generalroboticslab/Duke_Humanoid_V2_OpenSource/hardware-site/docs/before-you-start/what-you-get.md

# What you get

| Artefact | Status | Where |
| --- | --- | --- |
| Training and paper reproduction | published | [`duke_humanoid_v2_simulation`](https://github.com/generalroboticslab/duke_humanoid_v2_simulation) |
| Onboard control stack | published | [`duke_humanoid_v2_deploy`](https://github.com/generalroboticslab/duke_humanoid_v2_deploy) |
| Robot model (MJCF), meshes | published | `simulation/asset/duke_v2/humanoid_v21/` |
| Camera gimbal and gripper models | published | `head_cam/`, `parallel_gripper/` beside it |
| Code licence (Apache-2.0), `CITATION.cff` | published | each repository |
| Operator runbook, software safety contract | published | `deploy/control/docs/` |
| Power and data wiring diagrams | published | [Power system](../electrical/power-system.md), [CAN bus](../electrical/can-bus.md) |
| 9 exploded-view CAD animations (unlabelled) | published | Assembly pages |
| [Bill of materials](../bom/index.md) | **TODO**{ .dh-missing } partial | Fasteners and printed parts are placeholders |
| STEP files for machined parts | **TODO**{ .dh-missing } | [CAD downloads](../fabrication/cad-downloads.md) |
| Drawings, tolerances, finishes | **TODO**{ .dh-missing } | None for any machined part |
| STL/3MF and print profiles | **TODO**{ .dh-missing } | [Printing guide](../fabrication/printing-guide.md) |
| Fastener schedule, torque values | **TODO**{ .dh-missing } | Threadlocker only: Loctite 222 |
| Assembly instructions | **TODO**{ .dh-missing } partial | [Assembly](../assembly/index.md) |
| Harness drawings, connector pinouts | **TODO**{ .dh-missing } | Wiring diagrams are not harness drawings |
| Hardware and documentation licences | **TODO**{ .dh-missing } | [Citation and licence](../reference/citation-and-license.md) |
| Tagged release pinning all of the above | **TODO**{ .dh-missing } | [Revisions](../reference/revisions.md) |

!!! missing "MISSING — Scope: in or out for teleoperation setup, training workstation, mocap rig, test fixtures, perception cube targets and tripods, charging bench and gantry"
    *Owner: hardware lead.*
