generalroboticslab/Duke_Humanoid_V2_OpenSource/hardware-site/docs/files/drawings/duke_humanoid_v2_exploded_views_rev01.pdf

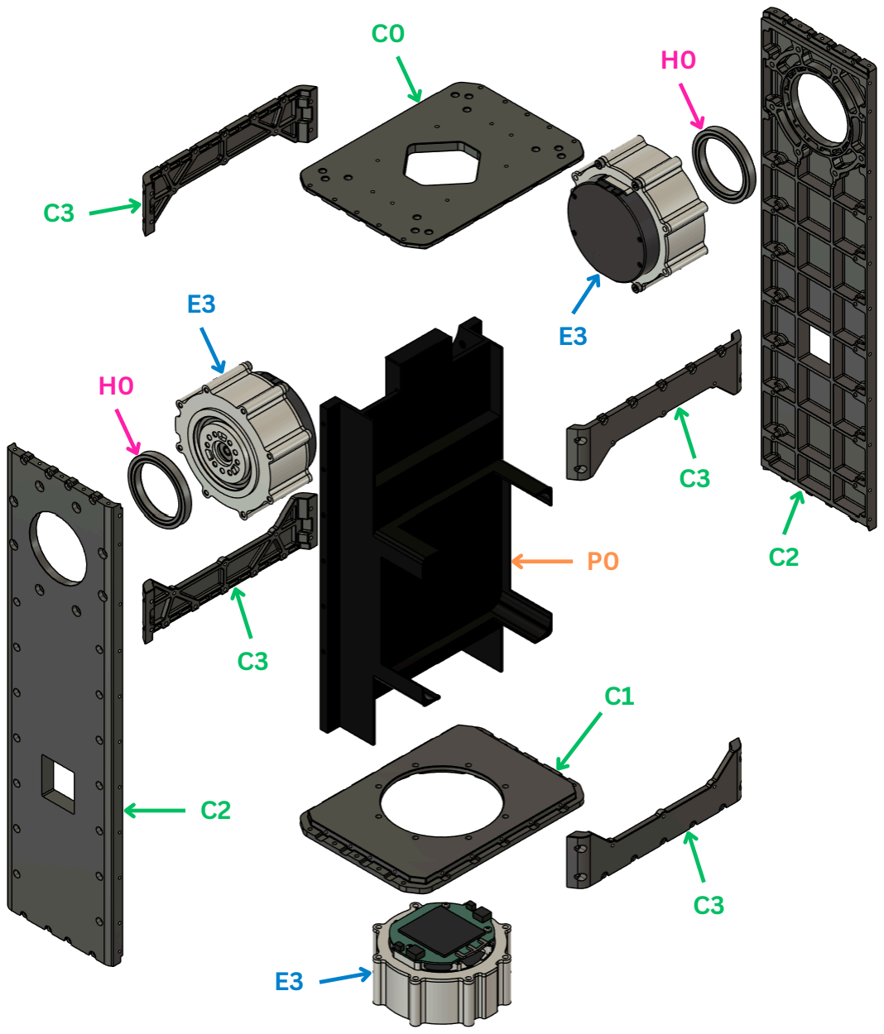
[picture p2: page 1]

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
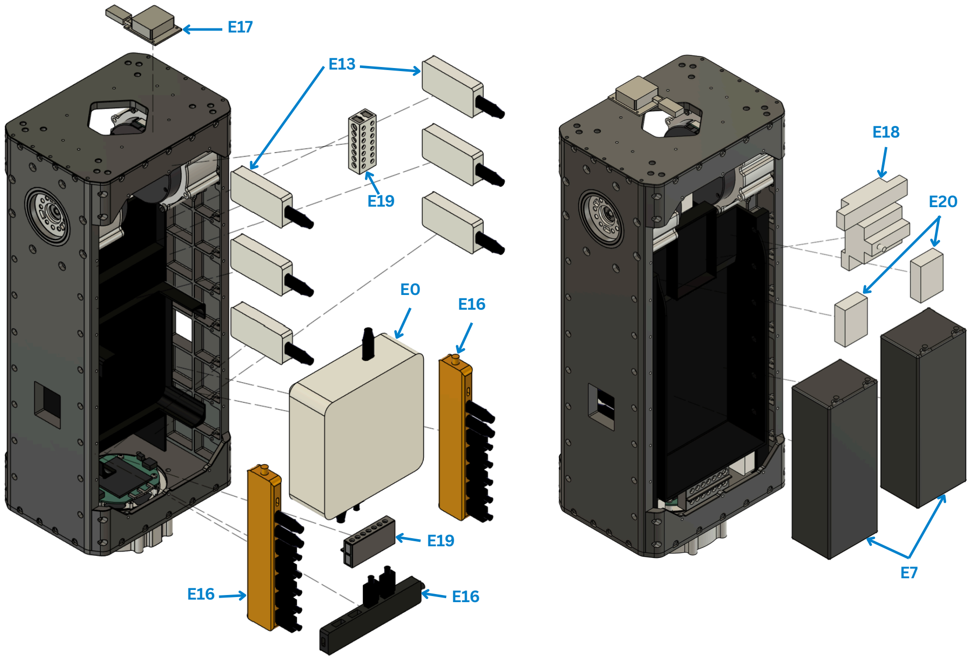
[picture p3: page 2]

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
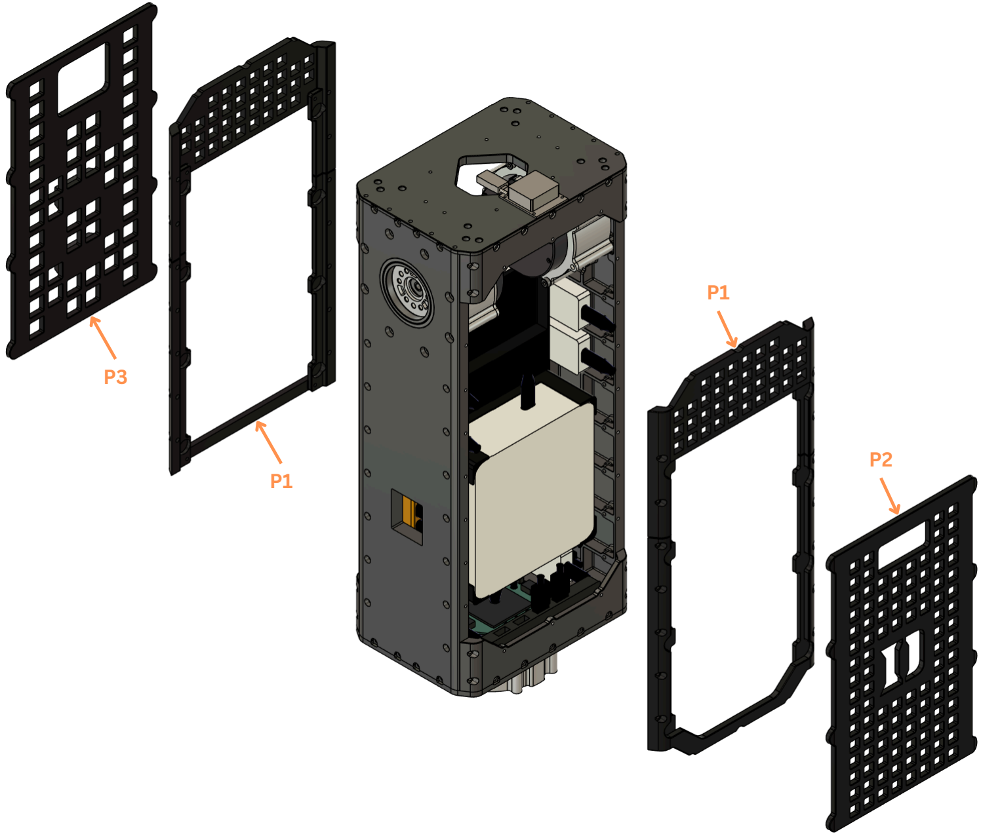
[picture p4: page 3]

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
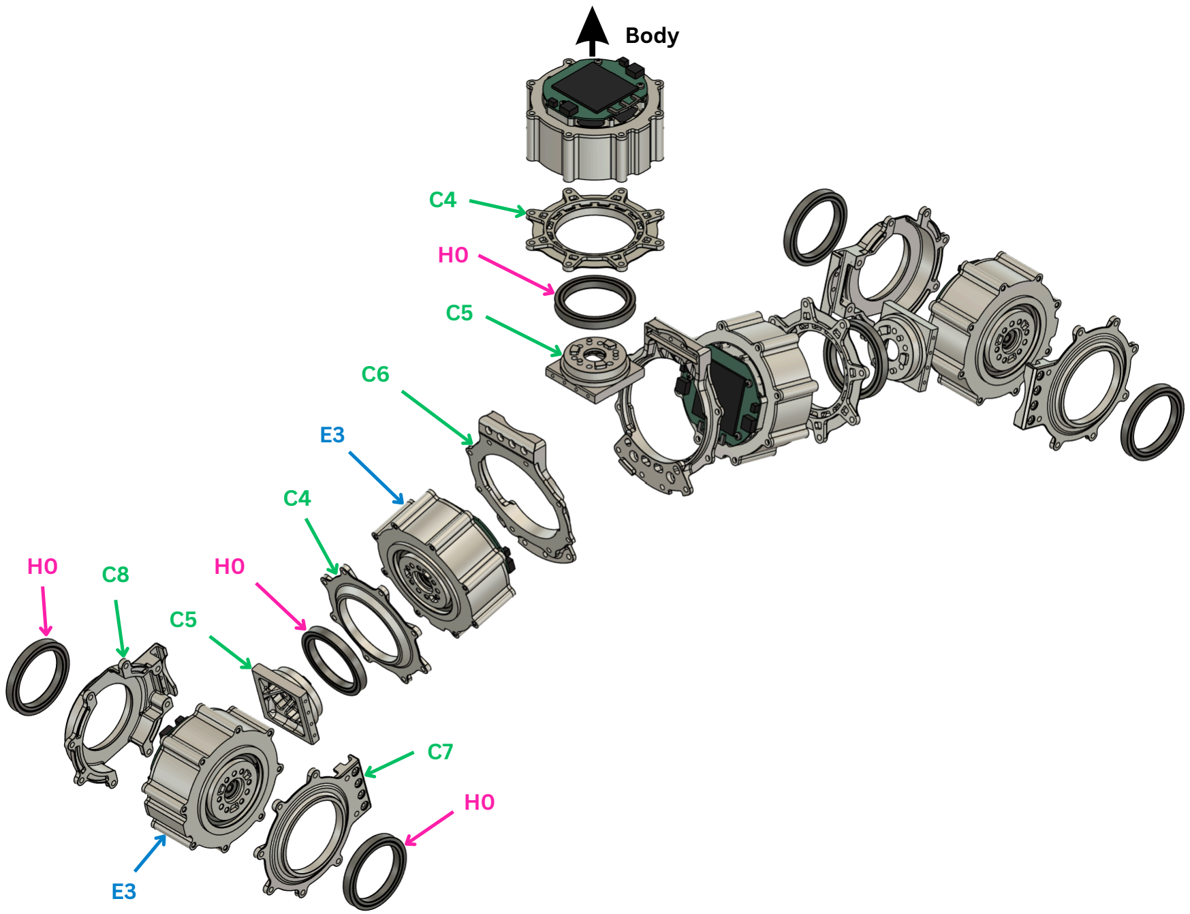
[picture p5: page 4]

Body

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
H C8 0

H0

H0

H0

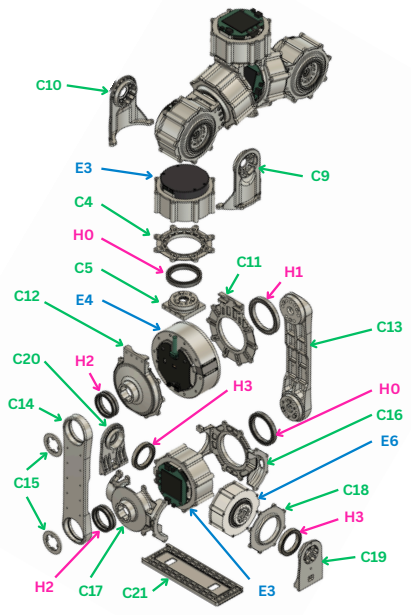
[picture p6: page 5]

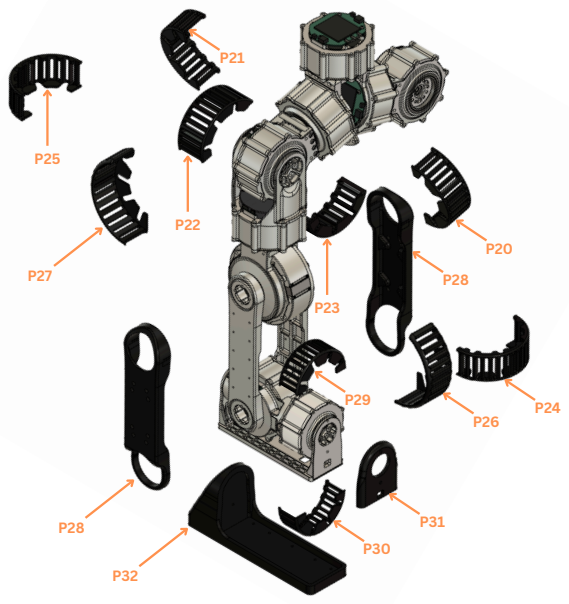
[picture p7: page 6]

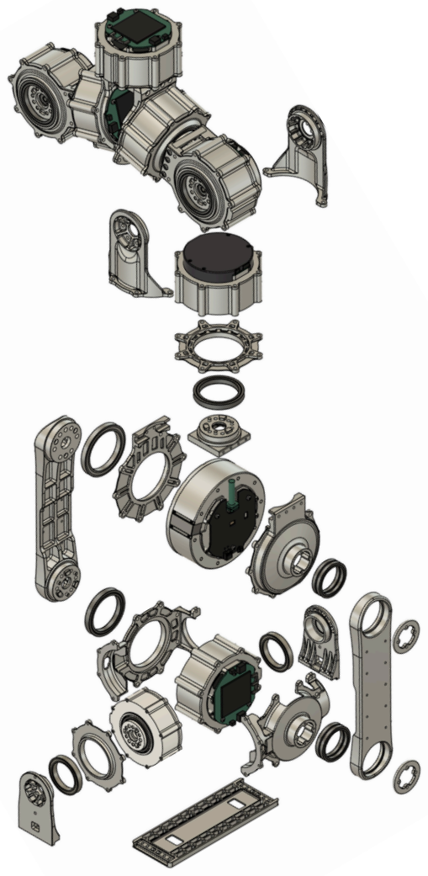
[picture p8: page 7]
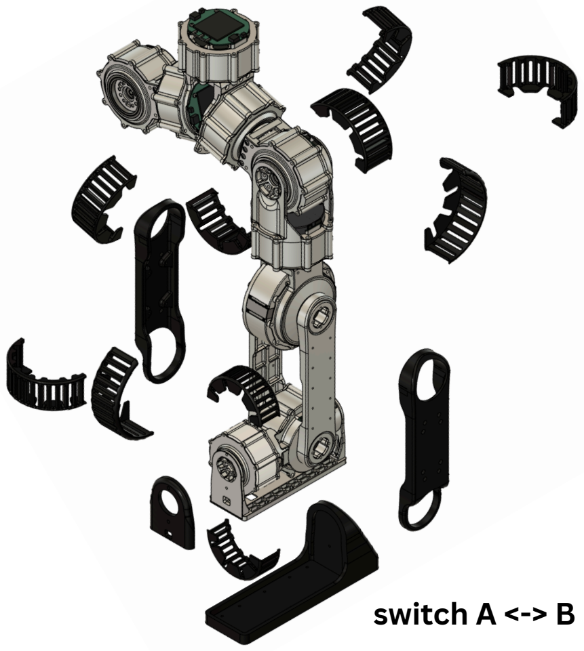
[picture p9: page 8]

# switch A <-> B

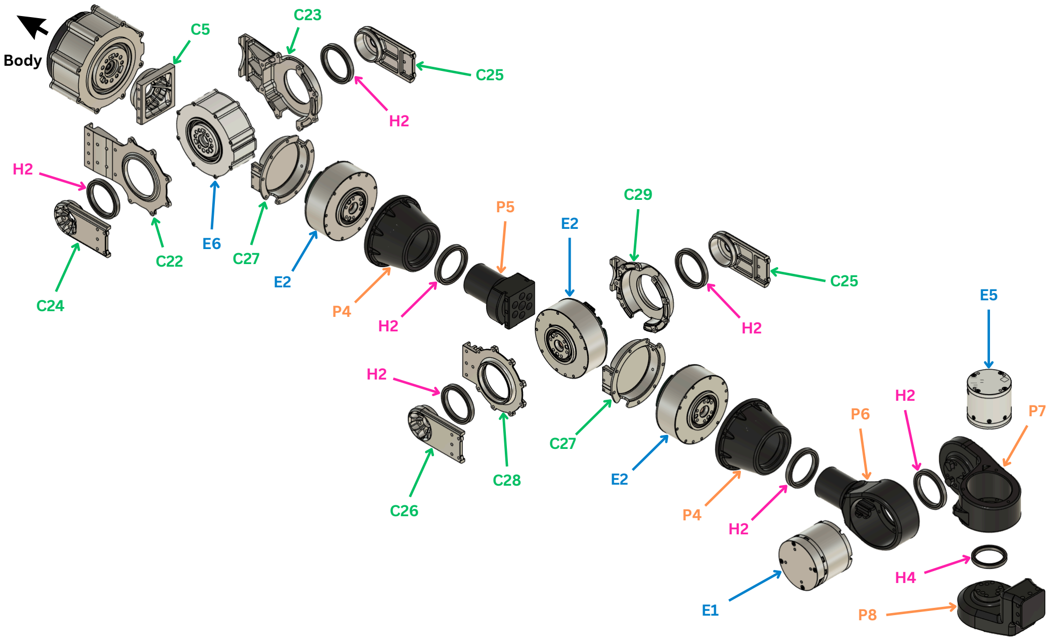
[picture p10: page 9]

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
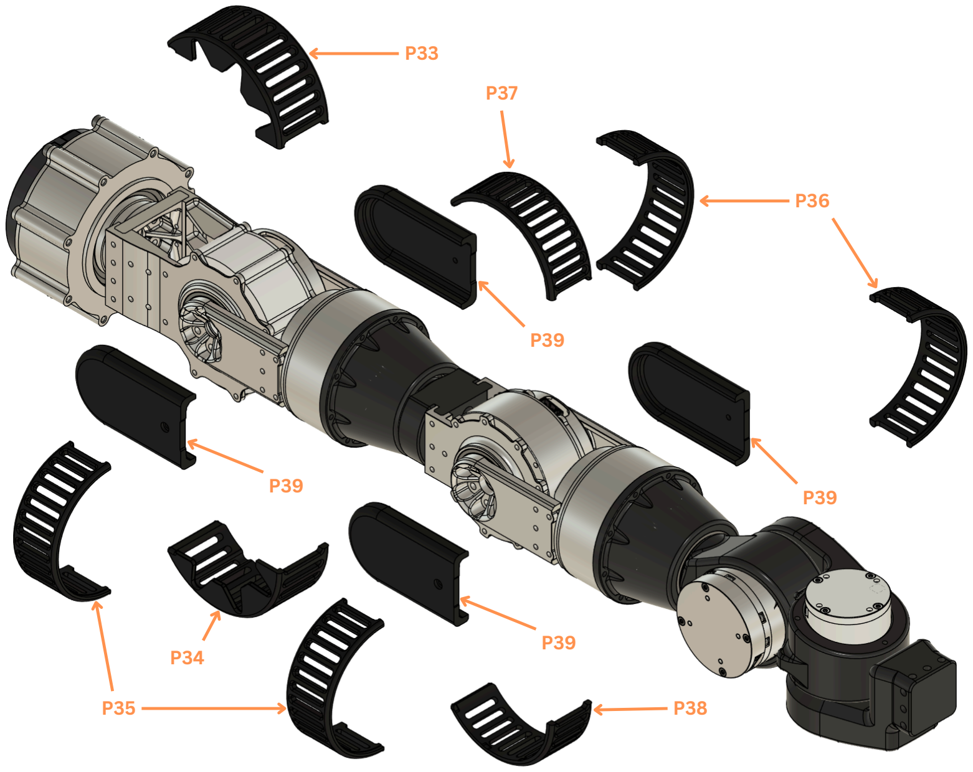
[picture p11: page 10]

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
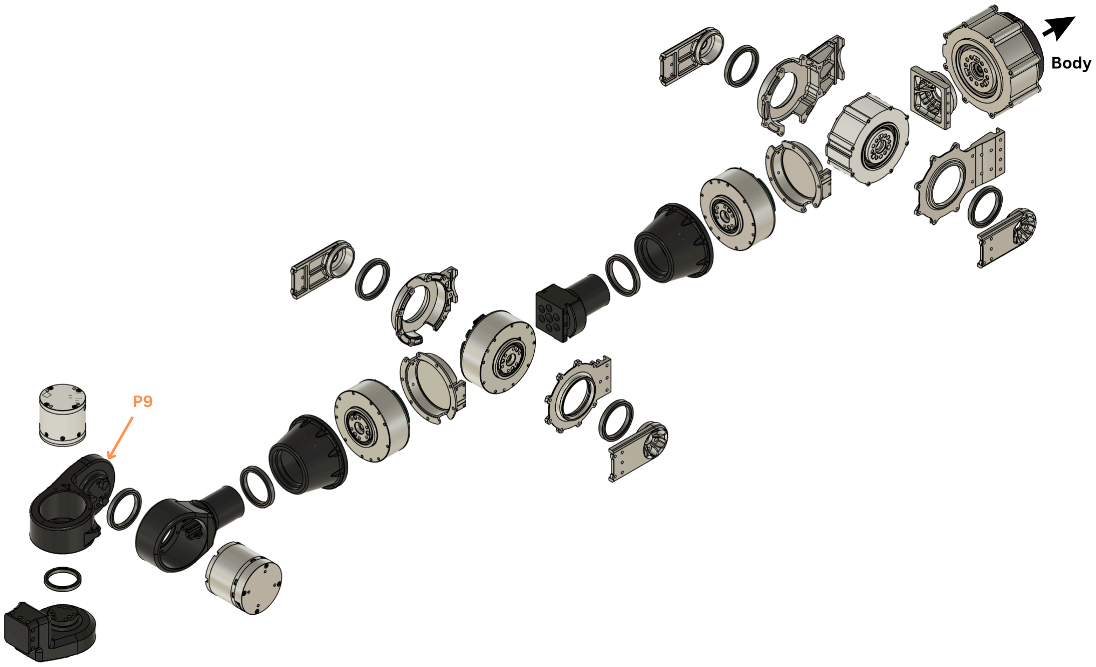
[picture p12: page 11]

B

o

d

y

P

9

# switch A <-> B

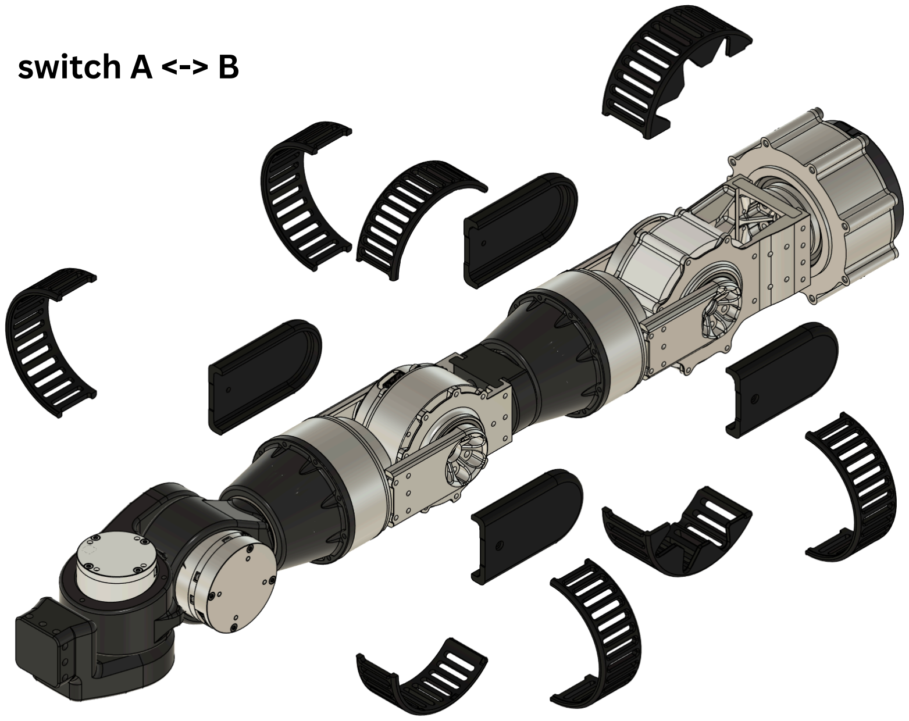
[picture p13: page 12]
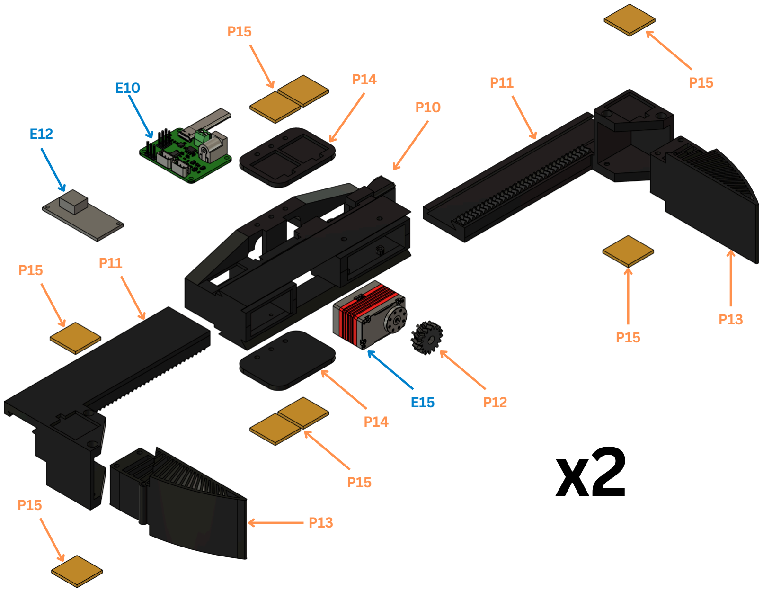
[picture p14: page 13]

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
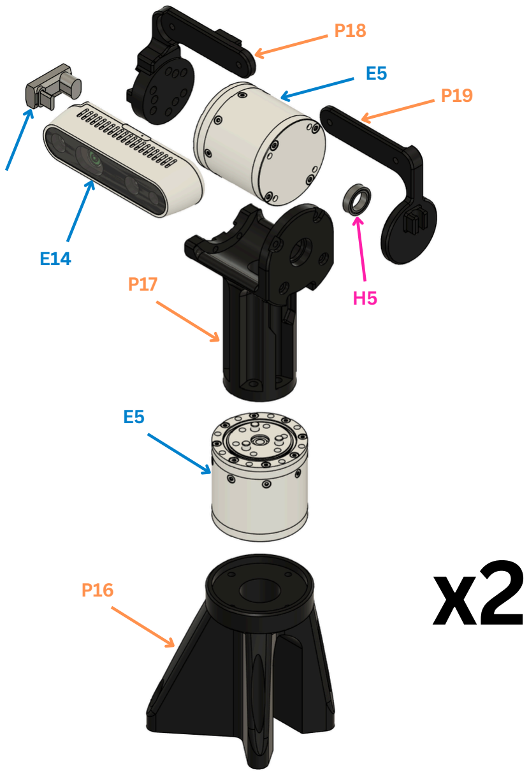
[picture p15: page 14]

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
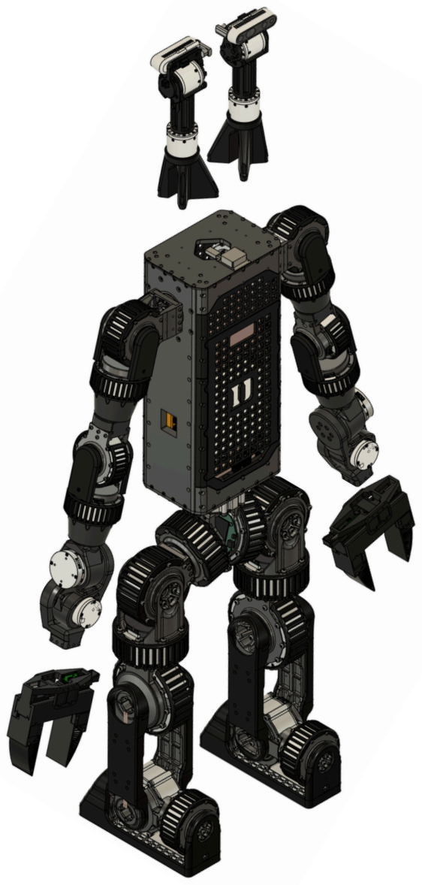
[picture p16: figure]
