generalroboticslab/Duke_Humanoid_V2_OpenSource/hardware-site/docs/assets/exploded/body-back-poster.webp

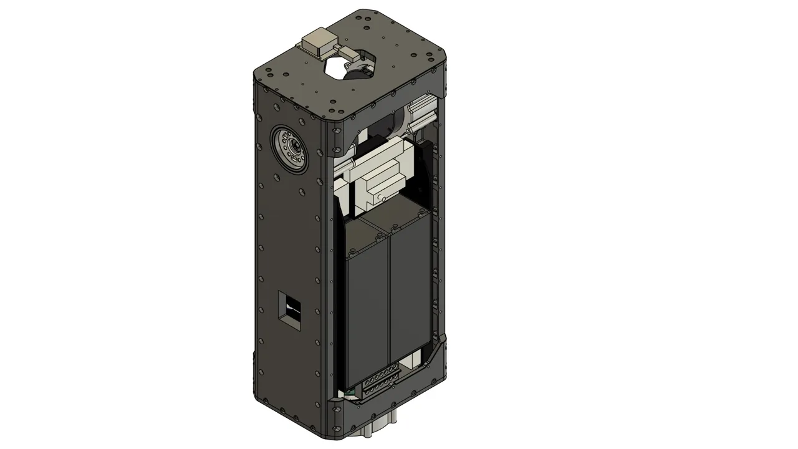
hardware-site/docs/assets/exploded/body-back-poster.webp
