generalroboticslab/Duke_Humanoid_V2_OpenSource/hardware-site/docs/assets/exploded/body-cover-poster.webp

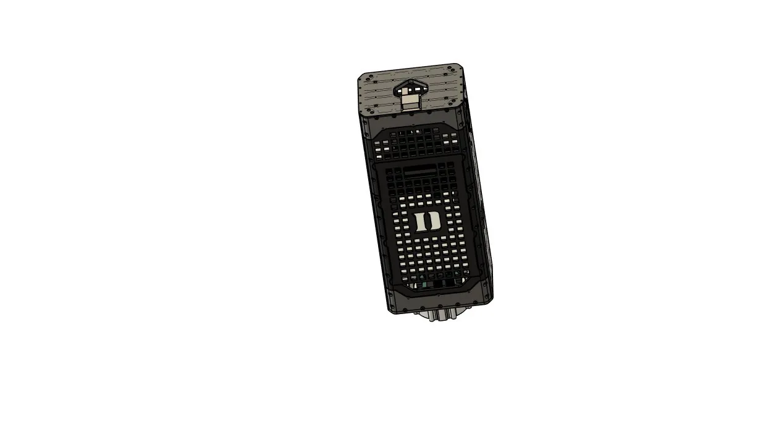
hardware-site/docs/assets/exploded/body-cover-poster.webp
