generalroboticslab/Duke_Humanoid_V2_OpenSource/hardware-site/docs/assets/exploded/camera-mount-poster.webp

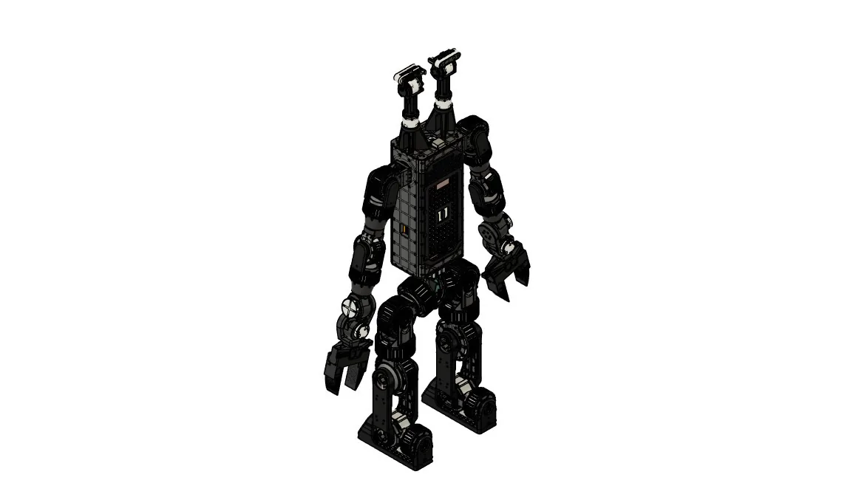
hardware-site/docs/assets/exploded/camera-mount-poster.webp
