generalroboticslab/Duke_Humanoid_V2_OpenSource/hardware-site/docs/assets/exploded/team/08-leg-mirror.webp

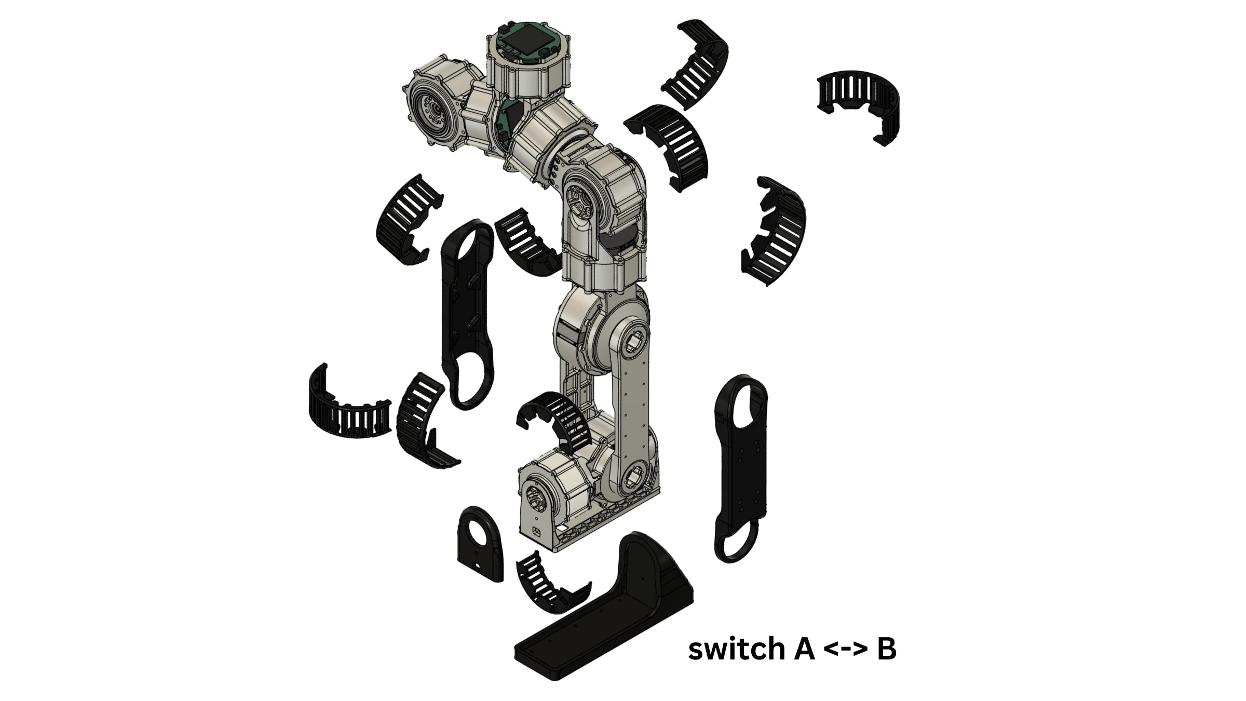
hardware-site/docs/assets/exploded/team/08-leg-mirror.webp
