generalroboticslab/Duke_Humanoid_V2_OpenSource/hardware-site/docs/assets/exploded/team/12-arm-mirror.webp

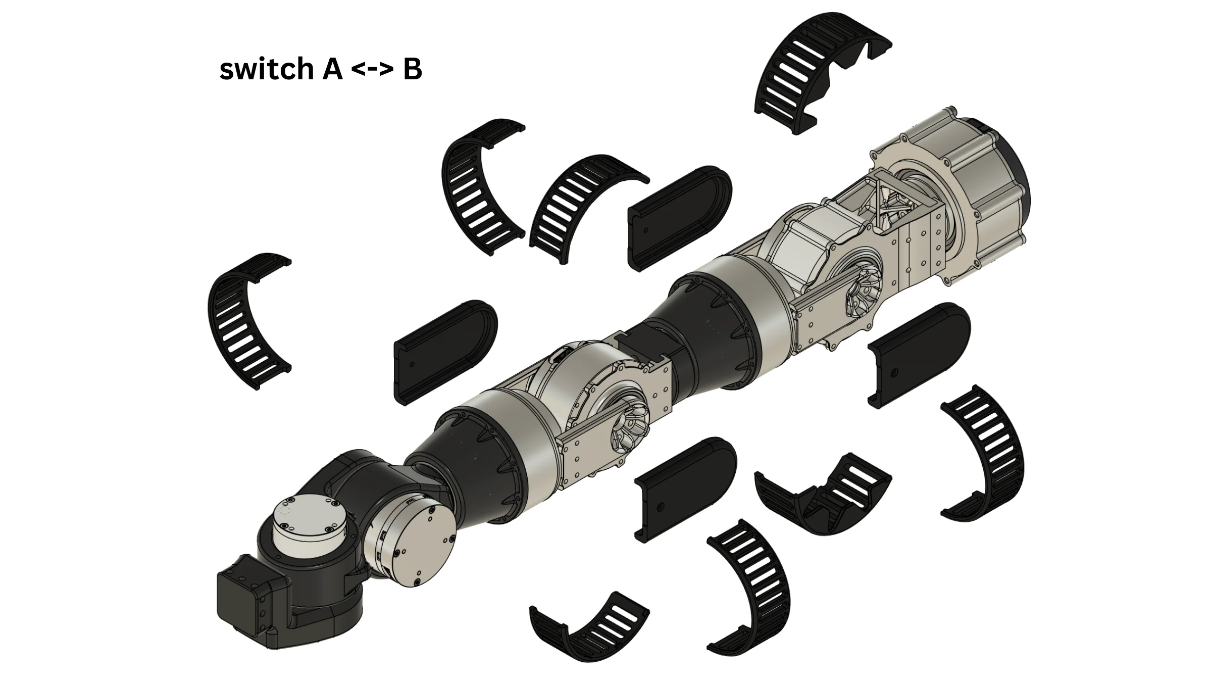
hardware-site/docs/assets/exploded/team/12-arm-mirror.webp
