generalroboticslab/Duke_Humanoid_V2_OpenSource/hardware-site/docs/assets/images/hardware.webp

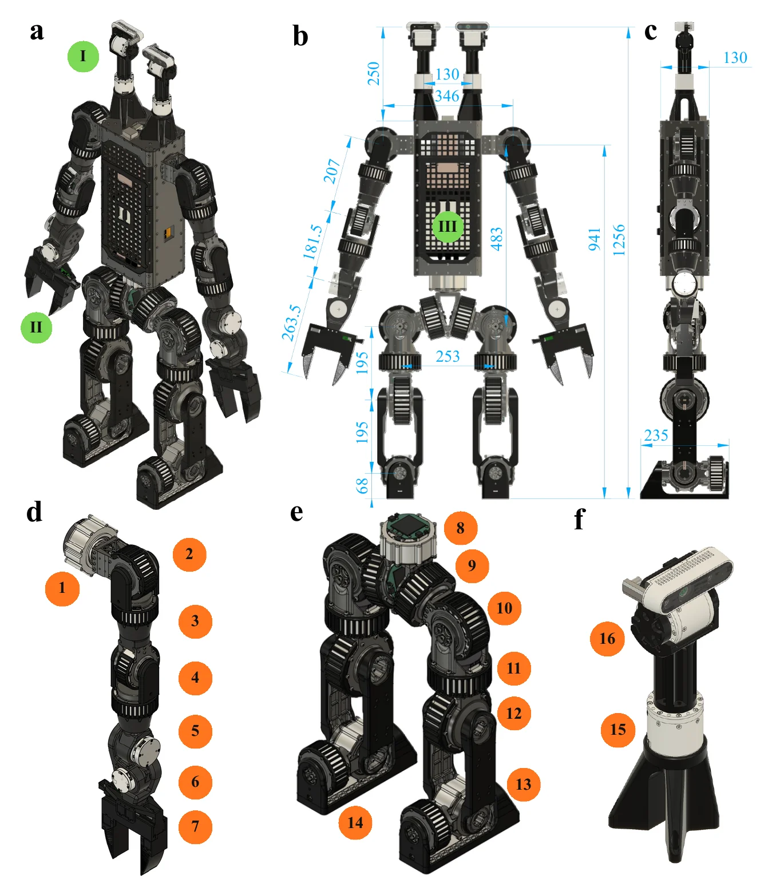
hardware-site/docs/assets/images/hardware.webp
