generalroboticslab/Duke_Humanoid_V2_OpenSource/reference/bom/Duke_Humanoid_V2_BOM_WIP.xlsx

Category | # | Item | Link | Unit Cost | Quantity | Total Cost | link | weight (check urdf) | price per unit weight
Electronics | E0 | MINISFORUM X1-470 Mini PC | https://www.amazon.com/MINISFORUM-X1-Pro-470-Quad-Display-Bluetooth/dp/B0GL2PPG67 | $1295.00 | 1 | $1295.00 | https://www.amazon.com/MINISFORUM-X1-Pro-470-Quad-Display-Bluetooth/dp/B0GL2PPG67
Electronics | E1 | Robstride 00 QDD Actuator | https://www.amazon.com/RobStride-14N-m-Integrated-Actuator-Module/dp/B0GS4XFK7Z/ | $125.00 | 2 | $250.00 | https://www.amazon.com/RobStride-14N-m-Integrated-Actuator-Module/dp/B0GS4XFK7Z/
Electronics | E2 | Robstride 02 QDD Actuator | https://www.amazon.com/RobStride-Integrated-Actuator-Module-Encoders/dp/B0GS5945VP | $145.00 | 6 | $870.00 | https://www.amazon.com/RobStride-Integrated-Actuator-Module-Encoders/dp/B0GS5945VP
Electronics | E3 | Robstride 03 QDD Actuator | https://www.amazon.com/RobStride-60N-m-Integrated-Actuator-Module/dp/B0GY8PJ1MF | $225.00 | 11 | $2475.00 | https://www.amazon.com/RobStride-60N-m-Integrated-Actuator-Module/dp/B0GY8PJ1MF
Electronics | E4 | Robstride 04 QDD Actuator | https://www.amazon.com/RobStride-120N-m-Integrated-Actuator-Module/dp/B0GY8T32L9 | $255.00 | 2 | $510.00 | https://www.amazon.com/RobStride-120N-m-Integrated-Actuator-Module/dp/B0GY8T32L9
Electronics | E5 | Robstride 05 QDD Actuator | https://aifitlab.com/products/robstride-05-motor | $110.00 | 6 | $660.00 | https://aifitlab.com/products/robstride-05-motor
Electronics | E6 | Robstride 06 QDD Actuator | https://aifitlab.com/products/robstride-06-motor | $210.00 | 2 | $420.00 | https://aifitlab.com/products/robstride-06-motor
Electronics | E7 | Zeee 6S Lipo Battery 10000mAh 22.2V x2 | https://zeeebattery.com/products/zeee-6s-lipo-battery-10000mah-22-2v-120c-ec5 | $367.00 | 1 | $367.00 | https://zeeebattery.com/products/zeee-6s-lipo-battery-10000mah-22-2v-120c-ec5
Electronics | E8 | TVS DIODE 53VWM 85VC | https://www.digikey.com/en/products/detail/microchip-technology/M1-5KE62CA/4349574 | $3.56 | 10 | $35.60 | https://www.digikey.com/en/products/detail/microchip-technology/M1-5KE62CA/4349574
Electronics | E9 | Belkin USB A to USB C Cable 2-Pack, 6.6ft | https://www.amazon.com/Belkin-USB-Cable-2-Pack-6-6ft/dp/B0F63XNWN3?th=1 | $14.99 | 2 | $29.98 | https://www.amazon.com/Belkin-USB-Cable-2-Pack-6-6ft/dp/B0F63XNWN3?th=1
Electronics | E10 | Serial Bus Servo Driver Board for ST/SC Series Serial Bus Servos | https://www.waveshare.com/product/robotics/drivers-sensors/drivers/bus-servo-adapter-a.htm | $4.99 | 2 | $9.98 | https://www.waveshare.com/product/robotics/drivers-sensors/drivers/bus-servo-adapter-a.htm
Electronics | E11 | DC 20V-60V to 12V Encased Buck Converter | https://www.amazon.com/gp/product/B0G2SV9PFY?th=1 | $18.99 | 1 | $18.99 | https://www.amazon.com/gp/product/B0G2SV9PFY?th=1
Electronics | E12 | 48V to 12V Buck Converter | https://www.aliexpress.us/item/3256809688561615.html?spm=a2g0o.detail.0.0.4fd9AhcQAhcQuZ | $2.70 | 2 | $5.40 | https://www.aliexpress.us/item/3256809688561615.html?spm=a2g0o.detail.0.0.4fd9AhcQAhcQuZ
Electronics | E13 | CANable PRO V2.0 USBCAN Controller | https://www.amazon.com/Macrobase-PRO-V2-0-Controller-transceiver/dp/B0GJSRZLBV/ | $20.80 | 6 | $124.80 | https://www.amazon.com/Macrobase-PRO-V2-0-Controller-transceiver/dp/B0GJSRZLBV/
Electronics | E14 | RealSense Depth Camera D436 | https://store.realsenseai.com/buy-intel-realsense-depth-camera-d436.html | $354.00 | 2 | $708.00 | https://store.realsenseai.com/buy-intel-realsense-depth-camera-d436.html
Electronics | E15 | Feetech HL-3915-C001 12V 14.2Kg Servo | https://aifitlab.com/products/feetech-hl-3915-servo-motor?variant=44326557417608 | $50.00 | 2 | $100.00 | https://aifitlab.com/products/feetech-hl-3915-servo-motor?variant=44326557417608
Electronics | E16 | Vention USB Hub | https://www.amazon.com/VENTION-Splitter-Expander-Chromebook-Surface/dp/B0D2XWJ99H | $12.99 | 3 | $38.97 | https://www.amazon.com/VENTION-Splitter-Expander-Chromebook-Surface/dp/B0D2XWJ99H
Electronics | E17 | IMU | https://www.robotshop.com/products/syd-dynamics-transducerm-tm171-9-axis-ahrs-w-dual-port-communication | $57.00 | 1 | $57.00 | https://www.robotshop.com/products/syd-dynamics-transducerm-tm171-9-axis-ahrs-w-dual-port-communication
Electronics | E18 | TTocas Surge Protector | https://www.amazon.com/stores/TTocas/page/CAFB5466-628D-45E8-B728-7DB6F3AD931F | $22.99 | 1 | $22.99 | https://www.amazon.com/stores/TTocas/page/CAFB5466-628D-45E8-B728-7DB6F3AD931F
Electronics | E19 | Power Distribution Block Terminals | https://www.aliexpress.us/item/3256808232612352.html | $0.53 | 4 | $2.12 | https://www.aliexpress.us/item/3256808232612352.html
Electronics | E20 | Voltage Sensor for LiPo | https://epowerhobby.com/product/lipo-voltage-checker-1-8s-with-case/ | $14.50 | 2 | $29.00 | https://epowerhobby.com/product/lipo-voltage-checker-1-8s-with-case/
CNC | C0 | Body Plate - Top |  | $64.53 | 1 | $64.53
CNC | C1 | Body Plate - Bottom |  | $64.03 | 1 | $64.03
CNC | C2 | Body Plate - Side |  | $109.14 | 2 | $218.28
CNC | C3 | Body Plate - Front/Back |  | $47.08 | 4 | $188.32
CNC | C4 | Robstride 03 Bearing Retainer |  | $49.34 | 5 | $246.70
CNC | C5 | Robstride 03 Output Shaft |  | $46.78 | 7 | $327.50
CNC | C6 | Hip 1 Motor Bracket |  | $81.59 | 2 | $163.18
CNC | C7 | Hip 2 Motor Bracket |  | $48.59 | 2 | $97.18
CNC | C8 | Hip 2 Bearing Retainer |  | $68.02 | 2 | $136.04
CNC | C9 | Hip 3 Output Shaft |  | $59.96 | 2 | $119.92
CNC | C10 | Hip 3 Supporting Shaft |  | $57.43 | 2 | $114.86
CNC | C11 | Knee Motor Bracket |  | $54.81 | 2 | $109.62
CNC | C12 | Knee Bearing Retainer |  | $81.35 | 2 | $162.70
CNC | C13 | Shank Shaft |  | $113.29 | 2 | $226.58
CNC | C14 | Shank Support |  | $50.05 | 2 | $100.10
CNC | C15 | Shank Joint Cap |  | $16.50 | 4 | $66.00
CNC | C16 | Ankle Motor Bracket |  | $78.82 | 2 | $157.64
CNC | C17 | Ankle Bearing Retainer |  | $95.85 | 2 | $191.70
CNC | C18 | Robstride 06 Bearing Retainer |  | $37.81 | 2 | $75.62
CNC | C19 | Foot Shaft |  | $39.40 | 2 | $78.80
CNC | C20 | Foot Support |  | $34.60 | 2 | $69.20
CNC | C21 | Foot |  | $53.76 | 2 | $107.52
CNC | C22 | Shoulder Motor Bracket |  | $46.69 | 2 | $93.38
CNC | C23 | Shoulder Bearing Retainer |  | $99.24 | 2 | $198.48
CNC | C24 | Shoulder Shaft |  | $31.72 | 2 | $63.44
CNC | C25 | Shoulder/Elbow Support |  | $57.56 | 4 | $230.24
CNC | C26 | Elbow Shaft |  | $31.42 | 2 | $62.84
CNC | C27 | Shoulder/Elbow Coupler |  | $54.25 | 4 | $217.00
CNC | C28 | Elbow Motor Bracket |  | $57.94 | 2 | $115.88
CNC | C29 | Elbow Bearing Retainer |  | $65.65 | 2 | $131.30
3DP | P0 | PC Mount, PLA |  | $3.96 | 1 | $3.96 |  | 0.3175725 | 12.47 | 3.960129075
3DP | P1 | Body Cover, PLA |  | $0.92 | 2 | $1.84 |  | 0.073888034 | 12.47 | 0.921383784
3DP | P2 | Front Plate, PLA |  | $1.21 | 1 | $1.21 |  | 0.096876586 | 12.47 | 1.208051027
3DP | P3 | Back Plate, PLA |  | $1.42 | 1 | $1.42 |  | 0.113809991 | 12.47 | 1.419210588
3DP | P4 | Arm Shaft Cover, Nylon 12 |  | $7.06 | 4 | $28.22 |  | 0.070624732 | 99.9 | 7.055410727
3DP | P5 | Elbow Shaft Coupler, Nylon 12 |  | $6.45 | 2 | $12.91 |  | 0.064589607 | 99.9 | 6.452501739
3DP | P6 | Wrist Shaft, Nylon 12 |  | $7.20 | 2 | $14.41 |  | 0.072102192 | 99.9 | 7.203008981
3DP | P7 | Wrist Housing R, Nylon 12 |  | $13.78 | 1 | $13.78 |  | 0.137950732 | 99.9 | 13.78127813
3DP | P8 | Wrist Output, Nylon 12 |  | $13.01 | 2 | $26.02 |  | 0.130220812 | 99.9 | 13.00905912
3DP | P9 | Wrist Housing L, Nylon 12 |  | $13.78 | 1 | $13.78 |  | 0.137950732 | 99.9 | 13.78127813
3DP | P10 | Gripper Housing, PLA |  | $0.96 | 2 | $1.91 |  | 0.07666666 | 12.47 | 0.9560332502
3DP | P11 | Gripper Rack, PLA |  | $0.56 | 4 | $2.24 |  | 0.044855 | 12.47 | 0.55934185
3DP | P12 | Gear, Nylon 12 |  | $0.13 | 2 | $0.26 |  | 0.00129 | 99.9 | 0.128871
3DP | P13 | UMI Fingers, TPU |  | $0.42 | 4 | $1.69 |  | 0.03395 | 12.47 | 0.4233565
3DP | P14 | AprilTag Housing, PLA |  | $0.04 | 4 | $0.16 |  | 0.003264 | 12.47 | 0.04070208
3DP | P15 | AprilTags, PLA |  | $0.02 | 12 | $0.21 |  | 0.0014 | 12.47 | 0.017458
3DP | P16 | Gimbal Base, PLA |  | $0.65 | 2 | $1.30 |  | 0.05198 | 12.47 | 0.6481906
3DP | P17 | Gimbal Neck, PLA |  | $0.47 | 2 | $0.94 |  | 0.037643 | 12.47 | 0.46940821
3DP | P18 | Gimbal Shaft, PLA |  | $0.16 | 2 | $0.31 |  | 0.012475 | 12.47 | 0.15556325
3DP | P19 | Gimbal Support, PLA |  | $0.15 | 2 | $0.30 |  | 0.012103 | 12.47 | 0.15092441
3DP | P20 | Hip 1 Protection - A, TPU |  | $1.09 | 2 | $2.18 |  | 0.031094 | 34.99 | 1.08797906
3DP | P21 | Hip 1 Protection - B, TPU |  | $1.09 | 2 | $2.18 |  | 0.031094 | 34.99 | 1.08797906
3DP | P22 | Hip 2 Protection - A, TPU |  | $0.91 | 2 | $1.82 |  | 0.025962 | 34.99 | 0.90841038
3DP | P23 | Hip 2 Protection - B, TPU |  | $0.91 | 2 | $1.82 |  | 0.025962 | 34.99 | 0.90841038
3DP | P24 | Hip 3 Protection - A, TPU |  | $1.09 | 2 | $2.18 |  | 0.031094 | 34.99 | 1.08797906
3DP | P25 | Hip 3 Protection - B, TPU |  | $1.09 | 2 | $2.18 |  | 0.031094 | 34.99 | 1.08797906
3DP | P26 | Knee Protection - A, TPU |  | $0.92 | 2 | $1.83 |  | 0.026159 | 34.99 | 0.91530341
3DP | P27 | Knee Protection - B, TPU |  | $0.92 | 2 | $1.83 |  | 0.026159 | 34.99 | 0.91530341
3DP | P28 | Shank Protection, TPU |  | $1.56 | 4 | $6.26 |  | 0.044714 | 34.99 | 1.56454286
3DP | P29 | Foot Protection - Top, TPU |  | $0.58 | 2 | $1.17 |  | 0.016691 | 34.99 | 0.58401809
3DP | P30 | Foot Protection - Bot, TPU |  | $0.58 | 2 | $1.17 |  | 0.016691 | 34.99 | 0.58401809
3DP | P31 | Foot Protection - Front, TPU |  | $0.49 | 2 | $0.97 |  | 0.013896 | 34.99 | 0.48622104
3DP | P32 | Foot Protection - Sole, TPU |  | $4.14 | 2 | $8.28 |  | 0.118364 | 34.99 | 4.14155636
3DP | P33 | Shoulder 2 Protection - A, TPU |  | $0.44 | 2 | $0.87 |  | 0.012454 | 34.99 | 0.43576546
3DP | P34 | Shoulder 2 Protection - B, TPU |  | $0.44 | 2 | $0.87 |  | 0.012454 | 34.99 | 0.43576546
3DP | P35 | Arm Roll Protection - Front, TPU |  | $0.29 | 4 | $1.16 |  | 0.008313 | 34.99 | 0.29087187
3DP | P36 | Arm Roll Protection - Back, TPU |  | $0.29 | 4 | $1.16 |  | 0.008313 | 34.99 | 0.29087187
3DP | P37 | Elbow Protection - A, TPU |  | $0.21 | 2 | $0.43 |  | 0.006124 | 34.99 | 0.21427876
3DP | P38 | Elbow Protection - B, TPU |  | $0.21 | 2 | $0.43 |  | 0.006124 | 34.99 | 0.21427876
3DP | P39 | Arm Roll Shaft Protection, TPU |  | $0.27 | 8 | $2.13 |  | 0.007623 | 34.99 | 0.26672877
Hardware | H0 | 45x58x7 Ball Bearing | https://www.amazon.com/XIKE-6809-2RS-Bearings-45x58x7mm-Pre-Lubricated/dp/B09D2J9P82 | $3.00 | 13 | $39.00
Hardware | H1 | 50x65x7 Ball Bearing | https://www.amazon.com/uxcell-6810-2RS-Groove-Bearings-Double/dp/B082PYMQFL | $4.00 | 2 | $8.00
Hardware | H2 | 35x44x5 Ball Bearing | https://www.amazon.com/XIKE-6707-2RS-Bearings-35x44x5mm-Pre-Lubricated/dp/B09D2XN464/ | $3.00 | 18 | $54.00
Hardware | H3 | 35x47x7 6807-2RS Ball Bearing | https://www.amazon.com/XIKE-6807-2RS-Bearings-35x47x7mm-Pre-Lubricated/dp/B09D2ZHNPH/ | $4.00 | 4 | $16.00
Hardware | H4 | 30x37x4 6706-2RS Ball Bearing | https://www.amazon.com/XIKE-6706-2RS-Bearings-30x37x4mm-Pre-Lubricated/dp/B09D35XB19 | $2.00 | 2 | $4.00
Hardware | H5 | 10x15x4 Ball Bearing | https://www.amazon.com/uxcell-6700-2RS-Groove-Bearings-Double/dp/B082PR3DFZ | $1.00 | 2 | $2.00
Hardware | H6 | M3x10 Torx Button Head Screw | https://www.mcmaster.com/90991A114/ | $5.16 | 5 | $25.80
Hardware | H7 | M4x8 Torx Button Head Screw | https://www.mcmaster.com/90991A121/ | $7.20 | 1 | $7.20
Hardware | H8 | M4x10 Torx Button Head Screw | https://www.mcmaster.com/90942A118/ | $5.78 | 4 | $23.12
Calibration |  |  |  |  |  | $0.00
SUM |  |  |  | $12575.30 | 299 | $12575.30
