generalroboticslab/Duke_Humanoid_V2_OpenSource/reference/bom/duke-humanoid-v2_BOM.xlsx

Sheet: Sheet1
 | ITEM | LINK (shortened if possible) | UNIT COST | QUANTITY | TOTAL
ELECTRONICS | MINISFORUM X1-470 Mini PC | amazon.com/MINISFORUM-Desktop-Computer-HDMI2-1-Graphics/dp/B0GM43XCGT | $1295.00 | 1 | $1295.00
 | Robstride 00 QDD Actuator | https://www.robstride.com/products/robStride00 | $125 | 2 | $250.00
 | Robstride 02 QDD Actuator | https://www.robstride.com/products/robStride02 | $145 | 6 | $870.00
 | Robstride 03 QDD Actuator | https://www.robstride.com/products/robStride03 | $225 | 11 | $2475.00
 | Robstride 04 QDD Actuator | https://www.robstride.com/products/robStride04 | $255 | 2 | $510.00
 | Robstride 05 QDD Actuator | https://www.robstride.com/products/robStride05 | $110 | 6 | $660.00
 | Robstride 06 QDD Actuator | https://www.robstride.com/products/robStride06 | $210 | 4 | $840.00
 | Zeee 6S Lipo Battery 10000mAh 22.2V x2 | https://www.amazon.com/dp/B0BHQX8XQX?lv=shuf&channelId=500&plpRedirect=mhFallback | $306.00 | 1 | $306.00
 | TVS DIODE 53VWM 85VC | https://www.digikey.com/en/products/detail/microchip-technology/M1-5KE62CA/4349574 | $3.56 | 10 | $35.60
 | Belkin USB A to USB C Cable 2-Pack, 6.6ft | https://www.amazon.com/Belkin-USB-Cable-2-Pack-6-6ft/dp/B0F63XNWN3?th=1 | $14.99 | 2 | $29.98
 | Serial Bus Servo Driver Board for ST/SC Series Serial Bus Servos | https://www.waveshare.com/product/robotics/drivers-sensors/drivers/bus-servo-adapter-a.htm | $4.99 | 2 | $9.98
 | DC 20V-60V to 12V Encased Buck Converter | https://www.amazon.com/gp/product/B0G2SV9PFY?th=1 | $18.99 | 1 | $18.99
 | 48V to 12V Buck Converter | https://www.aliexpress.us/item/3256809688561615.html?spm=a2g0o.detail.0.0.4fd9AhcQAhcQuZ | $2.70 | 2 | $5.40
 | CANable PRO V2.0 USBCAN Controller | https://www.amazon.com/Macrobase-PRO-V2-0-Controller-transceiver/dp/B0GJSRZLBV/ | $20.80 | 6 | $124.80
 | RealSense Depth Camera D436 | https://store.realsenseai.com/buy-intel-realsense-depth-camera-d436.html | $354 | 2 | $708.00
 | Feetech HL-3915-C001 12V 14.2Kg Servo | https://aifitlab.com/products/feetech-hl-3915-servo-motor?variant=44326557417608 | $50 | 2 | $100.00
 | Vention USB Hub | https://www.amazon.com/VENTION-Splitter-Expander-Chromebook-Surface/dp/B0D2XWJ99H | $12.99 | 3 | $38.97
 | IMU | https://www.robotshop.com/products/syd-dynamics-transducerm-tm171-9-axis-ahrs-w-dual-port-communication | $57 | 1 | $57.00
HARDWARE | example: fasteners, nuts |  |  |  | $0.00
 | 5PCS Amass XT30(2+2). select Color (fist option): XT30U(2 2)-F | https://www.aliexpress.us/item/3256807585110718.html | $5.00 | 4 | $20.00
 | Frienda 30 Pairs XT30 Connectors Male and Female Connectors Plugs Set | https://www.amazon.com/Connectors-Female-Pieces-Shrink-Battery/dp/B0BB2XF5SQ?th=1 | $14.99 | 1 | $14.99
 | Alex Tech 25ft - 1/4 inch Cord Protector Wire Loom Tubing Cable Sleeve | https://www.amazon.com/Alex-Tech-10ft-Protector-Sleeving/dp/B07FW86XV6/?th=1 | $13.99 | 1 | $13.99
 | Alex Tech 25ft - 3/8 inch Cord Protector Wire Loom Tubing Cable Sleeve | https://www.amazon.com/Alex-Tech-25ft-Protector-Sleeving/dp/B07FW4M7Z8/?th=1 | $15.98 | 1 | $15.98
 | Duttek Short USB C Extension Cable 40Gbps | https://www.amazon.com/dp/B0CWGW3LTJ?th=1 | $9.76 | 2 | $19.52
 | USB A to USB C 3.1 Gen 2 Cable | https://www.amazon.com/Transfer-Charging-Samsung-SanDisk-Portable/dp/B09H2LLXPN?th=1 | $9.99 | 6 | $59.94
 | 1ft Short USB-C Cable with Right-Angle Plug | https://www.amazon.com/Afterplug-Right-Angle-Charging-Ultra-Flexible-Silicone/dp/B0G2LVGZ39 | $12.99 | 1 | $12.99
MATERIALS | CNC Leg Parts | TODO: BREAK INTO INDIVIDUAL CNC PARTS
 | CNC Arm Parts
 | CNC Body Parts
 | TPU
 | PLA
 | Nylon Powder for SLS
 |  |  |  | TOTAL CNC | 6389.86
 |  |  |  | GRAND TOTAL | $14881.99

Sheet: Sheet2
CNC_leg18_x2_foot_plate | 107.52 | 2pcs | 2076.98
CNC_leg17_x2_ankle_roll_support_shaft | 69.2 | 2 | 1374.19
CNC_leg05_x2_hip_roll_back_bearing_retainer | 136.04 | 2 | $1317.87
CNC_leg03_x5_RS03_shaft_bearing_retainer | 246.7 | 5 | $1620.82
CNC_leg06_x2_hip_roll_output_shaft | 119.92 | 2 | 6389.86
CNC_leg11_x2_knee_support_shank | 100.1 | 2
CNC_leg10_x2_knee_output_shank | 226.58 | 2
CNC_leg15_x2_RS06_shaft_bearing_retainer | 75.62 | 2
CNC_leg13_x2_ankle_pitch_front | 157.64 | 2
CNC_leg04_x2_hip_roll_front_bearing_retainer | 97.18 | 2
CNC_leg07_x2_hip_roll_support_shaft | 114.86 | 2
CNC_leg08_x2_knee_front_bearing_retainer | 109.62 | 2
CNC_leg16_x2_ankle_roll_output_shaft | 78.8 | 2
CNC_leg01_x2_hip_center_back | 163.18 | 2
CNC_leg02_x7_RS03_shaft_coupler | 274.02 | 6
CNC_arm13_x2_RS05_shaft_coupler | 109.8 | 3
CNC_leg14_x2_ankle_pitch_back | 191.7 | 2
CNC_leg09_x2_knee_motor_back_cover | 162.7 | 2
CNC_arm06_x4_RS02_shaft_coupler | $146.76 | 4
CNC_arm04_x4_shoulder_roll_support_shaft | $115.12 | 4
CNC_body03_x1_top_plate | $64.53 | 1
CNC_arm05_x4_RS02_shaft_bearing | $123.08 | 4
CNC_arm03_x2_shoulder_roll_output_shaft | $63.44 | 2
CNC_body02_x2_side_plate | $218.28 | 2
CNC_leg02_x7_RS03_shaft_coupler | $100.26 | 2
CNC_body04_x4_front_plate | $188.32 | 4
CNC_arm11_x2_wrist_roll | $239.58 | 2
CNC_arm10_x4_r03_back_cover | $217.00 | 4
CNC_arm09_x2_elbow_output_shaft | $62.84 | 2
CNC_body01_x1_bottom_plate | $64.03 | 1
CNC_arm01_x2_shoulder_roll_front_bearing | $93.38 | 2
CNC_arm08_x2_elbow_back_bearing | $131.30 | 2
CNC_arm12_x2_wrist_pitch | $192.52 | 2
CNC_arm07_x2_elbow_front_bearing | $115.88 | 2
CNC_arm02_x2_shoulder_roll_back_bearing | $198.48 | 2
CNC_leg12_x4_lower_leg_bearing | $82.50 | 5
02_hip_0_m04_back_bracket_x2 | $159.94 | 2
B6_single_leg_tester_plate | $101.38 | 1
08_hip_1_back_shaft_x2 | $37.93 | 1
B5_body_shelf | $93.71 | 1
13_knee_front_shaft_x2 | $60.82 | 1
17_ankle_0_back_cover_x2 | $76.78 | 1
15_ankle_cap_x4 | $38.64 | 2
B1_body_base_plate | $95.01 | 1
05_hip_1_front_bracket_x2 | $49.62 | 1
18_ankle_1_back_retainer_x2 | $23.37 | 1
22_foot_plate_x2 | $22.48 | 1
12_knee_m04_back_cover_x2 | $72.92 | 1
21_ankle_1_front_shaft_x4 | $75.00 | 2
04_hip_1_m04_shaft_x2 | $41.28 | 1
06_hip_1_back_bracket_x2 | $70.42 | 1
09_hip_2_back_cover_x2 | $63.00 | 1
10_m03_front_retainer_x2 | $40.06 | 1
01_m03_shaft_x3 | $92.77 | 2
16_ankle_0_front_retainer_x2 | $53.34 | 1
03_hip_1_m04_front_retainer_x2 | $54.29 | 1
B3_body_side_plate_x2 | $198.11 | 2
B2_body_top_plate | $126.84 | 1
14_knee_back_shaft_x2 | $59.48 | 1
19_ankle_1_m02_back_cover_x2 | $49.79 | 1
11_knee_m04_front_retainer_x2 | $48.44 | 1
07_hip_1_front_shaft_x2 | $38.04 | 1
20_ankle_1_front_retainer_x2 | $38.68 | 1
