generalroboticslab/Duke_Humanoid_V2_OpenSource/reference/bom/toddlerbot_BOM_release.csv

Type | Item Description | Vendor Link | Alternative Link | Unit Price | QTY (2XC) | Total Price | QTY (2XM) | Total Price | Note
Assembed Kit | ToddlerBot 2.0 Fully Assembled | https://shop.wowrobo.com/products/toddlerbot-2-0-assembly-version | https://item.taobao.com/item.htm?ft=t&id=970730280172 | $4,299 | 1 | $4,299.00 |  |  | Buy your own Jetson Orin NX 16G ($955), WiFi ($27.85). and Battery (~$50)
Disclaimer | We are not affiliated with or endorse this company in any way. We have not tested or validated the product. Any such offerings are independent of our project.
Essentials (Highlighted are additional things to buy from 1.0 to 2.0)
Motors | DYNAMIXEL 2XC430-W250-T | DYNAMIXEL 2XC430-W250-T - ROBOTIS |  | $298.89 | 2 | $597.78 | 6 | $1,793.34
 | DYNAMIXEL 2XL430-W250-T | DYNAMIXEL 2XL430-W250-T - ROBOTIS |  | $149.39 | 6 | $896.34 | 0 | $0.00
 | DYNAMIXEL XC330-T288-T | DYNAMIXEL XC330-T288-T - ROBOTIS |  | $103.39 | 6 | $620.34 | 6 | $620.34
 | DYNAMIXEL XC430-T240BB-T | DYNAMIXEL XC430-T240BB-T - ROBOTIS |  | $137.89 | 4 | $551.56 | 4 | $551.56
 | DYNAMIXEL XM430-W210-T | DYNAMIXEL XM430-W210-T - ROBOTIS |  | $310.39 | 4 | $1,241.56 | 4 | $1,241.56
 | DYNAMIXEL XM430-W350-T | DYNAMIXEL XM430-W350-T - ROBOTIS |  | $310.39 | 0 | $0.00 | 4 | $1,241.56
 | DYNAMIXEL HN11-I101 Set | HN11-I101 Set - ROBOTIS |  | $8.05 | 10 | $80.50 | 8 | $64.40
 | DYNAMIXEL HN12-I101 Set | HN12-I101 Set - ROBOTIS |  | $20.47 | 4 | $81.88 | 6 | $122.82
 |  |  |  |  | $ of 2XC | $4,069.96 | $ of 2XC+ | $1,565.62
Parallel Gripper | DYNAMIXEL XC330-T288-T | DYNAMIXEL XC330-T288-T - ROBOTIS |  | $103.39 | 2 | $206.78
Computers | Jetson Orin NX 16G | NVIDIA® Jetson Orin™ NX 16GB AI Device - reComputer J4012 |  | $955.00 | 1 | $955.00 |  |  | Can replace with Jetson Orin Nano if budget is tight
 | M.2 CB375NF Wifi Card | Amazon.com: AW-CB375NF Wireless NIC, 2.4G/5GHz Dual-Band WiFi 5 Supports BLE, NGFF (M.2 A/E Key) Interface, for Jetson Xavier NX/Jetson Orin NX/Jetson Orin Nano : Electronics |  | $18.36 | 1 | $18.36
 | WiFi Antenna | Amazon.com: WiFi 6E Antenna IPX MHF4 Tri-Band 6GHz 5GHz 2.4GHz Internal Laptop Wi-Fi Antennas for AX200 AX210 1675X M.2 NGFF Card : Electronics |  | $9.49 | 1 | $9.49
Sensors | FIsheye Camera | Amazon.com: Arducam 1080P Low Light WDR Ultra Wide Angle USB Camera Module for Computer, 2MP CMOS IMX291 160 Degree Fisheye Mini UVC USB2.0 Webcam Board with Microphone, 3.3ft Cable for Windows Linux Mac OS : Electronics |  | $49.99 | 2 | $99.98
 | Phone Speaker | https://www.amazon.com/MMOBIEL-Replacement-iPhone-Plus-Screwdriver/dp/B079Z85L4N | Mmobiel Loud Speaker Compatible With Iphone Se 2022 Se 2020 | Desertcart Brunei | $5.99 | 1 | $5.99
 | Speaker Driver | Amazon.com: HiLetgo 3pcs M38 Wireless Bluetooth MP3 Audio Receiver Board BLT 4.2 mp3 Lossless decoder Bluetooth 4.2 Audio Receiver Board Wireless Stereo Sound Module : Electronics |  | $7.99 | 1 | $7.99
 | BNO085 IMU | Adafruit 9-DOF Orientation IMU Fusion Breakout - BNO085 (BNO080) [STEMMA QT / Qwiic] : ID 4754 : Adafruit Industries, Unique & fun DIY electronics and kits |  | $24.95 | 1 | $24.95
Hardware | M2*6 Pre-coated Screws | https://e.tb.cn/h.hFvWE8HfWc1pSka?tk=5rJm4l9H7bX |  | $0.01 | 200 | $1.80 |  |  | It is recommended to replace all positions using this type of screw with pre-coated screws or you have to use the threadlocker
 | M2 Screw Kit | Amazon.com: Kadrick 304 Stainless Steel Screws,660 Pcs M2 Screw Assortment,Button Head Socket Cap Screws Kit,M2x4mm,6mm,8mm,10mm,12mm,16mm Metric Bolts Nuts Washers Kit with 1 Hex Allen Wrench : Industrial & Scientific |  | $8.99 | 2 | $17.98
 | M2.5 Screw Kit | 705 Pieces M2.5 Screws Nuts Washers Set Black, Sutemribor M2.5 x 4/6/8/10/12/16/20mm Button Head Socket Cap Screws Nuts Washers Assortment Kit, 10.9 Grade Alloy Steel, Fully Threaded: Amazon.com: Industrial & Scientific |  | $9.99 | 1 | $9.99
 | M3 Flat Head Screw Kit | 565 Pieces M3 Screws Nuts Washers Set Black, Sutemribor M3 x 5/6/8/10/12/16/20mm Countersunk Head Socket Cap Screws Nuts Washers Assortment Kit, 10.9 Grade Alloy Steel, Fully Threaded: Amazon.com: Industrial & Scientific |  | $9.99 | 1 | $9.99
 | M3*8 Set Screw | 50 Pcs M3x8mm Metric 304 Stainless Steel Hex Socket Set Flat Point Grub Screws Silver Tone for Towel Rack Door Knob （M3x8mm）: Amazon.com: Industrial & Scientific |  | $6.99 | 1 | $6.99
 | M3*10 Set Screw | 50 Pcs M3x10mm Metric 304 Stainless Steel Hex Socket Set Flat Point Grub Screws Silver Tone for Towel Rack Door Knob （M3x10mm）: Amazon.com: Industrial & Scientific |  | $6.99 | 1 | $6.99
 | M4 Screw Kit | iexcell 675 Pcs M4 x 6/8/10/12/16/20/25/30/35/40 Alloy Steel 10.9 Grade Hex Socket Button Head Cap Screws Bolts Nuts Washers Assortment Kit, Black Oxide Finish: Amazon.com: Industrial & Scientific |  | $22.38 | 1 | $22.38
 | M4 Long Screw Kit | iexcell 50 Pcs M4 x 40/45/50/55/60mm Thread Pitch 0.7 mm Stainless Steel 304 Hex Socket Head Cap Screws Bolts Assortment Kit: Amazon.com: Industrial & Scientific |  | $9.58 | 1 | $9.58
 | M3 and M4 Lock Nuts Kit | 182 Pieces 304 Stainless Steel Lock Nuts |  | $7.98 | 1 | $7.98
 | Vibra-TITE 213 Threadlocker | Amazon.com: Vibra-TITE 213 VC-3 Threadmate Threadlocker, -65 to 165 Degree F, 5mL Tube, Red : Automotive |  | $6.55 | 1 | $6.55
 | Bearing 683 10pcs | uxcell 683-2RS Deep Groove Ball Bearing 3x7x3mm Double Sealed ABEC-3 Bearings 10-Pack: Amazon.com: Industrial & Scientific |  | $11.96 | 1 | $11.96
 | Bearing 684 10pcs | 684ZZ Bearing 4X9X4 mm ABEC-5 (10 PCS) Miniature 684Z Ball Bearings 684 ZZ 618/4ZZ Hobby Emax Motor Quadcopter L-940ZZ Bearing: Amazon.com: Industrial & Scientific |  | $7.99 | 2 | $15.98
 | Bearing AXK0414 | 1Pcs Plane Thrust Needle Roller Bearing AXK0414 0515 0619 0821 1024 1226 1528 1730 2035 2542 3047 3552 4060 To 5070+2AS 2Washers - AliExpress 13 | https://www.amazon.com/uxcell-Bearings-Diameter-Thickness-Steering/dp/B0DQ8T13KV | $1.48 | 30 | $44.40
 | Bushing 3*5*5 10pcs | uxcell Sleeve Bearings 3mm Bore x 5mm OD x 5mm Length Plain Bearings Wrapped Oilless Bushings for Sliding Parts of Machinery, 10pcs: Amazon.com: Industrial & Scientific |  | $5.99 | 1 | $5.99
 | 5mm Rubber Tape | https://www.amazon.com/dp/B0CJRMXN3F?ref=ppx_yo2ov_dt_b_fed_asin_title&th=1 |  | $16.99 | 1 | $16.99
Electronics | Step Down Power Converter 12V 4.5A | Pololu - 12V, 4.5A Step-Down Voltage Regulator D36V50F12 |  | $34.95 | 2 | $69.90
 | USB to Mirco USB Cable 0.5 Feet | https://www.amazon.com/CableCreation-Charger-Compatible-Chromecast-Android/dp/B0CGRG7F2Q?s=industrial |  | $5.98 | 1 | $5.98
 | USB to Mirco USB Cable 1.5 Feet | https://www.amazon.com/dp/B0773N757H?ref=ppx_yo2ov_dt_b_fed_asin_title&th=1 |  | $8.99 | 1 | $8.99
 | USB Hub Port Splitter | https://www.amazon.com/dp/B088KBGRD9?ref=ppx_yo2ov_dt_b_fed_asin_title |  | $6.98 | 1 | $6.98
 | Jumper Wire | https://www.amazon.com/EDGELEC-Breadboard-Optional-Assorted-Multicolored/dp/B07GD2BWPY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 |  | $6.98 | 1 | $6.98
 | JST EH Cable | https://www.digikey.com/short/523wz1nj |  | $0.38 | 10 | $3.82
 | JST EH Housing | https://www.digikey.com/short/zqh51b3r |  | $0.05 | 25 | $1.17
 | 5 Pairs of XT30 Male and Female Plugs | https://www.amazon.com/dp/B09LYHHS9J?ref=ppx_yo2ov_dt_b_fed_asin_title&th=1 |  | $9.99 | 1 | $9.99
 | XT30 to XT60 Male Female 4 pcs | https://www.amazon.com/dp/B07XDTJJLV?ref=ppx_yo2ov_dt_b_fed_asin_title |  | $8.99 | 1 | $8.99
 | Barrel Jack Connector | https://www.amazon.com/Terminal-5-5mm%C3%972-5mm-Connector-Surveillance-Repairs/dp/B0FD9BK96H |  | $9.49 | 1 | $9.49
 | Rocker Switch 5 pcs | https://www.amazon.com/dp/B0C53HD8J7?ref=ppx_yo2ov_dt_b_fed_asin_title&th=1 |  | $5.99 | 1 | $5.99
 | 2000 mAh Lipo Battery | https://www.amazon.com/dp/B0912XDRZJ?starsLeft=1&skipTwisterOG=1 |  | $49.99 | 1 | $49.99
 | Lipo Battery Voltage Tester | https://www.amazon.com/dp/B07DC3LH9C?ref=ppx_yo2ov_dt_b_fed_asin_title |  | $12.95 | 1 | $12.95
 | Lipo Battery Balance Charger | https://www.amazon.com/dp/B09XC91BWJ?ref=ppx_yo2ov_dt_b_fed_asin_title |  | $31.99 | 1 | $31.99
 | 14 AWG Power Extension Cable | https://www.amazon.com/Electrical-Conductor-Flexible-Parallel-Extension/dp/B088RDY284?s=industrial |  | $17.49 | 1 | $17.49
Materials | PLA-CF 1KG | https://us.store.bambulab.com/collections/carbon-fiber/products/pla-cf?variant=41003202248840 |  | $34.99 | 2 | $69.98
 | PLA 1KG | https://us.store.bambulab.com/products/pla-basic-filament |  | $19.99 | 1 | $19.99
 |  |  |  |  |  | $5,727.94 | $7,293.56
 |  |  |  |  |  | 2XC | 2XM
Tools
3D-Printing | Bambu Lab X1-Carbon Combo 3D Printer | https://us.store.bambulab.com/products/x1-carbon-combo |  | $1,449.00 | 1 | $1,449.00
 | Bambu Smooth PEI Plate | https://us.store.bambulab.com/products/bambu-smooth-pei-plate |  | $37.99 | 1 | $37.99
 | Liquid Glue for Build Plate | https://us.store.bambulab.com/products/liquid-glue-for-build-plate?_pos=2&_sid=7c0e9c004&_ss=r |  | $16.99 | 1 | $16.99
 | Anti-vibration Foot | https://us.store.bambulab.com/products/anti-vibration-feet-for-p1p |  | $10.99 | 1 | $10.99
Power | 30V 10A Power Supply | https://www.amazon.com/Programmable-Precision-Multiple-Protection-Software/dp/B0928LX2D1?s=industrial |  | $119.99 | 1 | $119.99
 | Banana Plug Cables | https://www.amazon.com/Sumnacon-Multimeter-Crocodile-Alligator-Stackable/dp/B071SL6PQS |  | $9.99 | 1 | $9.99
Hardware | Screwdriver Kit | https://www.amazon.com/dp/B0BLMQ8BXB?starsLeft=1&ref_=cm_sw_r_cso_cp_apin_dp_RDJBS7WAX5ERNPW5P4YK |  | $64.99 | 1 | $64.99
 | Precision Screwdriver Kit | https://www.amazon.com/HOTO-Screwdriver-Precision-Rechargeable-Electronics/dp/B09MR5HFPB |  | $29.99 | 1 | $29.99
 | Allen Key Set | https://www.amazon.com/Edward-Tools-Piece-Short-Wrench/dp/B09PC433HS?s=hi |  | $6.95 | 1 | $6.95
 | Pliers | https://www.amazon.com/Professional-Cutters-Diagonal-Repairing-Crafting/dp/B07R8JLJVR |  | $32.35 | 1 | $32.35
 | Caliper Digital | https://www.amazon.com/Measuring-Stainless-Micrometer-Fraction-Household/dp/B0BF9LW56V |  | $29.98 | 1 | $29.98
 | Double Sided Tape | https://www.amazon.com/BYUEE-30-Yards-Adhesive-Scrapbooking-Wrapping/dp/B07MZQC1T2?s=hi |  | $9.99 | 1 | $9.99
Soldering | Automatic Wire Stripper | https://www.amazon.com/VCELINK-Automatic-Stripper-Professional-Adjustable/dp/B08G48R47N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 |  | $9.99 | 1 | $9.99
 | Soldering Tweezer | https://www.amazon.com/Precision-Anti-Static-Electronics-Sodlering%EF%BC%8CJewelry-Laboratory/dp/B0BHP5S82C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 |  | $5.99 | 1 | $5.99
 | Soldering Brass | https://www.amazon.com/Weller-WLACCBSH-02-Soldering-Cleaner-Silicone/dp/B08FQBS97L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 |  | $11.97 | 1 | $11.97
 | Soldering Station | https://www.amazon.com/gp/product/B07XC9VV2C/ref=ppx_yo_dt_b_search_asin_title?ie=UTF8&th=1 |  | $69.99 | 1 | $69.99
 | Black Silicone Repair Mat | https://www.amazon.com/gp/product/B08RXMDKWX/ref=ppx_yo_dt_b_search_asin_title?ie=UTF8&th=1 |  | $8.53 | 1 | $8.53
 | Heat Shrink Tube | https://www.amazon.com/Ginsco-580-pcs-Assorted-Sleeving/dp/B01MFA3OFA |  | $6.99 | 1 | $6.99
 | Heat Shrink Butt Connectors 100 pcs | https://www.amazon.com/gp/product/B07GDDKJ1D/ref=ppx_yo_dt_b_search_asin_title?ie=UTF8&th=1 |  | $9.49 | 1 | $9.49
 | Helping Hands Soldering | https://www.amazon.com/gp/product/B07MDKXNPC/ref=ppx_yo_dt_b_search_asin_title?ie=UTF8&th=1 |  | $23.99 | 1 | $23.99
 | 60/40 Tin Lead Solder Wire | https://www.amazon.com/gp/product/B07BGTSWYB/ref=ppx_yo_dt_b_search_asin_title?ie=UTF8&th=1 |  | $9.99 | 1 | $9.99
 |  |  |  |  |  | $1,976.13
Additional Features
Safety Stand | 20 Set 4040 Connector | https://www.amazon.com/4040-Connector-Corner-Reinforcing-20/dp/B0BS6MG9D5?sp_csd=d2lkZ2V0TmFtZT1zcF9hdGY |  | $24.99 | 1 | $24.99
 | 4040 Aluminum Extrusion 500mm | https://www.amazon.com/Seekliny-Aluminum-Extrusion-T-Slotted-Accessories/dp/B0CP1XF8XM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 |  | $55.99 | 1 | $55.99
 | M5 T-Nuts Screws Kit 200pcs | https://www.amazon.com/Aluminum-Extrusion-Hexagon-Sliding-Washers/dp/B0C4JTL1MP?sp_csd=d2lkZ2V0TmFtZT1zcF9tdGY |  | $13.99 | 1 | $13.99
 | 2020 Aluminum Extrusion 100mm | https://www.amazon.com/European-Standard-Anodized-Aluminum-Extrusion/dp/B09JSN97Y9 |  | $18.99 | 1 | $18.99
Teleoperation | DYNAMIXEL 2XL430-W250-T | https://www.robotis.us/dynamixel-2xl430-w250-t/ |  | $129.90 | 6 | $779.40
 | DYNAMIXEL XC430-T240BB-T | https://www.robotis.us/dynamixel-xc430-t240bb-t/ |  | $119.99 | 2 | $239.98
 | Dynamixel U2D2 USB Comm Module | https://www.robotis.us/u2d2/ |  | $32.10 | 1 | $32.10
 | Dynamixel U2D2 Power Hub Board Set | https://www.robotis.us/u2d2-power-hub-board-set/ |  | $19.00 | 1 | $19.00
 | Breadboard Kit | https://www.amazon.com/ELEGOO-Breadboard-Solderless-Breadboards-Electronics/dp/B0CYPVMK9J |  | $6.99 | 1 | $6.99
 | LilyGo T-Display S3 | https://www.amazon.com/dp/B09J112YR7?ref=ppx_yo2ov_dt_b_fed_asin_title&th=1 |  | $27.50 | 1 | $27.50
 | Round Force Sensitive Resistor (FSR) | https://www.adafruit.com/product/5475 |  | $4.46 | 2 | $8.92
 | Resistor Kit | https://www.amazon.com/BOJACK-Values-Resistor-Resistors-Assortment/dp/B08FD1XVL6?s=industrial |  | $9.99 | 1 | $9.99
 | E stop Switch | https://www.amazon.com/dp/B09B2441R7?ref=ppx_yo2ov_dt_b_fed_asin_title |  | $6.99 | 1 | $6.99
 | Rog Ally X | https://www.bestbuy.com/site/asus-rog-ally-x-7-120hz-fhd-1080p-gaming-handheld-amd-ryzen-z1-extreme-processor-24gb-with-1tb-ssd-black/6583218.p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 |  | $900.00 | 1 | $900.00
Battery | 21700 Cell | https://mabdelectronics.com/products/samsung-21700-50s-25a-5000mah-battery?variant=44357994479862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 |  | $8.49 | 6 | $50.94
 | 21700 Battery Holder | https://www.amazon.com/dp/B0BSDC7L9T?ref=ppx_yo2ov_dt_b_fed_asin_title |  | $12.99 | 1 | $12.99
 | JST XH balancing plug | https://www.amazon.com/Connector-pre-crimped-Housing-Adapter-Compatible/dp/B08G188ZQ8 |  | $16.99 | 1 | $16.99
SysID | Portable Bench Clamp | https://www.amazon.com/dp/B09ZKF5WR7?ref=ppx_yo2ov_dt_b_fed_asin_title |  | $26.98 | 1 | $26.98
 |  |  |  |  |  | $2,252.73
