generalroboticslab/Duke_Humanoid_V2_OpenSource/reference/_meta/cad-trees/berkeley-humanoid-lite-bom-sheet-M6C12-actuator.csv

Category | Item | Description | Quantity | Cost USD | Total Cost USD | US Link | Cost RMB | Total Cost RMB | China Link
Bearing | MR106-2RS | Bearing between input shaft and cycloidal disk, and between input shaft and output shaft | 13 | $0.87 | $11.31 | https://www.amazon.com/dp/B082PSCNKB?ref_=cm_sw_r_cp_ud_dp_XR6N8JQ34JH0ZSWHT5HK | ¥0.90 | ¥11.70 | https://detail.tmall.com/item.htm?abbucket=9&id=728753970557&skuId=5050168324949
 | 6701-2RS | Bearing between cycloidal disk and output shaft | 2 | $0.94 | $1.88 | https://www.amazon.com/gp/product/B082PQ8DC2 | ¥2.30 | ¥4.60 | https://detail.tmall.com/item.htm?abbucket=9&id=672836796497&skuId=5017505094887
 | 6811ZZ | Bearing between output shaft and housing | 2 | $5.00 | $10.00 | https://www.amazon.com/gp/product/B082PW8F3S | ¥5.83 | ¥11.66 | https://detail.tmall.com/item.htm?abbucket=8&id=695287603935&ns=1&skuId=5102438922487
Fastener | M3 x 55 mm | Mounting housing | 8 | $0.26 | $2.08 | https://www.amazon.com/gp/product/B01N68JLPE/ | ¥0.35 | ¥2.80 | https://detail.tmall.com/item.htm?abbucket=8&id=654819932601&skuId=5014407101270
 | M3 x 30 mm | Mounting output shaft | 6 | $0.19 | $1.14 | https://www.amazon.com/gp/product/B0968155BV | ¥0.07 | ¥0.42 | https://detail.tmall.com/item.htm?abbucket=8&id=654819932601&skuId=5014407101253
 | M2 x 3 x 3.5 mm | M2 threaded insert for mounting encoder | 4 | $0.07 | $0.28 | https://www.amazon.com/dp/B0B8GN63S2 | ¥0.08 | ¥0.32 | https://detail.tmall.com/item.htm?abbucket=15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
 | M3 x 4 x 5 mm insert | M3 threaded insert | 24 | $0.08 | $1.92 | https://www.amazon.com/gp/product/B0BTYF2MMD | ¥0.13 | ¥3.12 | https://item.taobao.com/item.htm?id=593581996419&skuId=4189077672129
 | M4 x 15 mm hex stand | input shaft stiffener | 1 | $0.69 | $0.69 | https://www.amazon.com/Aexit-Spacers-Standoffs-Female-Standoff/dp/B07DRGBZTH?s=industrial | ¥0.26 | ¥0.26 | https://detail.tmall.com/item.htm?abbucket=8&id=645528391157
Motor | MAD Components M6C12 150KV |  | 1 | $129.00 | $129.00 | https://www.amazon.com/MAD-COMPONENTS-Antimatter-Multirotor-Quadcopter/dp/B08GQ6Q464 | ¥888.00 | ¥888.00 | https://item.taobao.com/item.htm?abbucket=8&id=650930600496
Structural | PLA | 3D print filament, in kg | 0.12 | $25.99 | $3.12 | https://www.amazon.com/gp/product/B00J0GMMP6 | ¥79.00 | ¥9.48 | https://detail.tmall.com/item.htm?abbucket=8&id=693972799714
Electrical | B-G431B-ESC1 | Motor controller | 1 | $18.97 | $18.97 | https://www.digikey.com/en/products/detail/stmicroelectronics/B-G431B-ESC1/10321670 | ¥165.00 | ¥165.00 | https://item.taobao.com/item.htm?abbucket=8&id=656153143517
 | AS5600 | I2C position encoder | 1 | $3.30 | $3.30 | https://www.amazon.com/gp/product/B09LMB3PTZ | ¥5.40 | ¥5.40 | https://item.taobao.com/item.htm?abbucket=8&id=828546819482
 | Misc | Cables & connectors | 1 | $5.00 | $5.00 |  | ¥20.00 | ¥20.00
Total |  |  |  |  | $188.69 |  |  | ¥1,122.76
 |  |  |  |  |  |  |  | $158.14
