generalroboticslab/Duke_Humanoid_V2_OpenSource/hardware-site/docs/files/modules/foot-assembly_rev01.step

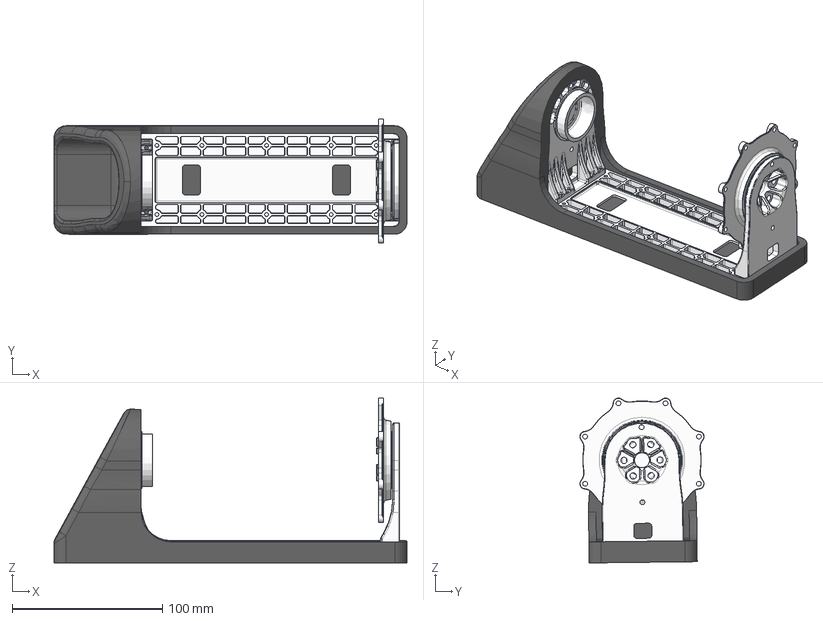
[picture p28: CAD file, 2026-09-19]
hardware-site/docs/files/modules/foot-assembly_rev01.step
235.0 x 82.8 x 109.8 mm
