generalroboticslab/Duke_Humanoid_V2_OpenSource/hardware-site/docs/files/modules/robstride-03-full_rev01.step

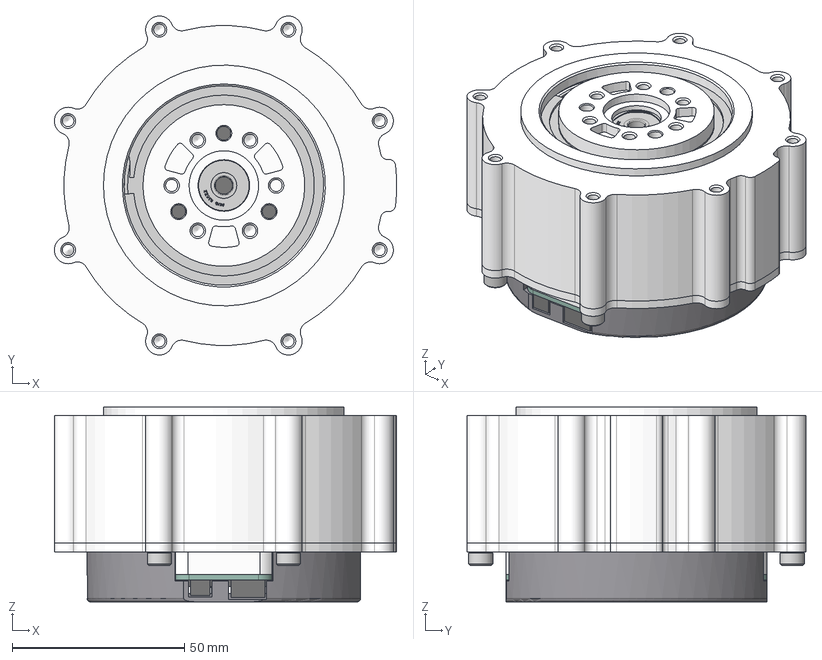
[picture p29: CAD file, 2026-09-19]
hardware-site/docs/files/modules/robstride-03-full_rev01.step
99.5 x 98.5 x 56.6 mm
