generalroboticslab/Duke_Humanoid_V2_OpenSource/hardware-site/docs/files/modules/knee-assembly_rev01.step

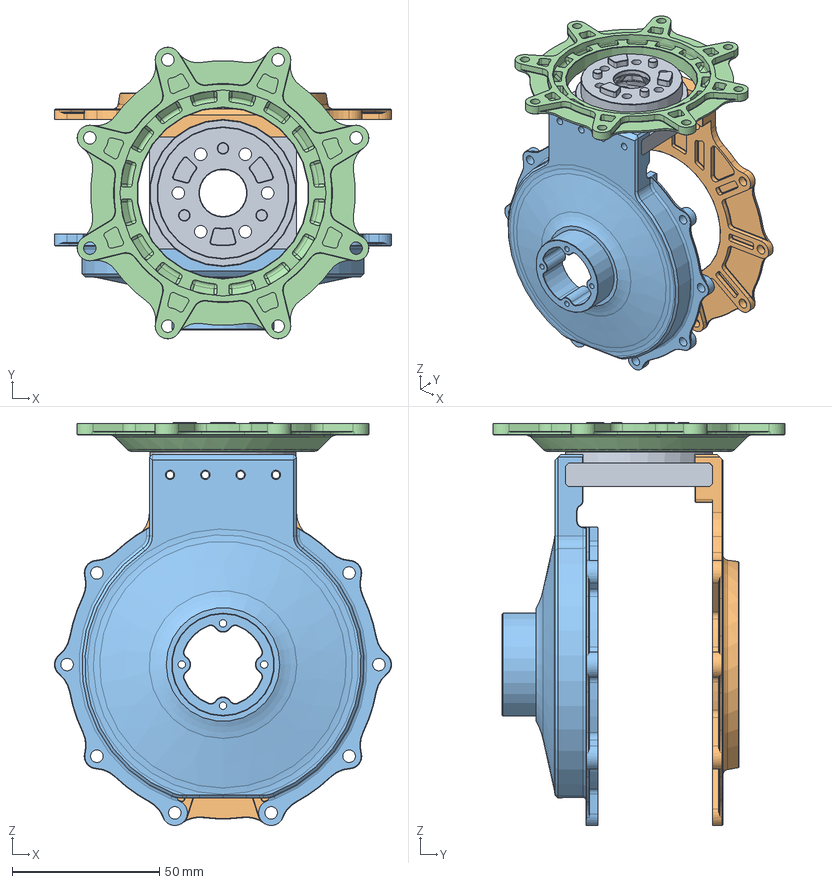
[picture p30: CAD file, 2026-09-19]
hardware-site/docs/files/modules/knee-assembly_rev01.step
114.6 x 99.1 x 137.0 mm
