generalroboticslab/Duke_Humanoid_V2_OpenSource/hardware-site/docs/files/modules/bearing-45x58x7-6809-5-4kn-40g_rev01.step

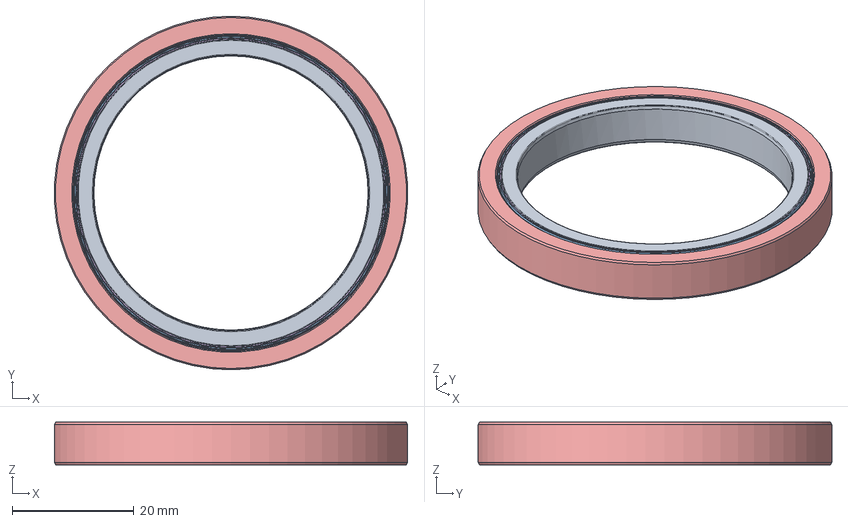
[picture p31: CAD file, 2026-09-19]
hardware-site/docs/files/modules/bearing-45x58x7-6809-5-4kn-40g_rev01.step
57.9 x 58.0 x 7.00 mm
4668K272_Permanently Lubricated Stainless Steel Ball Bearing x 2
