generalroboticslab/Duke_Humanoid_V2_OpenSource/hardware-site/docs/files/step/3DP_legP02_hip3_cover_b_rev01.step

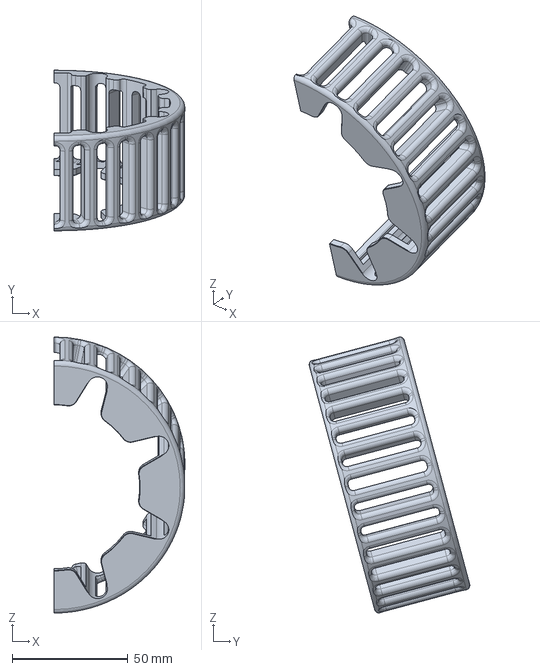
[picture p32: CAD file, 2026-09-19]
hardware-site/docs/files/step/3DP_legP02_hip3_cover_b_rev01.step
56.5 x 69.4 x 119.2 mm
