generalroboticslab/Duke_Humanoid_V2_OpenSource/hardware-site/docs/files/modules/bearing-35x47x7-6807-4-0kn-29g_rev01.step

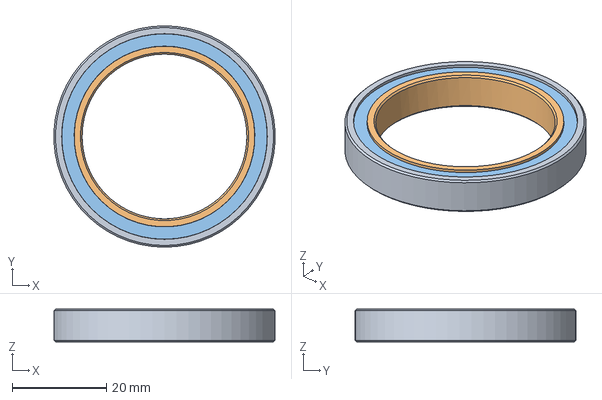
[picture p33: CAD file, 2026-09-19]
hardware-site/docs/files/modules/bearing-35x47x7-6807-4-0kn-29g_rev01.step
46.9 x 47.0 x 7.00 mm
