generalroboticslab/Duke_Humanoid_V2_OpenSource/hardware-site/docs/files/step/CNC_leg07_hip_roll_support_shaft_rev01.step

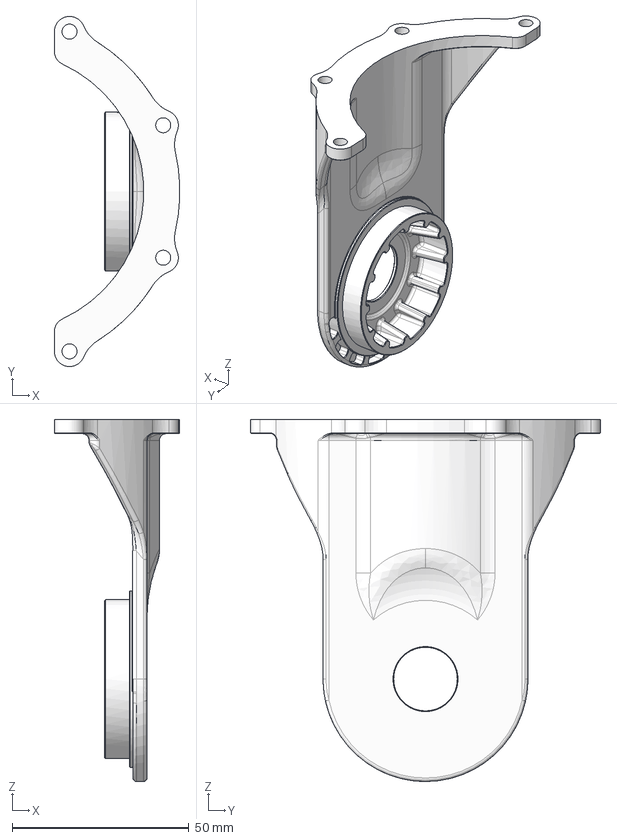
[picture p34: CAD file, 2026-09-19]
hardware-site/docs/files/step/CNC_leg07_hip_roll_support_shaft_rev01.step
35.5 x 99.1 x 102.5 mm
