generalroboticslab/Duke_Humanoid_V2_OpenSource/hardware-site/docs/files/step/CNC_leg02_RS03_shaft_coupler_rev01.step

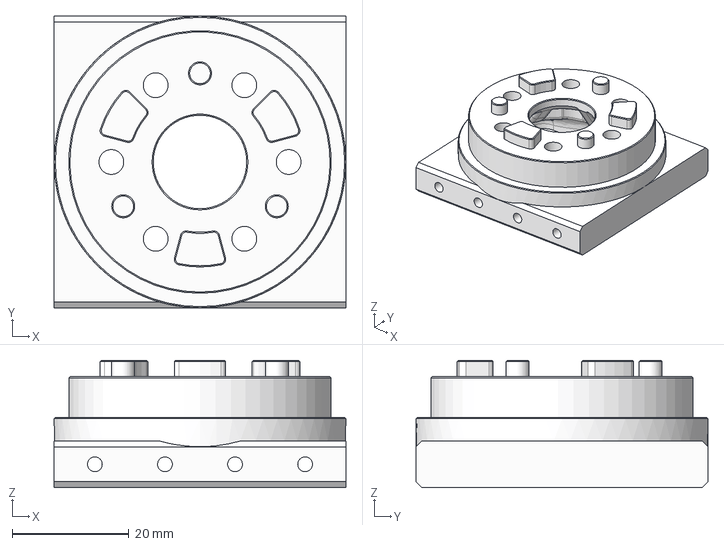
[picture p35: CAD file, 2026-09-19]
hardware-site/docs/files/step/CNC_leg02_RS03_shaft_coupler_rev01.step
50.0 x 50.0 x 21.8 mm
