generalroboticslab/Duke_Humanoid_V2_OpenSource/hardware-site/docs/files/modules/double-helix-pinion-16teeth-6mm_rev01.step

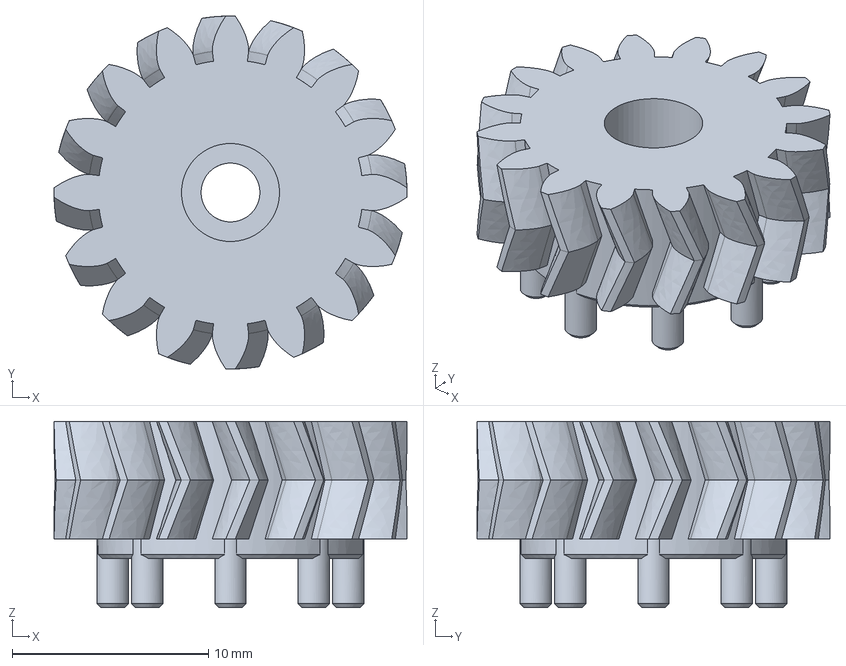
[picture p36: CAD file, 2026-09-19]
hardware-site/docs/files/modules/double-helix-pinion-16teeth-6mm_rev01.step
18.0 x 18.0 x 9.50 mm
