generalroboticslab/Duke_Humanoid_V2_OpenSource/hardware-site/docs/files/step/CNC_arm13_RS05_shaft_coupler_rev01.step

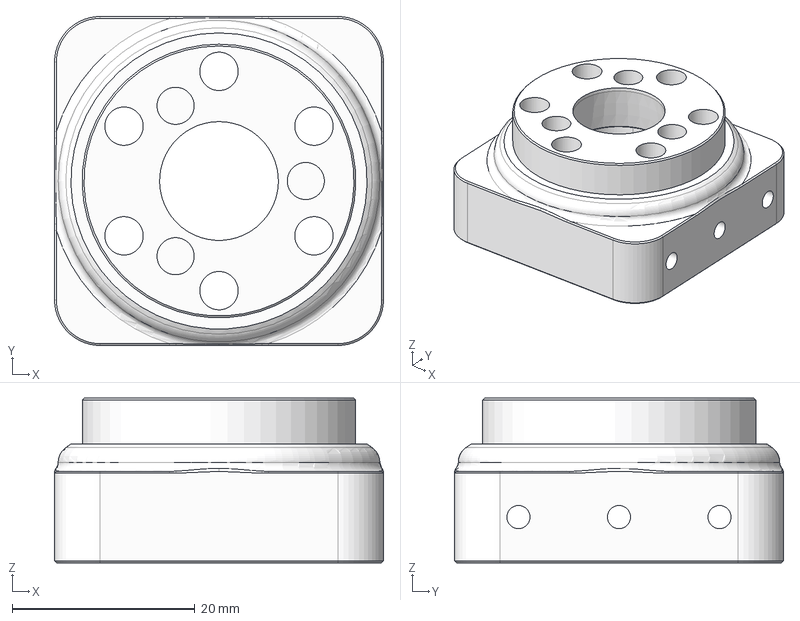
[picture p37: CAD file, 2026-09-19]
hardware-site/docs/files/step/CNC_arm13_RS05_shaft_coupler_rev01.step
36.0 x 36.0 x 18.0 mm
