generalroboticslab/Duke_Humanoid_V2_OpenSource/hardware-site/docs/files/modules/intelrealsense-d435-multibody-v9-1_rev01.step

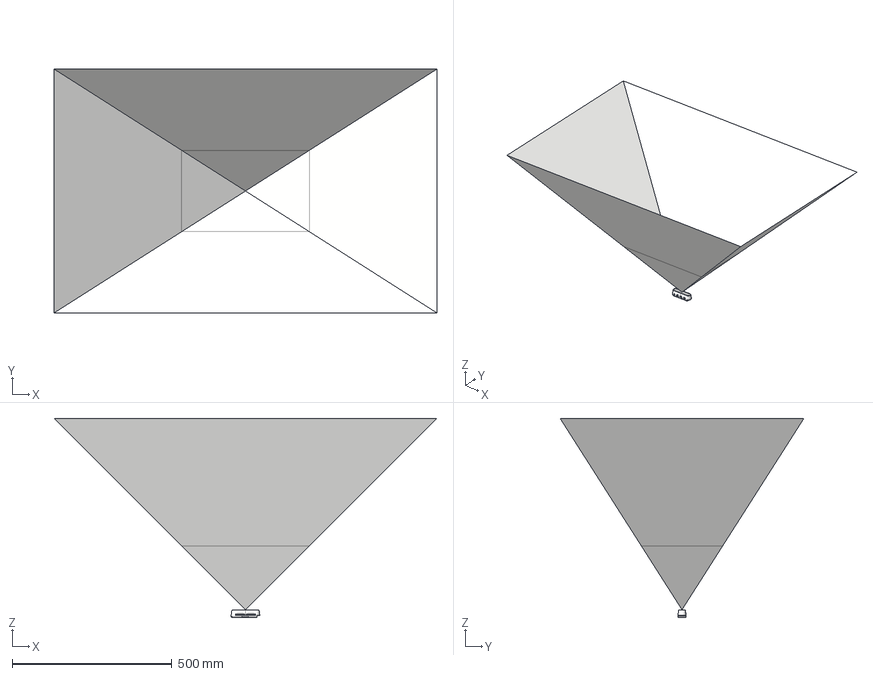
[picture p38: CAD file, 2026-09-19]
hardware-site/docs/files/modules/intelrealsense-d435-multibody-v9-1_rev01.step
1200.0 x 764.5 x 625.0 mm
