generalroboticslab/Duke_Humanoid_V2_OpenSource/hardware-site/docs/files/step/CNC_leg08_knee_front_bearing_retainer_rev01.step

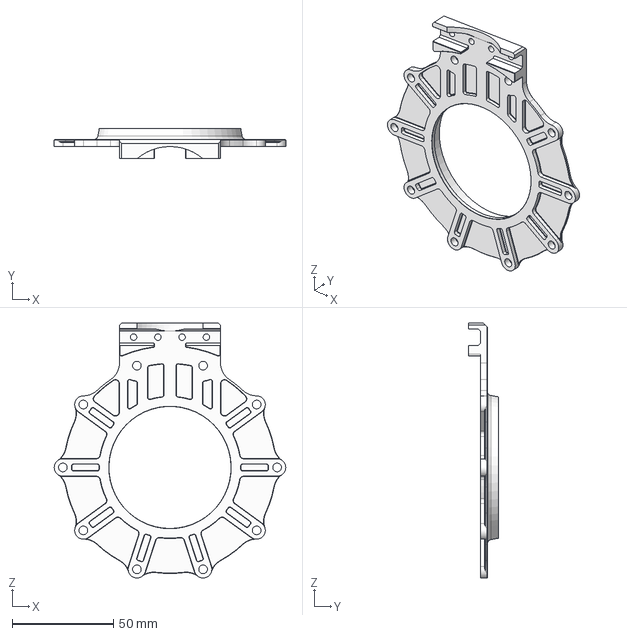
[picture p39: CAD file, 2026-09-19]
hardware-site/docs/files/step/CNC_leg08_knee_front_bearing_retainer_rev01.step
114.6 x 15.0 x 126.2 mm
