generalroboticslab/Duke_Humanoid_V2_OpenSource/hardware-site/docs/files/modules/hip-pitch-hip-roll-l_rev01.step

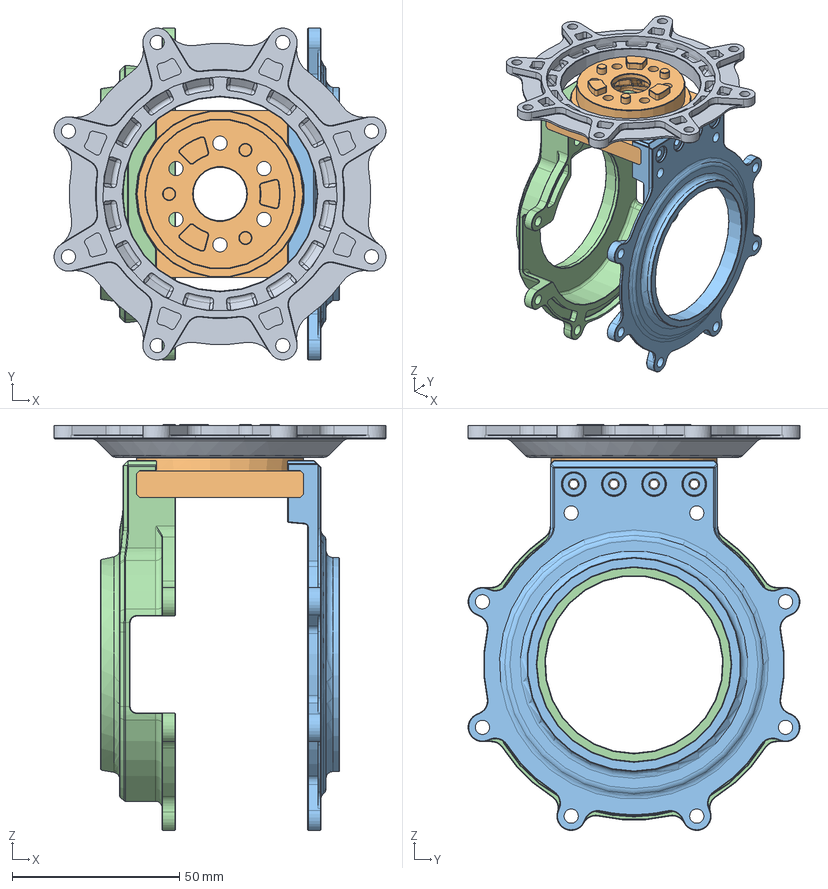
[picture p40: CAD file, 2026-09-19]
hardware-site/docs/files/modules/hip-pitch-hip-roll-l_rev01.step
99.1 x 99.1 x 121.3 mm
CNC_leg03_x5_RS03_shaft_bearing_retainer
CNC_leg02_x7_RS03_shaft_coupler
