generalroboticslab/Duke_Humanoid_V2_OpenSource/hardware-site/docs/files/modules/imu-syd-dynamics-tm171_rev01.step

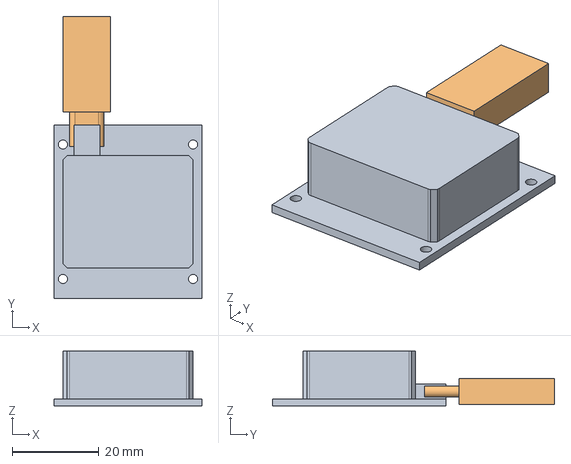
[picture p42: CAD file, 2026-09-19]
hardware-site/docs/files/modules/imu-syd-dynamics-tm171_rev01.step
34.0 x 65.0 x 12.6 mm
