generalroboticslab/Duke_Humanoid_V2_OpenSource/hardware-site/docs/files/step/CNC_leg04_hip_roll_front_bearing_retainer_rev01.step

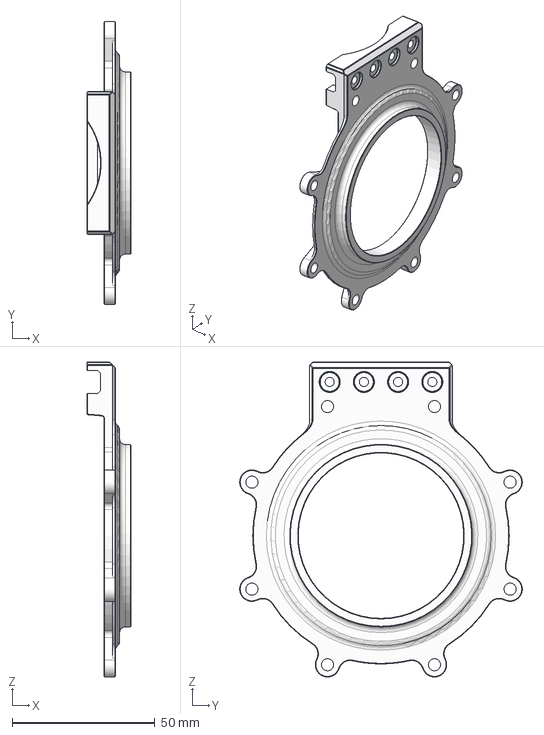
[picture p43: CAD file, 2026-09-19]
hardware-site/docs/files/step/CNC_leg04_hip_roll_front_bearing_retainer_rev01.step
15.5 x 99.1 x 110.5 mm
