generalroboticslab/Duke_Humanoid_V2_OpenSource/hardware-site/docs/files/modules/wareshare-st-servo-controller_rev01.step

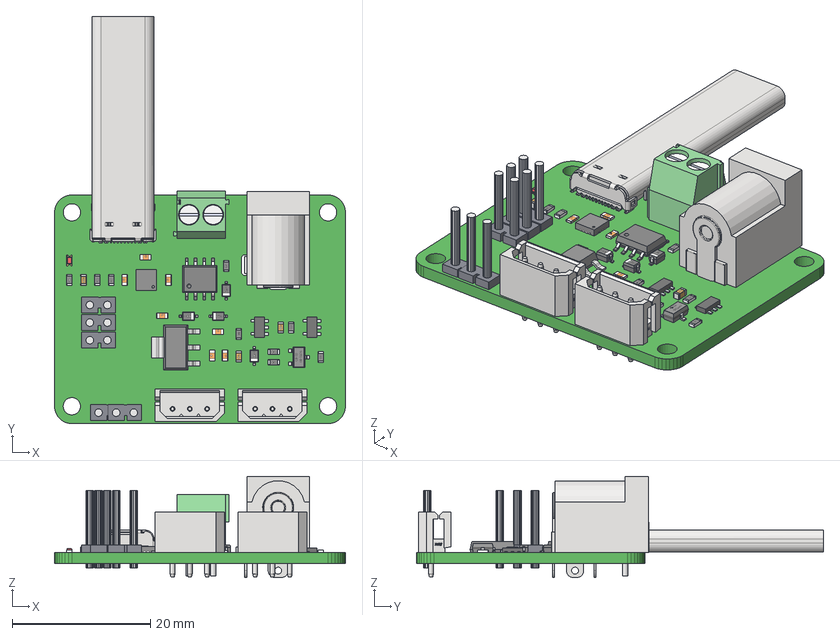
[picture p44: CAD file, 2026-09-19]
hardware-site/docs/files/modules/wareshare-st-servo-controller_rev01.step
42.0 x 58.8 x 14.6 mm
