generalroboticslab/Duke_Humanoid_V2_OpenSource/hardware-site/docs/files/step/3DP_legP06_hip2_cover_b_rev01.step

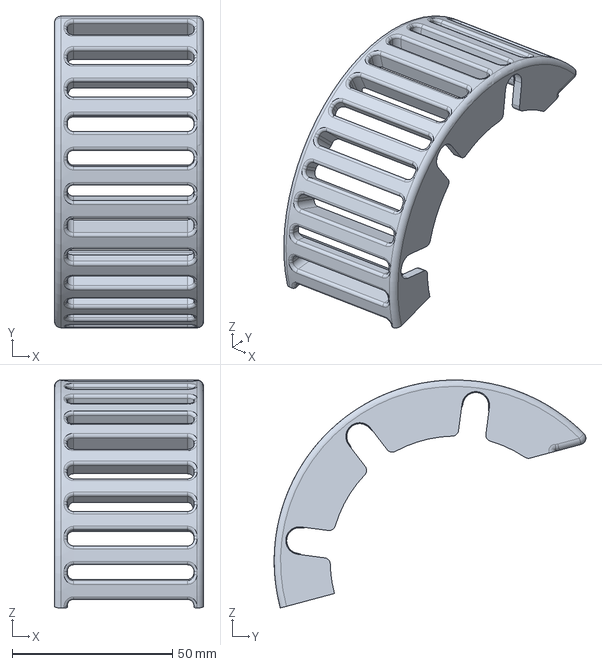
[picture p46: CAD file, 2026-09-19]
hardware-site/docs/files/step/3DP_legP06_hip2_cover_b_rev01.step
46.5 x 97.2 x 71.1 mm
