generalroboticslab/Duke_Humanoid_V2_OpenSource/hardware-site/docs/files/modules/gimbal-arm_rev01.step

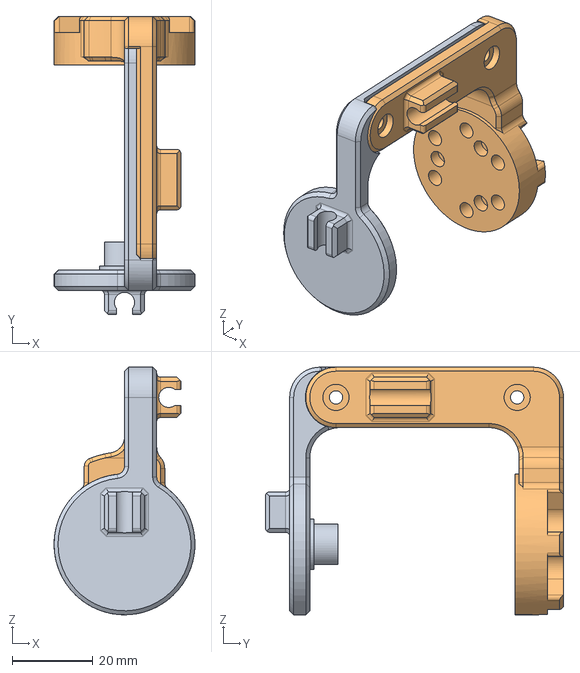
[picture p47: CAD file, 2026-09-19]
hardware-site/docs/files/modules/gimbal-arm_rev01.step
35.0 x 74.0 x 61.5 mm
