generalroboticslab/Duke_Humanoid_V2_OpenSource/hardware-site/docs/files/step/3DP_legP11_ankle_cover_a_rev01.step

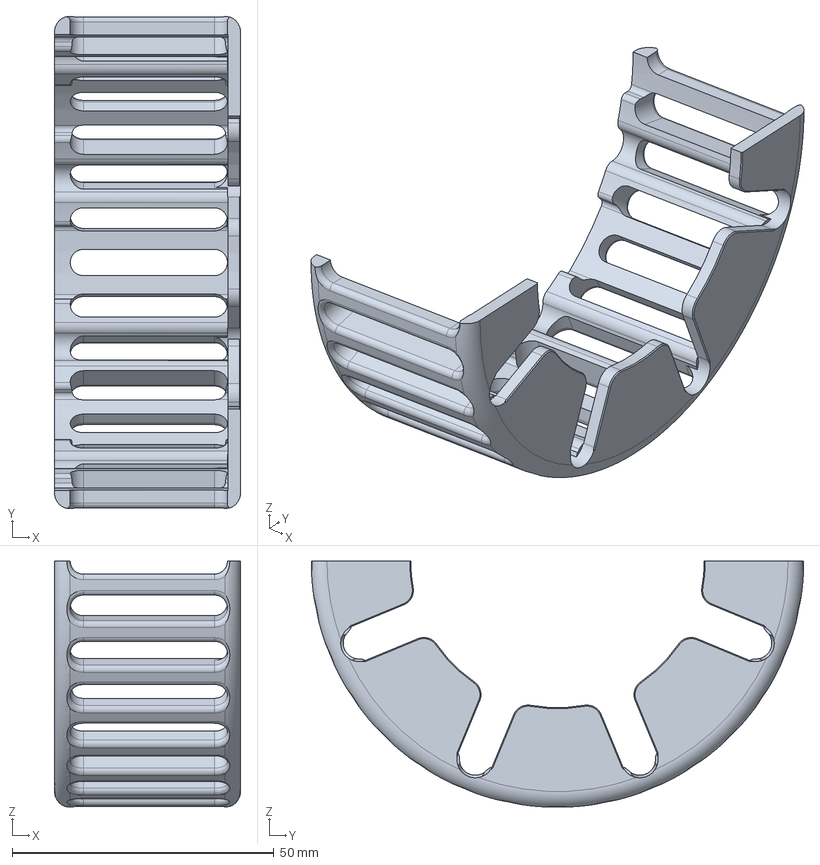
[picture p48: CAD file, 2026-09-19]
hardware-site/docs/files/step/3DP_legP11_ankle_cover_a_rev01.step
35.5 x 93.9 x 46.9 mm
