generalroboticslab/Duke_Humanoid_V2_OpenSource/hardware-site/docs/files/modules/hip-center_rev01.step

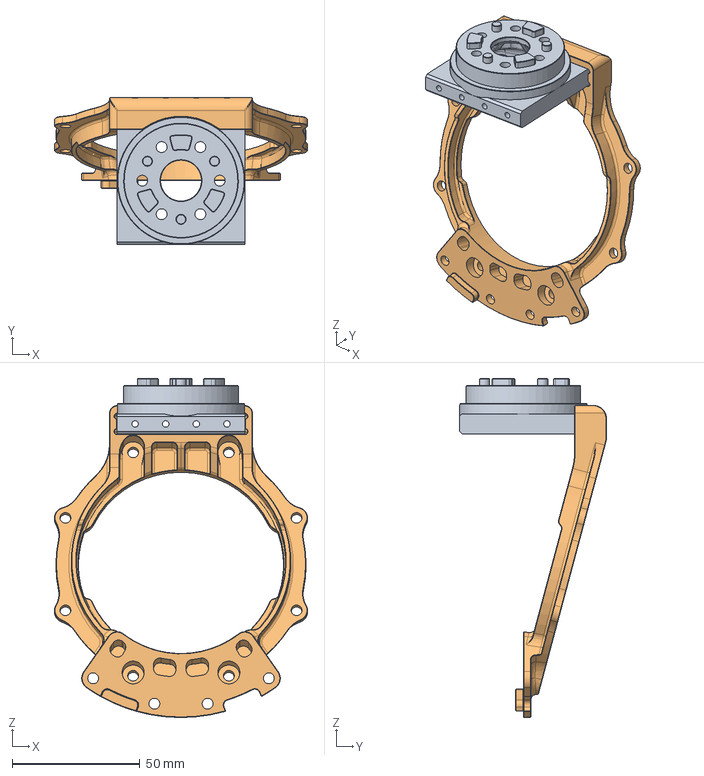
[picture p49: CAD file, 2026-09-19]
hardware-site/docs/files/modules/hip-center_rev01.step
99.1 x 57.5 x 132.8 mm
CNC_leg02_x7_RS03_shaft_coupler
