generalroboticslab/Duke_Humanoid_V2_OpenSource/hardware-site/docs/files/step/3DP_legP10_shank_cover_b_rev01.step

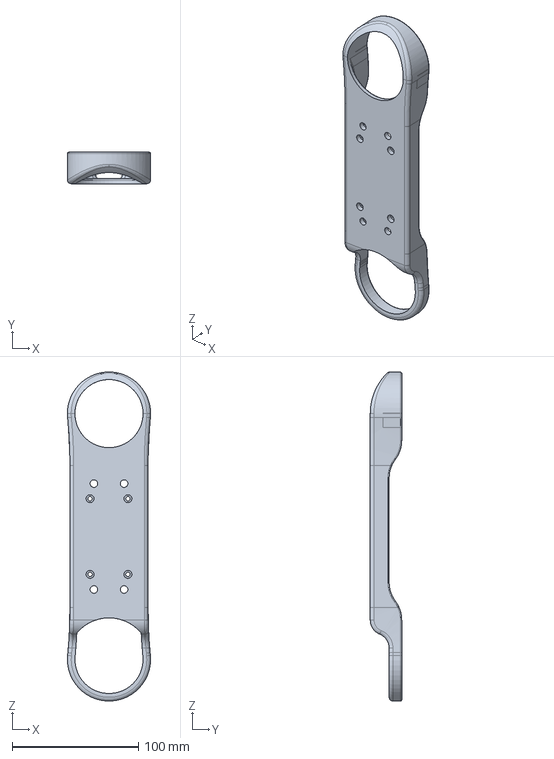
[picture p50: CAD file, 2026-09-19]
hardware-site/docs/files/step/3DP_legP10_shank_cover_b_rev01.step
66.0 x 25.0 x 260.9 mm
