generalroboticslab/Duke_Humanoid_V2_OpenSource/hardware-site/docs/files/modules/robstride-03-no-back-cover_rev01.step

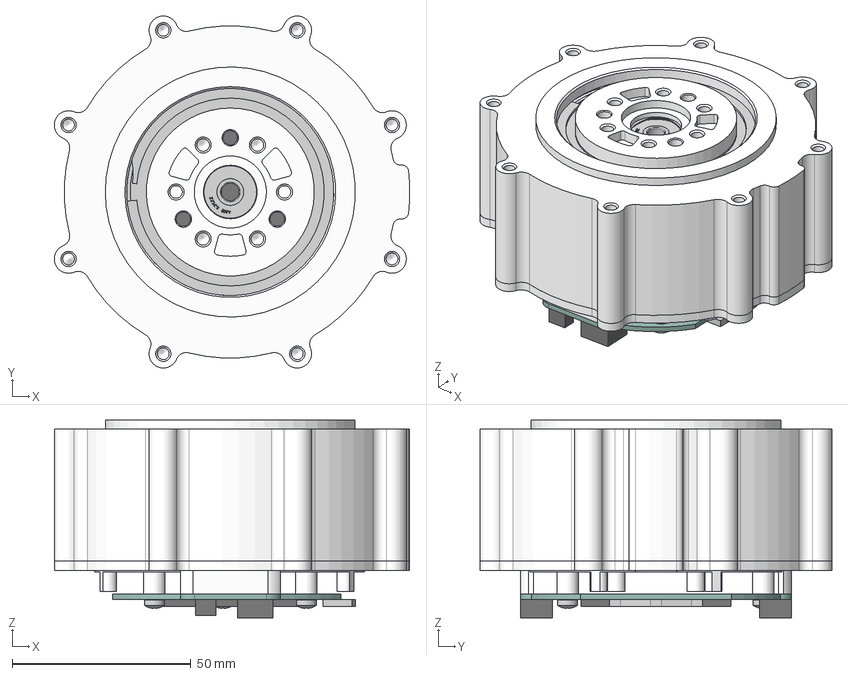
[picture p51: CAD file, 2026-09-19]
hardware-site/docs/files/modules/robstride-03-no-back-cover_rev01.step
99.5 x 98.5 x 55.4 mm
1_1_06_EB903-537_1_1
1_1_02_EB901-547_1
1_2_06_000004_AF0_1_1
1_1_31_QT-942_1
PBC
CORE
