generalroboticslab/Duke_Humanoid_V2_OpenSource/hardware-site/docs/files/step/3DP_armP09_shoulder_yaw_cover_a_rev01.step

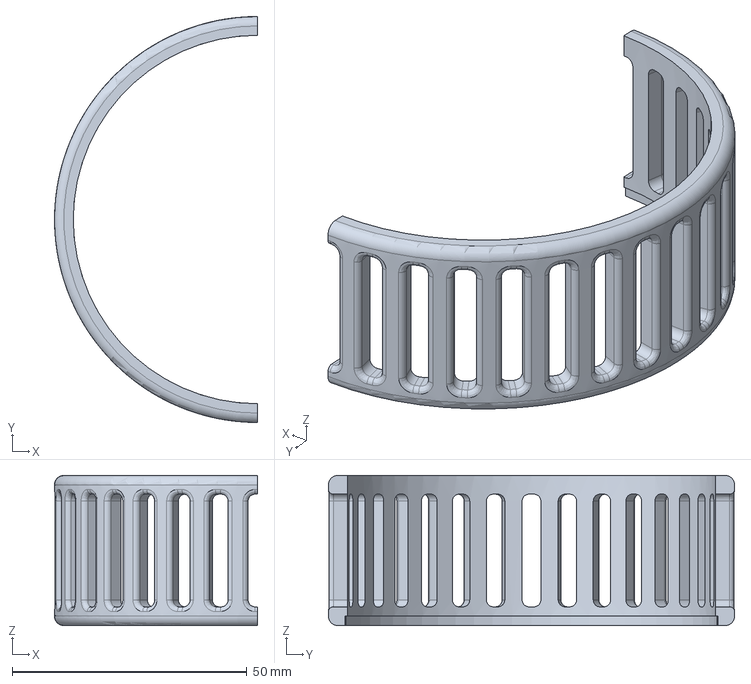
[picture p52: CAD file, 2026-09-19]
hardware-site/docs/files/step/3DP_armP09_shoulder_yaw_cover_a_rev01.step
43.3 x 86.5 x 32.0 mm
