generalroboticslab/Duke_Humanoid_V2_OpenSource/hardware-site/docs/files/modules/shoulder-pitch-shoulder-roll_rev01.step

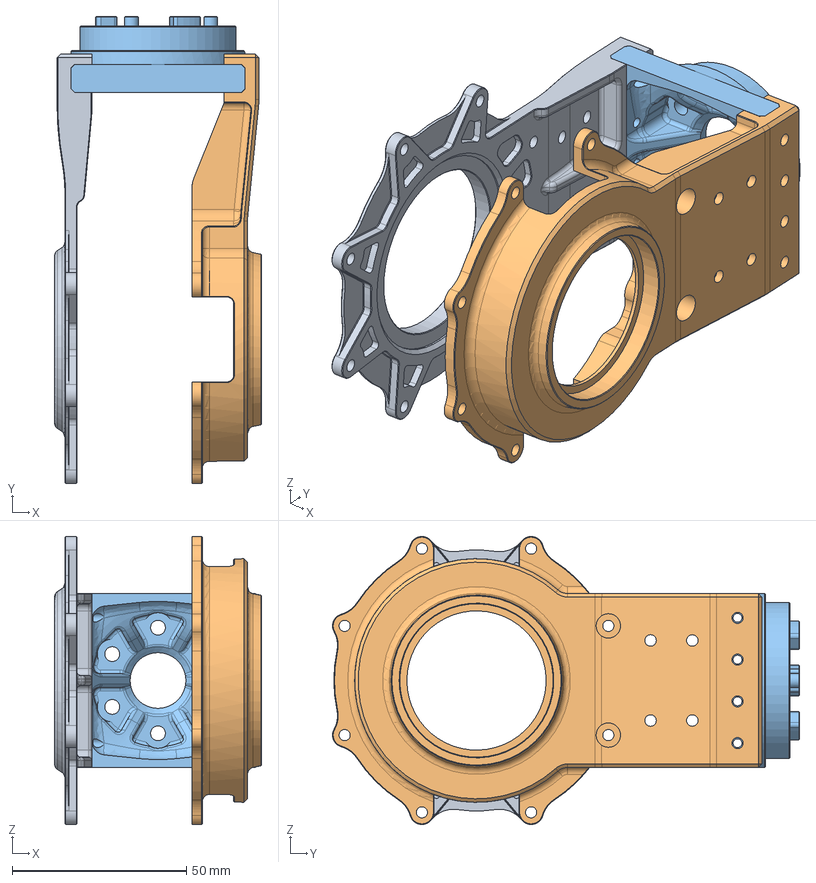
[picture p53: CAD file, 2026-09-19]
hardware-site/docs/files/modules/shoulder-pitch-shoulder-roll_rev01.step
59.5 x 134.2 x 82.8 mm
