generalroboticslab/Duke_Humanoid_V2_OpenSource/hardware-site/docs/files/modules/robstride-02-no-back-cover-2_rev01.step

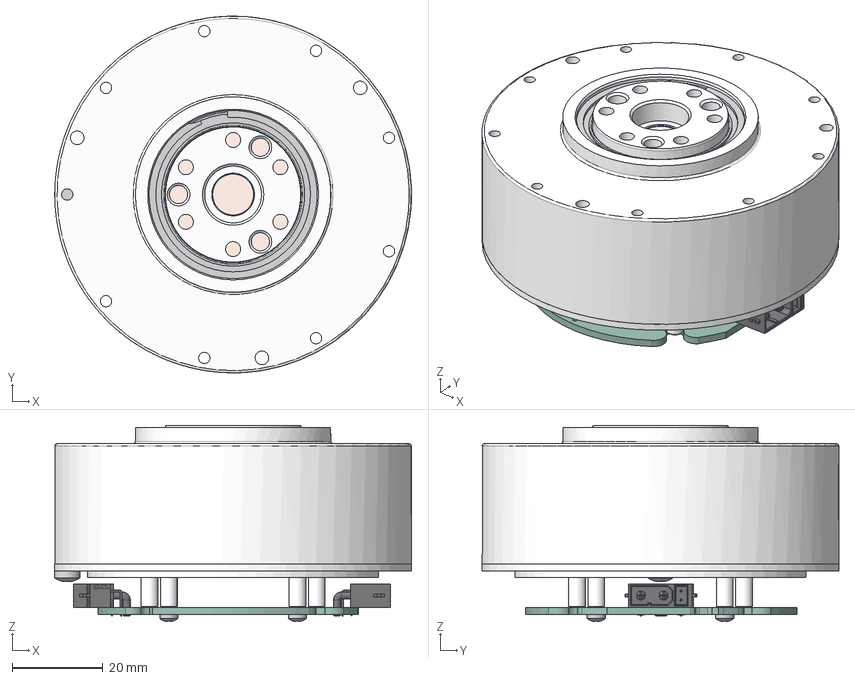
[picture p54: CAD file, 2026-09-19]
hardware-site/docs/files/modules/robstride-02-no-back-cover-2_rev01.step
78.5 x 78.5 x 43.1 mm
SOLID-183013_1.stp x 2
BOARD-17_1.stp
1_1_06_EB673-516_1.stp
1_1_02_EB671-502_1.stp
1_1_04_EB672-503_1.stp
1_2_05_QT-647_1.stp x 3
1_1_31_PL674-504_1.stp
1_2_04_670601_1.stp
1_2_06_000392_1.stp
1_2_05_QT-170_1.stp x 4
1_2_05_030080_1.stp
