generalroboticslab/Duke_Humanoid_V2_OpenSource/hardware-site/docs/files/step/3DP_body07_front_plate_removable_rev01.step

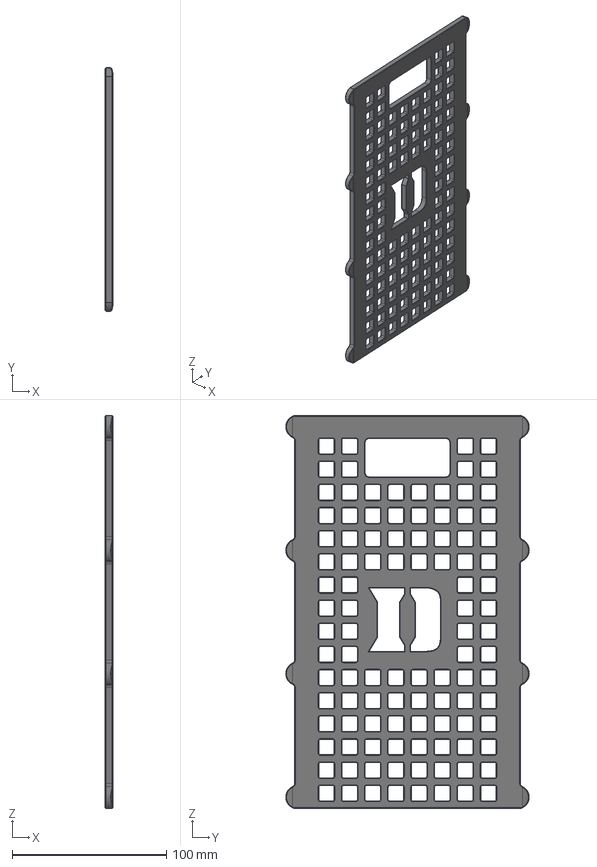
[picture p55: CAD file, 2026-09-19]
hardware-site/docs/files/step/3DP_body07_front_plate_removable_rev01.step
5.00 x 157.8 x 254.7 mm
magnet_1/2inD_1/16inT x 8
