generalroboticslab/Duke_Humanoid_V2_OpenSource/hardware-site/docs/files/step/3DP_armP05_shoulder_cover_c_rev01.step

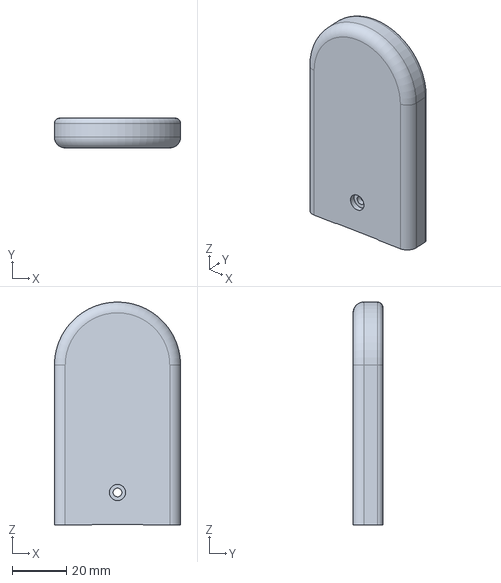
[picture p56: CAD file, 2026-09-19]
hardware-site/docs/files/step/3DP_armP05_shoulder_cover_c_rev01.step
46.6 x 11.0 x 82.3 mm
