generalroboticslab/Duke_Humanoid_V2_OpenSource/hardware-site/docs/files/modules/001-right-wrist-long-latest_rev01.step

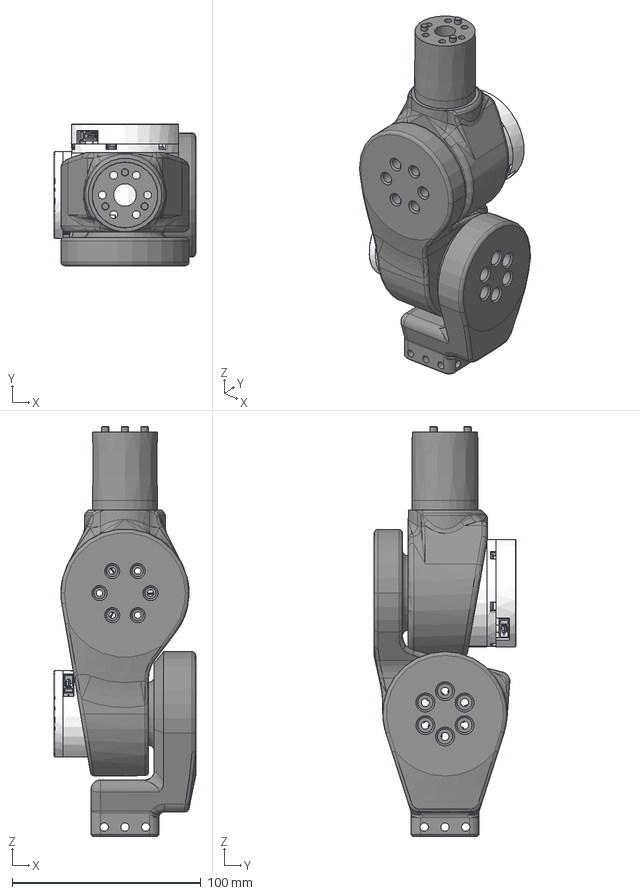
[picture p57: CAD file, 2026-09-19]
hardware-site/docs/files/modules/001-right-wrist-long-latest_rev01.step
75.0 x 75.0 x 217.3 mm
3DP_arm11_x2_wrist_roll
1_21_121000022__SGQZC619-4_4-.stp
SGQZC__35.stp
SOLID-17_CON_P4_11_438X3_2_HD_2.stp
SOLID-17_CON_P4_11_438X3_2_HD_3.stp
BOARD_3D_KMMV03_2024-10-21_2__2.stp
1_1_06_EB573-643.stp
1_1_04_EB572-5105.stp
1_2_04_000306.stp
1_1_02_EB571-960.stp
1_2_05_020068.stp x 7
1_1_14_PL574-570.stp
1_2_05_025121.stp x 4
1_2_05_000314.stp
1_1_06_EB573-642.stp
CORE
SCXXKL.stp
1_1_06_EB463-507^FL46BLW10-48V-5N.m-DE(2)_FL46BLW10-48V-5N.m-DE
1_1_02_EB461-502^FL46BLW10-48V-5N.m-DE(2)_FL46BLW10-48V-5N.m-DE
1_2_05_000438^FL46BLW10-48V-5N.m-DE(2)_FL46BLW10-48V-5N.m-DE x 8
1_2_16_001425^FL46BLW10-48V-5N.m-DE(2)_FL46BLW10-48V-5N.m-DE
1_1_06_EB463-509^FL46BLW10-48V-5N.m-DE(2)_FL46BLW10-48V-5N.m-DE
1_2_05_020051^FL46BLW10-48V-5N.m-DE(2)_FL46BLW10-48V-5N.m-DE x 3
1_2_05_000608^FL46BLW10-48V-5N.m-DE(2)_FL46BLW10-48V-5N.m-DE x 4
1_1_31_EB463-510^FL46BLW10-48V-5N.m-DE(2)_FL46BLW10-48V-5N.m-DE
1_2_05_000555^FL46BLW10-48V-5N.m-DE(2)_FL46BLW10-48V-5N.m-DE x 8
1_21_121000022__610001_1_1^00MINI-000_ASM_1_ASM_1_ASM_00MINI-_2025010 3_A0001_ASM_1_AS_ASM_1_1_30_GR-2202_ASM_1_ASM_1_1_30_GR-2202_ASM_FL46B LW10-48V-5N.m-DE(2)
0001755650^00MINI-000_ASM_1_ASM_1_ASM_00MINI-_20250103_A0001_ASM_1_AS _ASM_1_1_30_GR-2202_ASM_1_ASM_1_1_30_GR-2202_ASM_FL46BLW10-48V-5N.m-DE (2)_FL46BLW10-48V-5
0001755652^00MINI-000_ASM_1_ASM_1_ASM_00MINI-_20250103_A0001_ASM_1_AS _ASM_1_1_30_GR-2202_ASM_1_ASM_1_1_30_GR-2202_ASM_FL46BLW10-48V-5N.m-DE (2)_FL46BLW10-48V-5
6706__300001_1_1^00MINI-000_ASM_1_ASM_1_ASM_00MINI-_20250103_A0001_AS M_1_AS_ASM_1_1_30_GR-2202_ASM_1_ASM_1_1_30_GR-2202_ASM_FL46BLW10-48V-5 N.m-DE(2)_FL46BLW10
0001755652^1_1_30_GR-2202_ASM_1_ASM_1_1_30_GR-2202_ASM_FL46BLW10-48V- 5N.m-DE(2)_FL46BLW10-48V-5N.m-DE x 2
4668K258_Permanently Lubricated Stainless Steel Ball Bearing
4668K259_Permanently Lubricated Stainless Steel Ball Bearing
v15_wrist_bot
