generalroboticslab/Duke_Humanoid_V2_OpenSource/hardware-site/docs/files/step/CNC_leg03_RS03_shaft_bearing_retainer_rev01.step

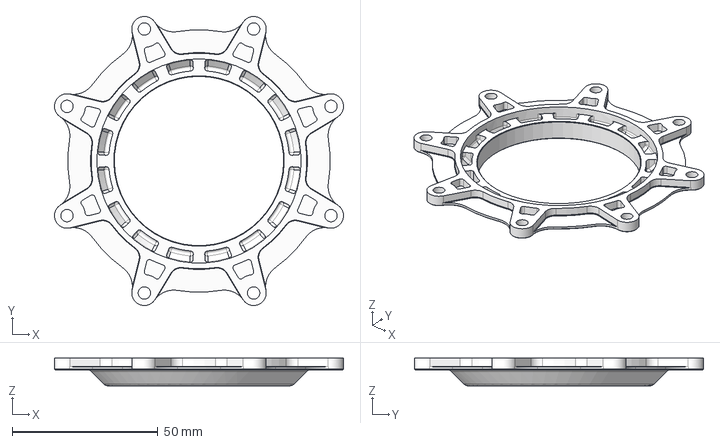
[picture p58: CAD file, 2026-09-19]
hardware-site/docs/files/step/CNC_leg03_RS03_shaft_bearing_retainer_rev01.step
99.1 x 99.1 x 9.50 mm
