generalroboticslab/Duke_Humanoid_V2_OpenSource/hardware-site/docs/files/modules/hip-pitch-motor_rev01.step

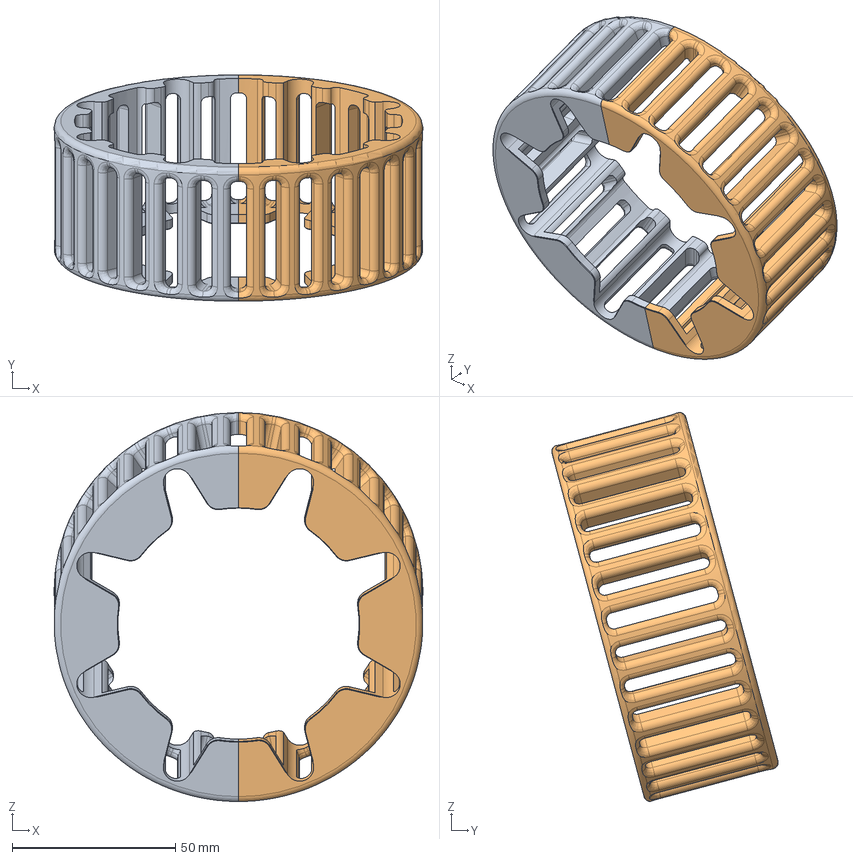
[picture p59: CAD file, 2026-09-19]
hardware-site/docs/files/modules/hip-pitch-motor_rev01.step
113.0 x 69.4 x 119.2 mm
