generalroboticslab/Duke_Humanoid_V2_OpenSource/hardware-site/docs/files/step/3DP_grip03_rail_rev01.step

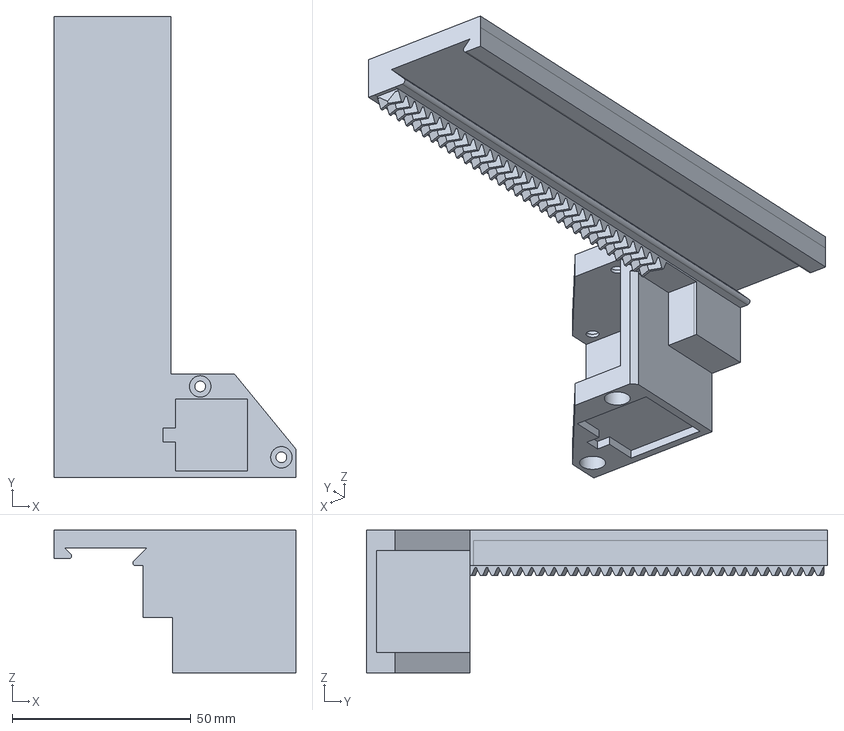
[picture p60: CAD file, 2026-09-19]
hardware-site/docs/files/step/3DP_grip03_rail_rev01.step
67.7 x 129.0 x 40.0 mm
