generalroboticslab/Duke_Humanoid_V2_OpenSource/hardware-site/docs/files/step/CNC_arm04_shoulder_roll_support_shaft_rev01.step

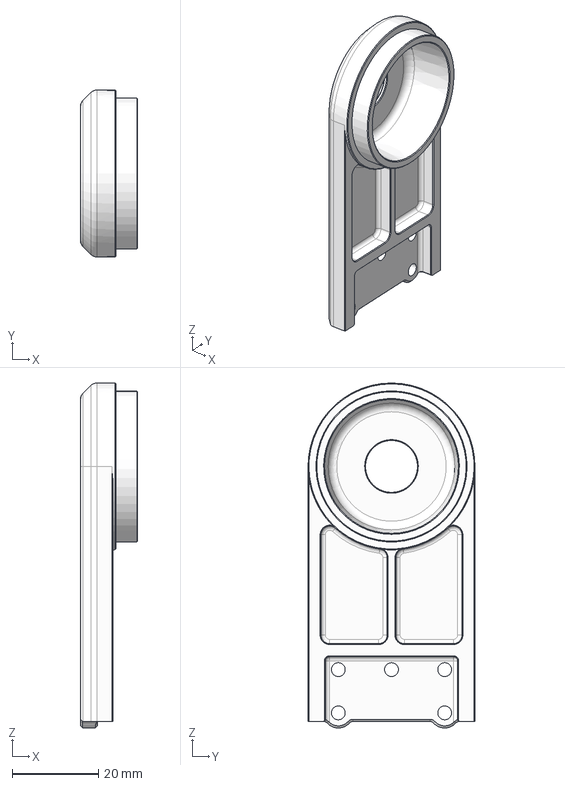
[picture p61: CAD file, 2026-09-19]
hardware-site/docs/files/step/CNC_arm04_shoulder_roll_support_shaft_rev01.step
13.3 x 38.6 x 79.8 mm
