generalroboticslab/Duke_Humanoid_V2_OpenSource/hardware-site/docs/files/modules/shoulder-roll-shaft_rev01.step

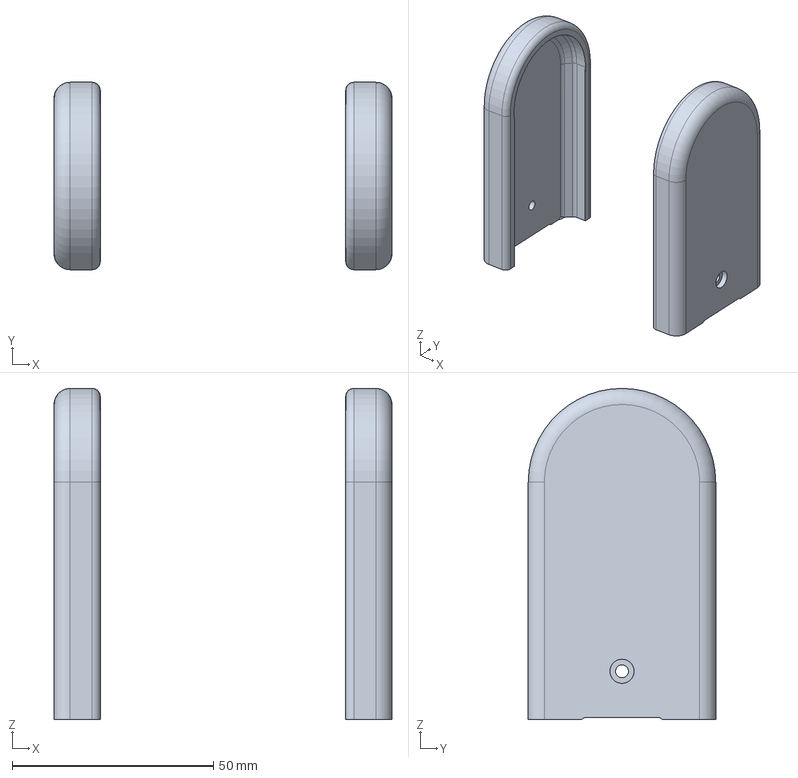
[picture p62: CAD file, 2026-09-19]
hardware-site/docs/files/modules/shoulder-roll-shaft_rev01.step
84.0 x 46.6 x 82.3 mm
