generalroboticslab/Duke_Humanoid_V2_OpenSource/hardware-site/docs/files/step/CNC_arm01_shoulder_roll_front_bearing_rev01.step

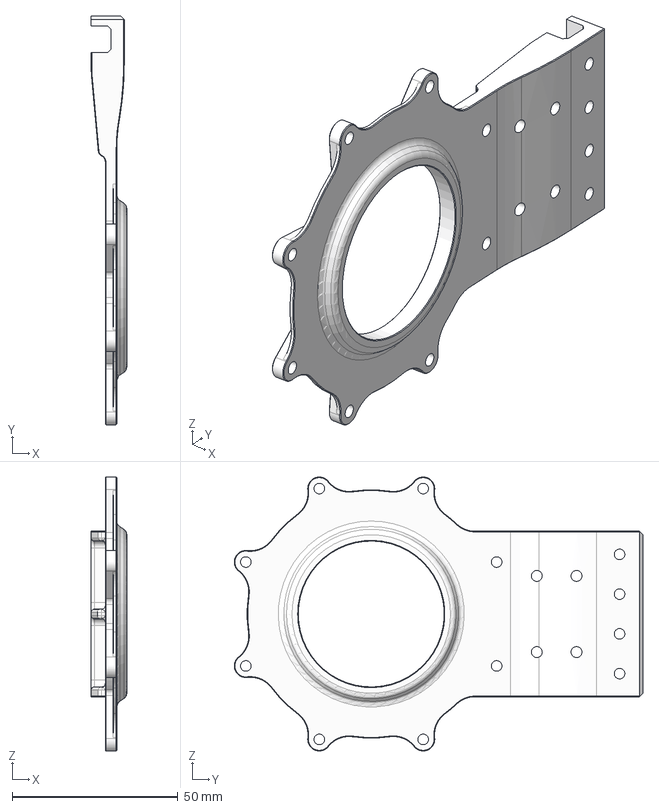
[picture p63: CAD file, 2026-09-19]
hardware-site/docs/files/step/CNC_arm01_shoulder_roll_front_bearing_rev01.step
10.8 x 123.4 x 82.8 mm
