generalroboticslab/Duke_Humanoid_V2_OpenSource/hardware-site/docs/files/modules/knee-motor-protection_rev01.step

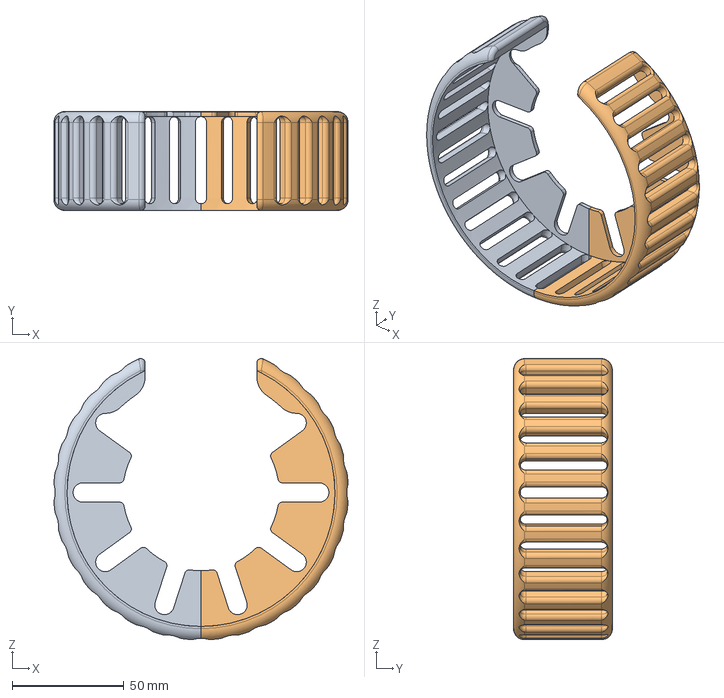
[picture p64: CAD file, 2026-09-19]
hardware-site/docs/files/modules/knee-motor-protection_rev01.step
131.7 x 44.3 x 125.9 mm
