generalroboticslab/Duke_Humanoid_V2_OpenSource/hardware-site/docs/files/step/CNC_body01_bottom_plate_rev01.step

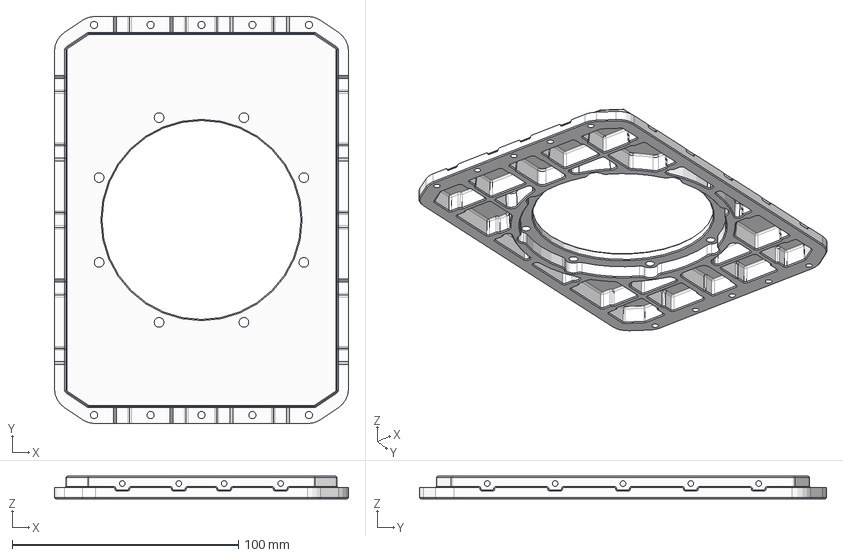
[picture p65: CAD file, 2026-09-19]
hardware-site/docs/files/step/CNC_body01_bottom_plate_rev01.step
130.0 x 180.0 x 10.0 mm
