generalroboticslab/Duke_Humanoid_V2_OpenSource/hardware-site/docs/files/modules/hip-roll-hip-yaw-l_rev01.step

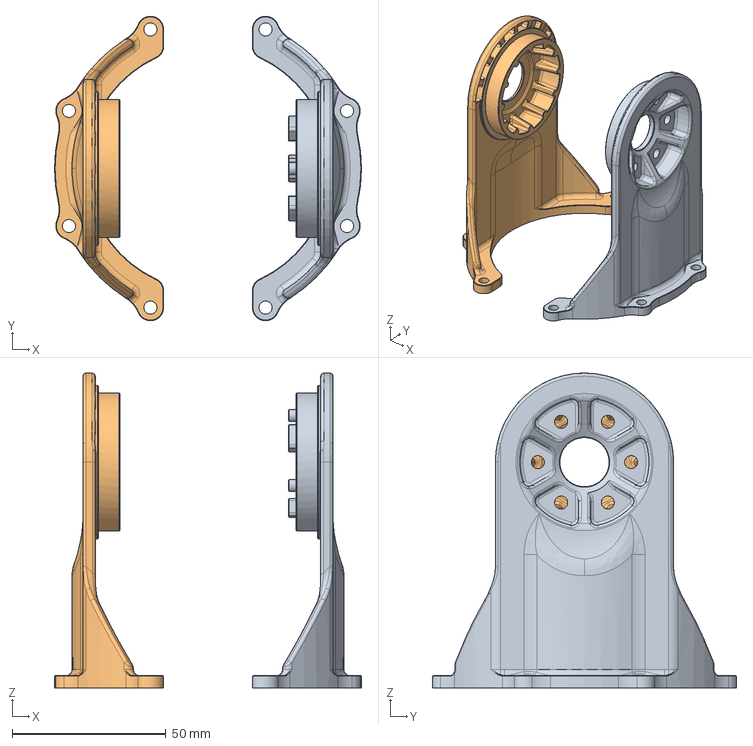
[picture p66: CAD file, 2026-09-19]
hardware-site/docs/files/modules/hip-roll-hip-yaw-l_rev01.step
99.9 x 99.1 x 102.5 mm
