generalroboticslab/Duke_Humanoid_V2_OpenSource/hardware-site/docs/files/step/3DP_armP01_elbow_cover_a_rev01.step

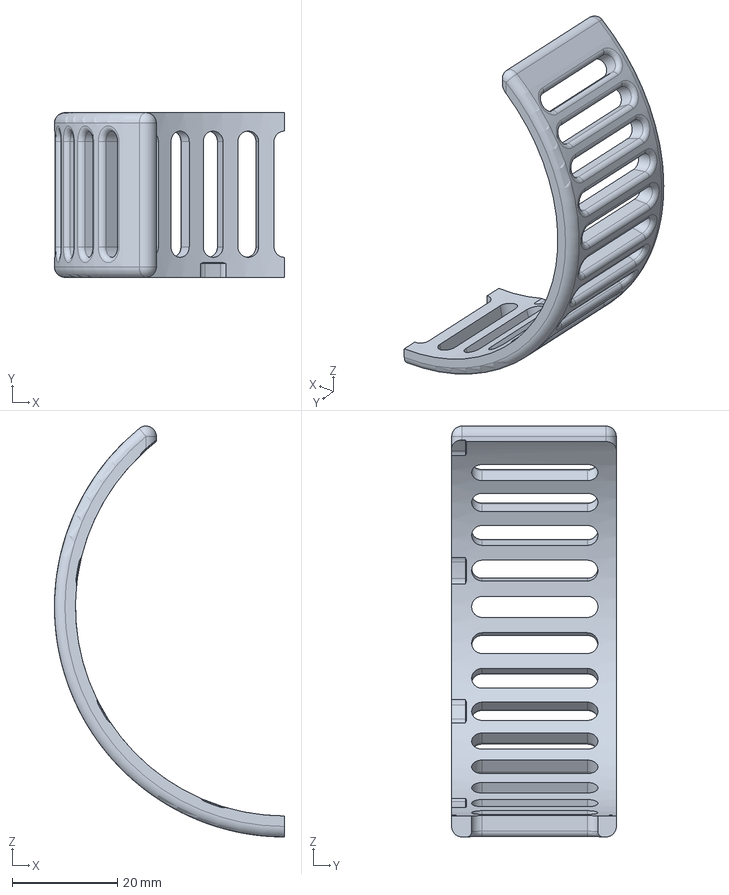
[picture p67: CAD file, 2026-09-19]
hardware-site/docs/files/step/3DP_armP01_elbow_cover_a_rev01.step
43.7 x 31.3 x 78.1 mm
