generalroboticslab/Duke_Humanoid_V2_OpenSource/hardware-site/docs/files/modules/base_rev01.step

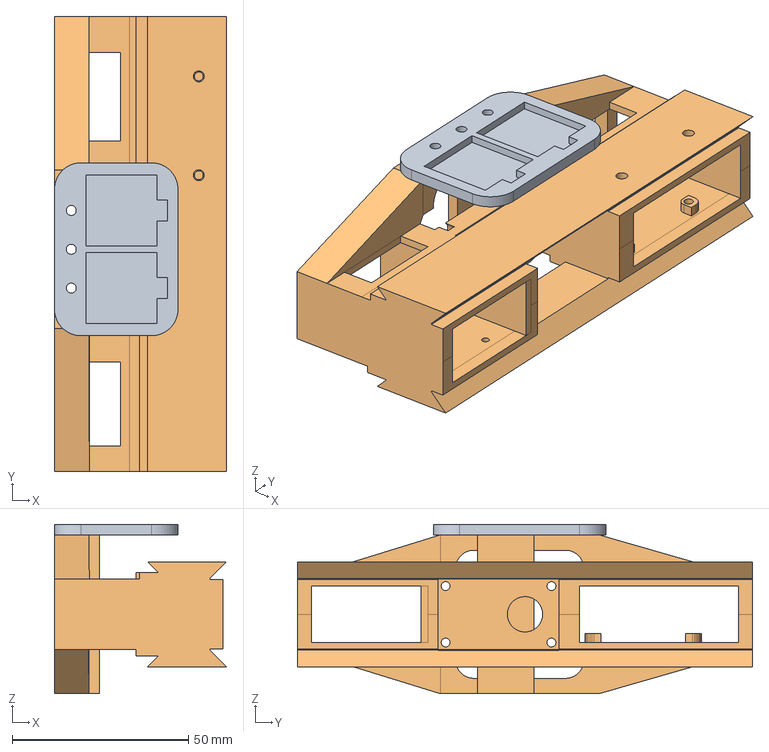
[picture p68: CAD file, 2026-09-19]
hardware-site/docs/files/modules/base_rev01.step
48.7 x 129.0 x 48.0 mm
