generalroboticslab/Duke_Humanoid_V2_OpenSource/hardware-site/docs/files/step/CNC_arm08_elbow_back_bearing_rev01.step

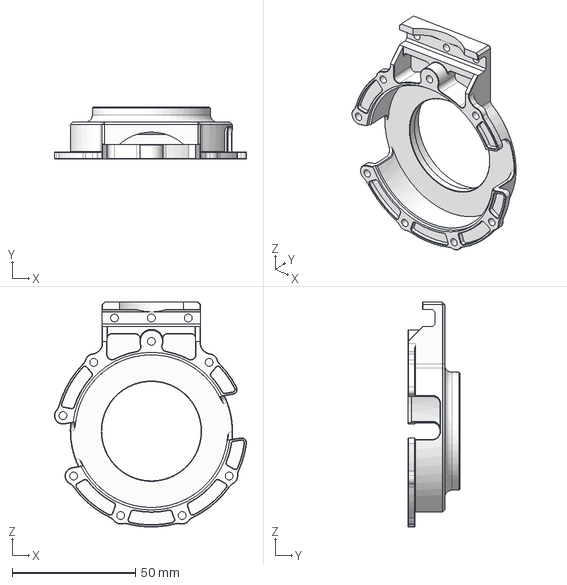
[picture p69: CAD file, 2026-09-19]
hardware-site/docs/files/step/CNC_arm08_elbow_back_bearing_rev01.step
78.1 x 21.3 x 91.4 mm
