generalroboticslab/Duke_Humanoid_V2_OpenSource/hardware-site/docs/files/modules/can-isolated_rev01.step

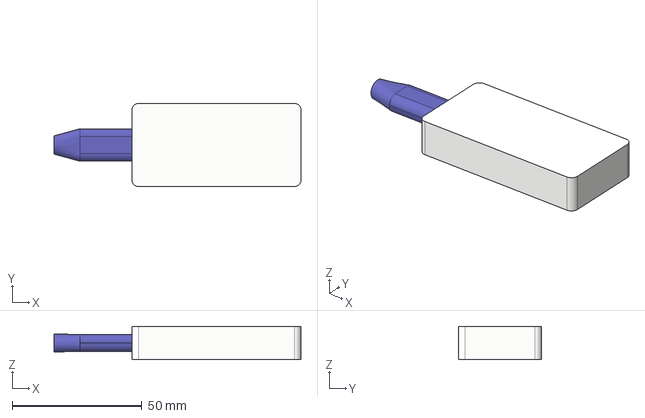
[picture p70: CAD file, 2026-09-19]
hardware-site/docs/files/modules/can-isolated_rev01.step
95.0 x 32.0 x 12.8 mm
