generalroboticslab/Duke_Humanoid_V2_OpenSource/hardware-site/docs/files/step/3DP_legP07_knee_cover_a_rev01.step

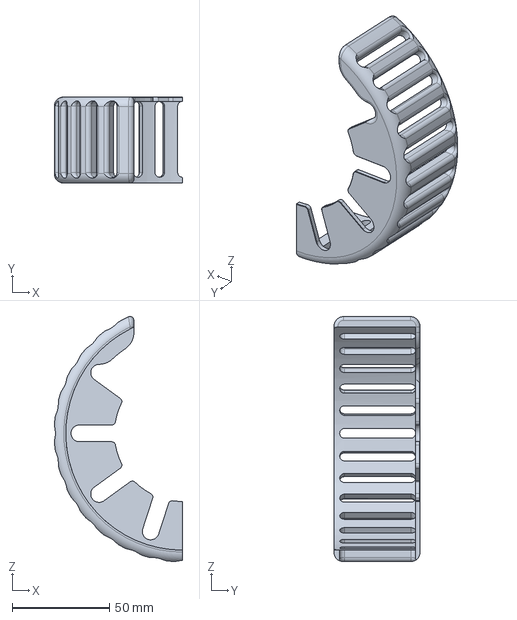
[picture p71: CAD file, 2026-09-19]
hardware-site/docs/files/step/3DP_legP07_knee_cover_a_rev01.step
65.8 x 44.3 x 125.9 mm
