generalroboticslab/Duke_Humanoid_V2_OpenSource/hardware-site/docs/files/modules/robstride-06-no-back-cover-2_rev01.step

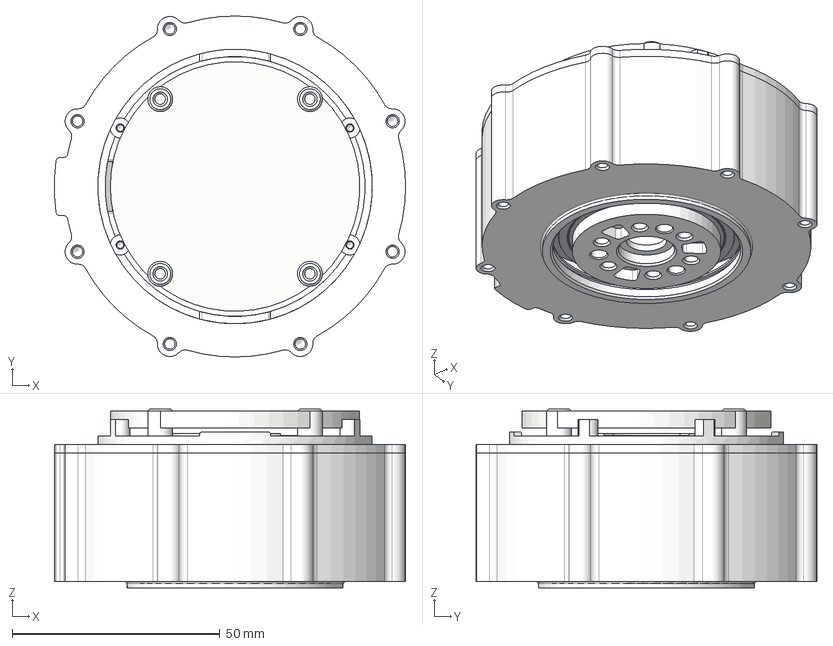
[picture p72: CAD file, 2026-09-19]
hardware-site/docs/files/modules/robstride-06-no-back-cover-2_rev01.step
84.5 x 82.0 x 43.0 mm
