generalroboticslab/Duke_Humanoid_V2_OpenSource/hardware-site/docs/files/step/3DP_armP11_shoulder_yaw_cover_c_rev01.step

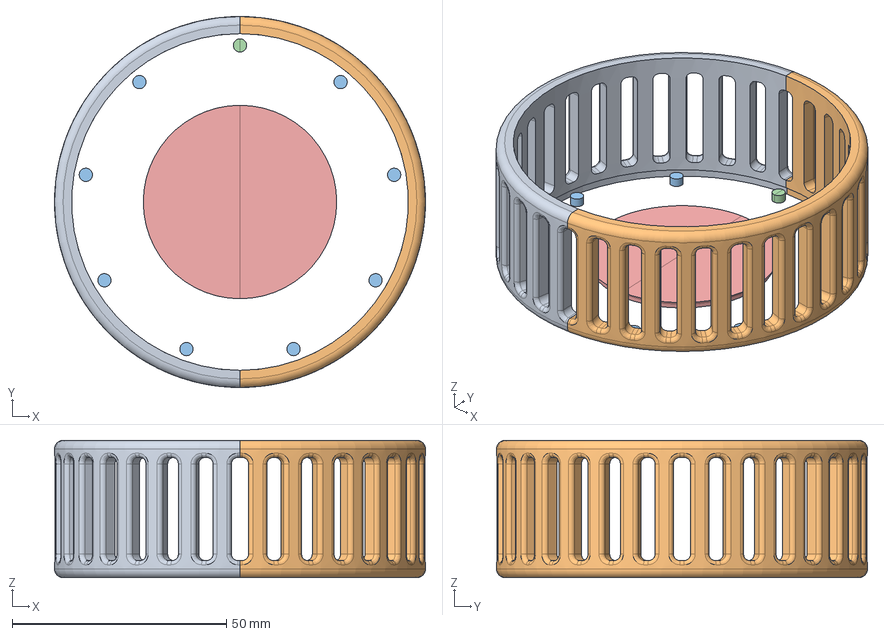
[picture p73: CAD file, 2026-09-19]
hardware-site/docs/files/step/3DP_armP11_shoulder_yaw_cover_c_rev01.step
86.5 x 86.5 x 32.0 mm
