generalroboticslab/Duke_Humanoid_V2_OpenSource/hardware-site/docs/files/step/CNC_leg05_hip_roll_back_bearing_retainer_rev01.step

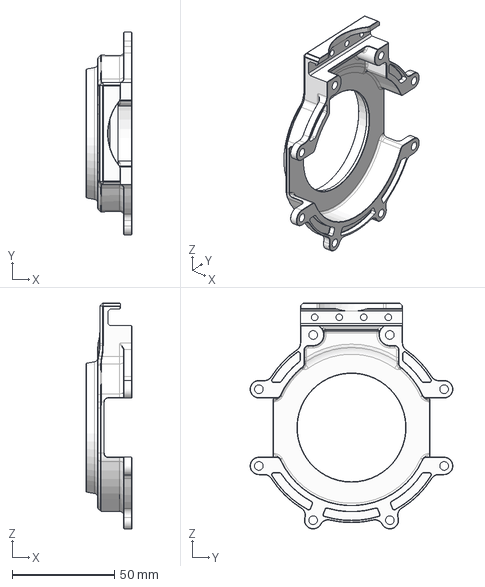
[picture p74: CAD file, 2026-09-19]
hardware-site/docs/files/step/CNC_leg05_hip_roll_back_bearing_retainer_rev01.step
22.4 x 99.1 x 110.5 mm
