generalroboticslab/Duke_Humanoid_V2_OpenSource/hardware-site/docs/files/step/CNC_leg11_knee_support_shank_rev01.step

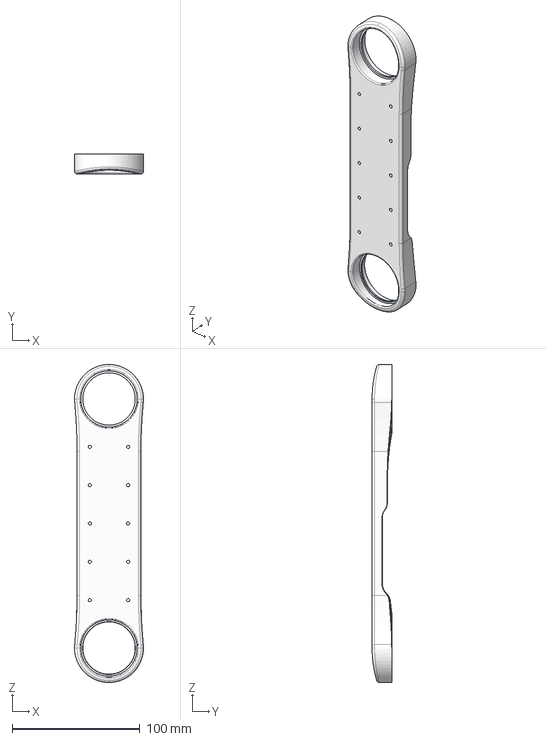
[picture p76: CAD file, 2026-09-19]
hardware-site/docs/files/step/CNC_leg11_knee_support_shank_rev01.step
54.0 x 15.5 x 249.0 mm
