generalroboticslab/Duke_Humanoid_V2_OpenSource/hardware-site/docs/files/modules/robstride-06-no-back-cover_rev01.step

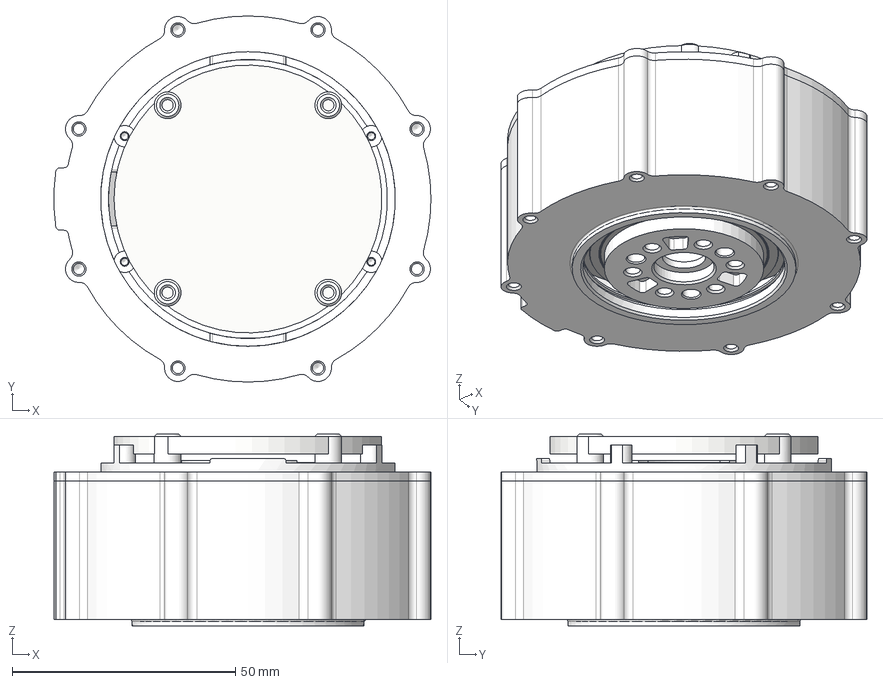
[picture p77: CAD file, 2026-09-19]
hardware-site/docs/files/modules/robstride-06-no-back-cover_rev01.step
84.5 x 82.0 x 43.0 mm
1_1_02_EB821-503^FL82BLW33-48V-35N.m(开模版)(1)_FL82BLW 33-48V-35N.m(开模版)(1).STEP
1_1_06_EB823-507_AF0^1_1_06_EB823-509_ASM_FL82BLW33-48V-35N.m(开模版) (1)_FL82BLW33-48V-35N.m(开模版)(1).STEP
1_1_31_QT-1040^FL82BLW33-48V-35N.m(开模版)(1)_FL82BLW33 -48V-35N.m(开模版)(1).STEP
weight
4668K259_Permanently Lubricated Stainless Steel Ball Bearing
