generalroboticslab/Duke_Humanoid_V2_OpenSource/hardware-site/docs/files/step/CNC_body02_side_plate_rev01.step

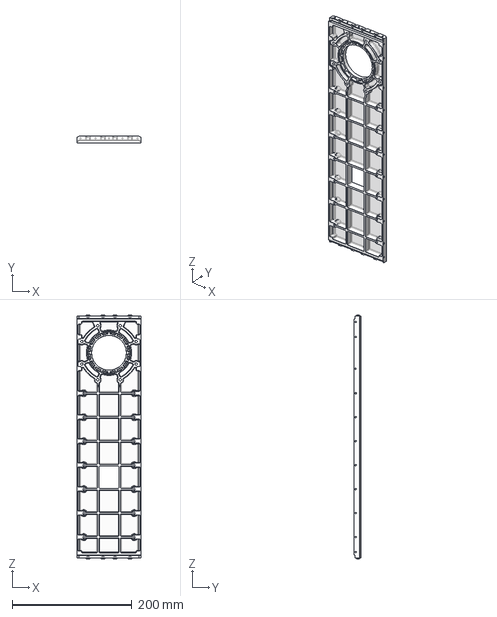
[picture p78: CAD file, 2026-09-19]
hardware-site/docs/files/step/CNC_body02_side_plate_rev01.step
107.5 x 12.0 x 407.0 mm
