generalroboticslab/Duke_Humanoid_V2_OpenSource/hardware-site/docs/files/modules/hip-roll-motor_rev01.step

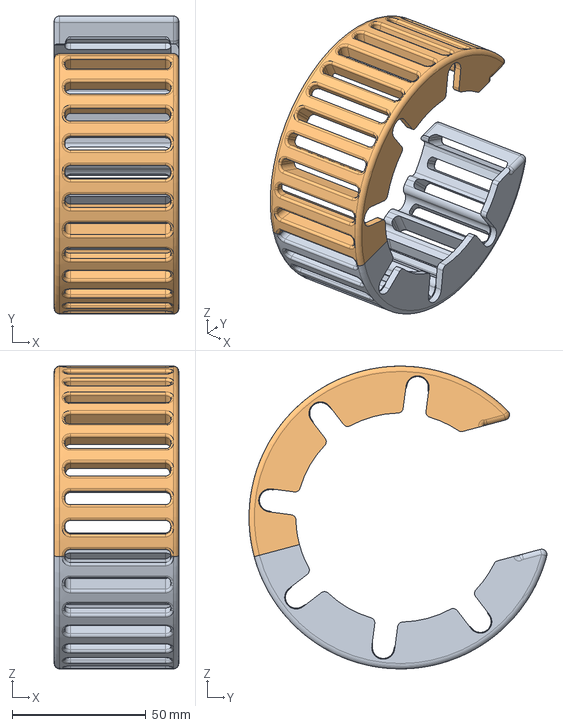
[picture p79: CAD file, 2026-09-19]
hardware-site/docs/files/modules/hip-roll-motor_rev01.step
46.5 x 111.2 x 113.0 mm
