generalroboticslab/Duke_Humanoid_V2_OpenSource/hardware-site/docs/files/step/3DP_grip02_finger_rev01.step

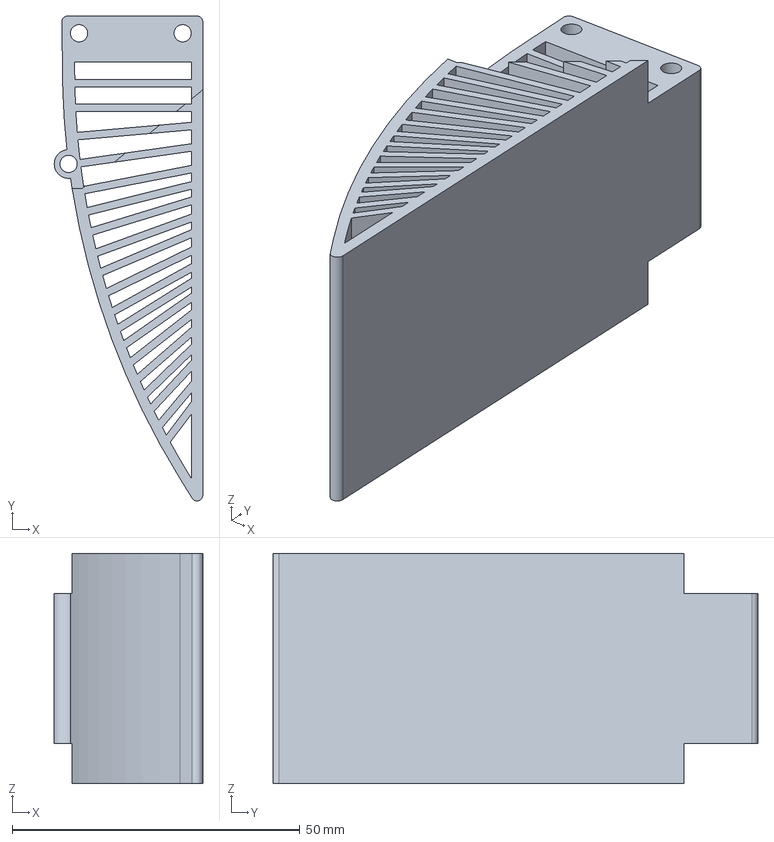
[picture p80: CAD file, 2026-09-19]
hardware-site/docs/files/step/3DP_grip02_finger_rev01.step
25.8 x 84.3 x 40.0 mm
