generalroboticslab/Duke_Humanoid_V2_OpenSource/hardware-site/docs/files/modules/elbow-motor-protection_rev01.step

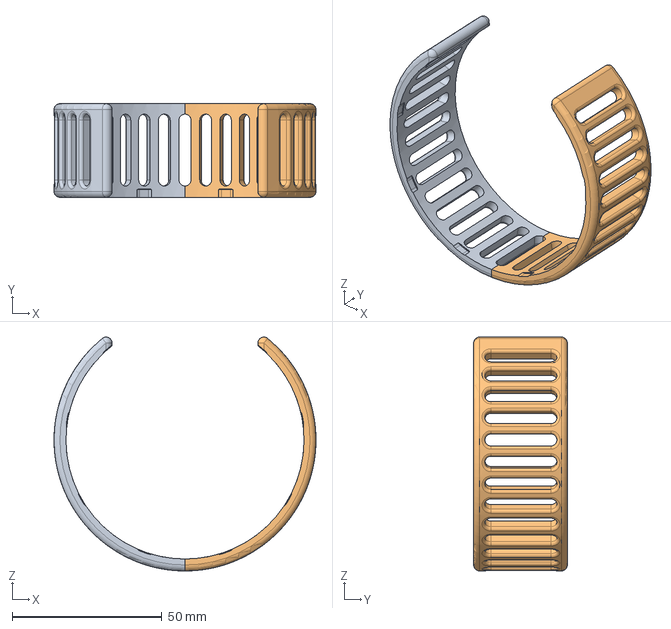
[picture p81: CAD file, 2026-09-19]
hardware-site/docs/files/modules/elbow-motor-protection_rev01.step
87.5 x 31.3 x 78.1 mm
