generalroboticslab/Duke_Humanoid_V2_OpenSource/hardware-site/docs/files/step/3DP_leg20_foot_front_rev01.step

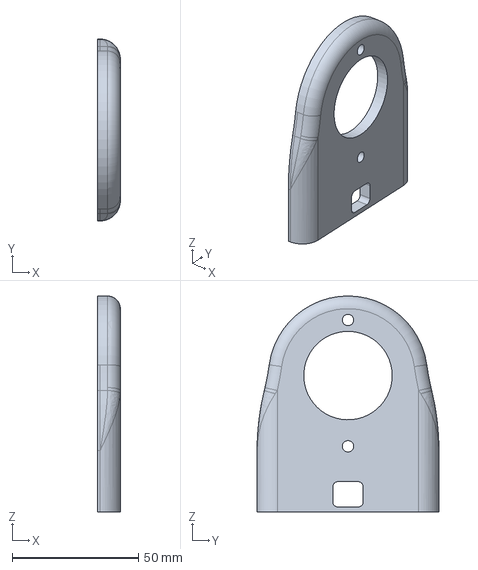
[picture p82: CAD file, 2026-09-19]
hardware-site/docs/files/step/3DP_leg20_foot_front_rev01.step
9.00 x 72.0 x 85.5 mm
