generalroboticslab/Duke_Humanoid_V2_OpenSource/hardware-site/docs/files/step/3DP_arm05_RS02_shaft_bearing_retainer_rev01.step

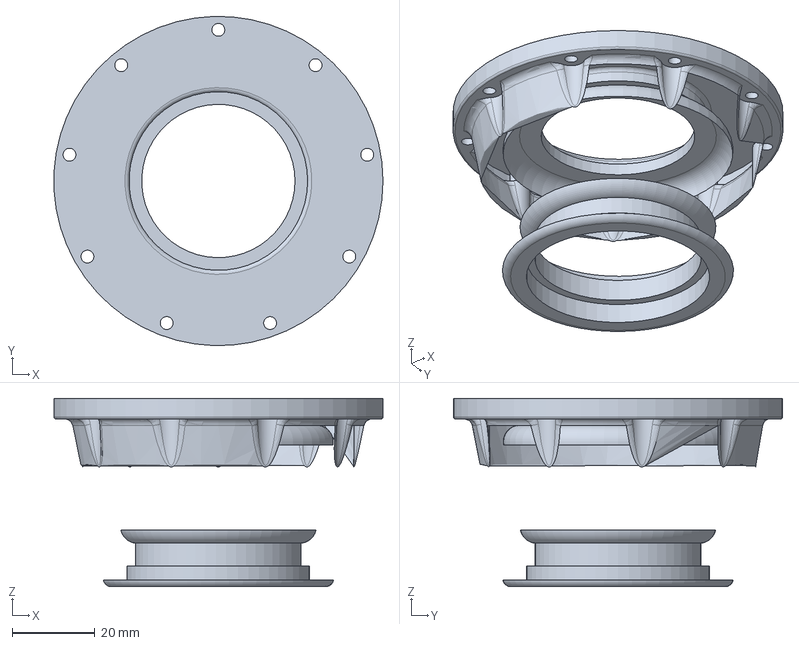
[picture p84: CAD file, 2026-09-19]
hardware-site/docs/files/step/3DP_arm05_RS02_shaft_bearing_retainer_rev01.step
79.4 x 79.5 x 45.5 mm
