generalroboticslab/Duke_Humanoid_V2_OpenSource/hardware-site/docs/files/modules/robstride05-v16-1_rev01.step

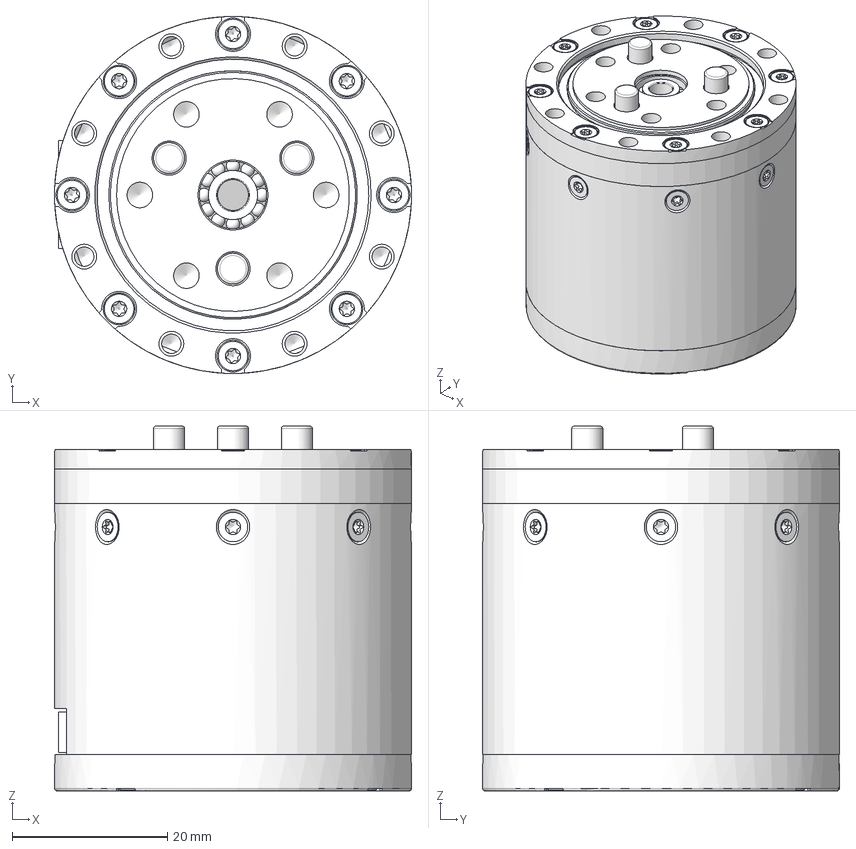
[picture p85: CAD file, 2026-09-19]
hardware-site/docs/files/modules/robstride05-v16-1_rev01.step
46.0 x 46.0 x 47.0 mm
