generalroboticslab/Duke_Humanoid_V2_OpenSource/hardware-site/docs/files/step/3DP_cam01_gimbal_mount_rev01.step

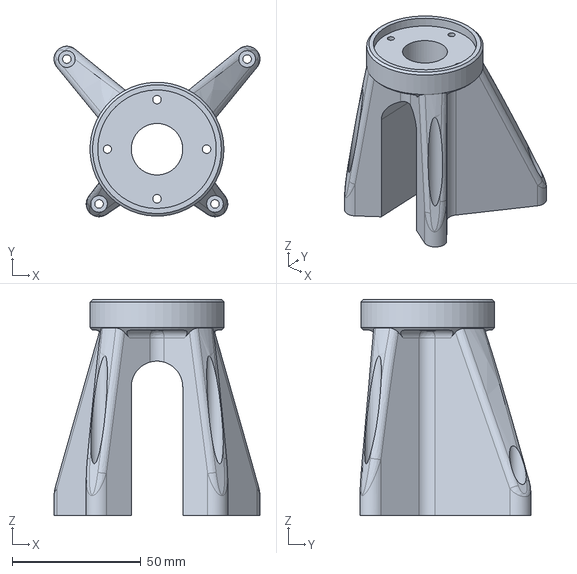
[picture p86: CAD file, 2026-09-19]
hardware-site/docs/files/step/3DP_cam01_gimbal_mount_rev01.step
80.0 x 66.3 x 84.0 mm
