generalroboticslab/Duke_Humanoid_V2_OpenSource/hardware-site/docs/files/step/CNC_leg01_hip_center_back_rev01.step

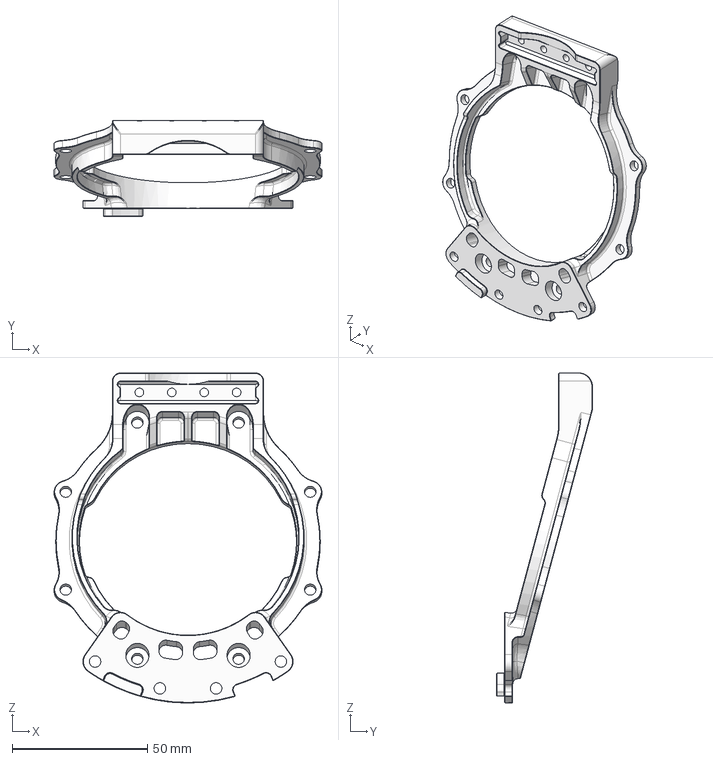
[picture p87: CAD file, 2026-09-19]
hardware-site/docs/files/step/CNC_leg01_hip_center_back_rev01.step
99.1 x 35.5 x 122.2 mm
