generalroboticslab/Duke_Humanoid_V2_OpenSource/hardware-site/docs/files/step/CNC_body03_top_plate_rev01.step

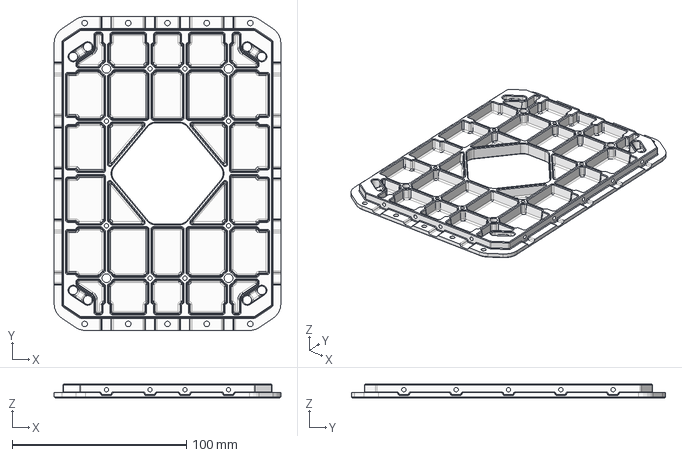
[picture p89: CAD file, 2026-09-19]
hardware-site/docs/files/step/CNC_body03_top_plate_rev01.step
130.0 x 180.0 x 8.00 mm
