generalroboticslab/Duke_Humanoid_V2_OpenSource/hardware-site/docs/files/modules/3dp-body-05-x1-interior-plate_rev01.step

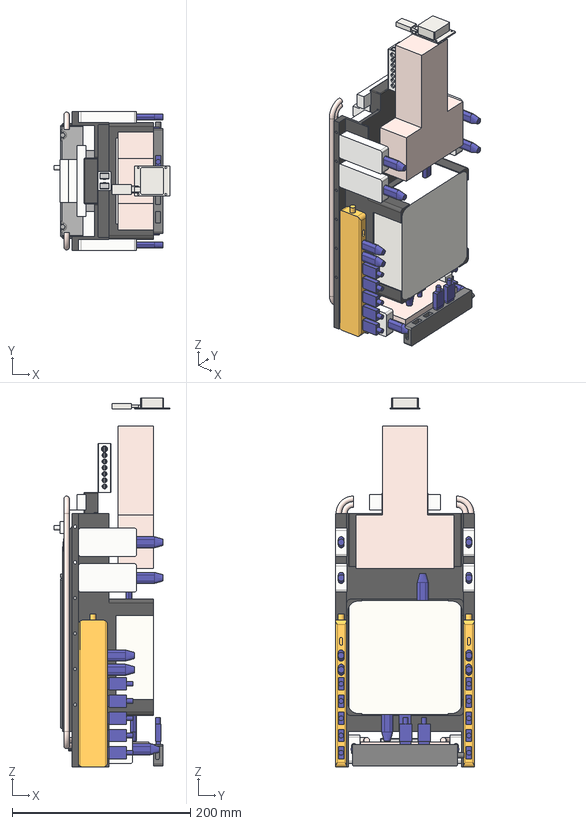
[picture p90: CAD file, 2026-09-19]
hardware-site/docs/files/modules/3dp-body-05-x1-interior-plate_rev01.step
130.1 x 156.3 x 414.6 mm
MINISFORUM AI X1
battery_zeee_10000mah x 2
battery_tester x 2
150A relay
casing
block x 4
VEMONT USB-C Hub Long x 2
casing_1
Hub
USB Straight x 13
USB-C Cable x 12
