generalroboticslab/Duke_Humanoid_V2_OpenSource/hardware-site/docs/files/step/3DP_armP08_shoulder_cover_f_rev01.step

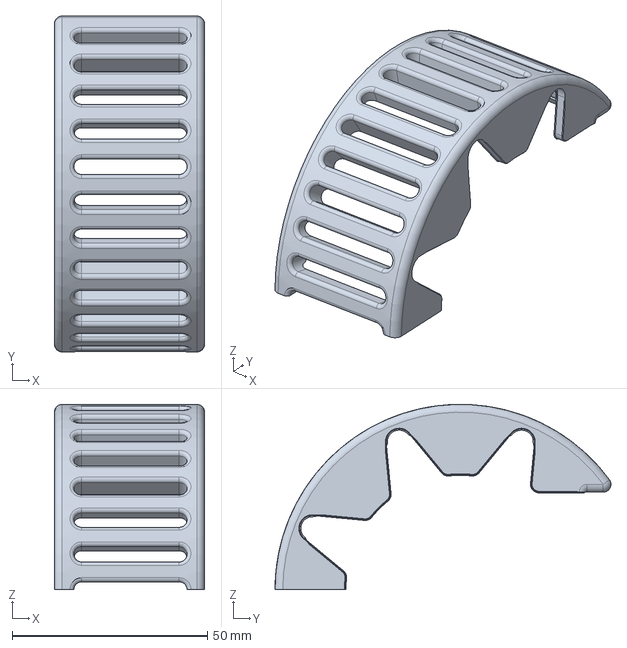
[picture p91: CAD file, 2026-09-19]
hardware-site/docs/files/step/3DP_armP08_shoulder_cover_f_rev01.step
38.5 x 86.1 x 47.5 mm
