generalroboticslab/Duke_Humanoid_V2_OpenSource/hardware-site/docs/files/step/CNC_arm03_shoulder_roll_output_shaft_rev01.step

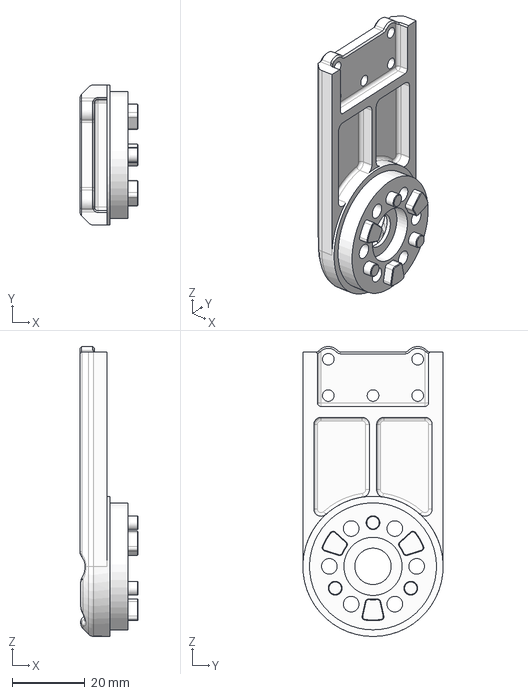
[picture p92: CAD file, 2026-09-19]
hardware-site/docs/files/step/CNC_arm03_shoulder_roll_output_shaft_rev01.step
16.1 x 38.6 x 79.8 mm
