generalroboticslab/Duke_Humanoid_V2_OpenSource/hardware-site/docs/files/step/3DP_arm15_end_effector_attachment_rev01.step

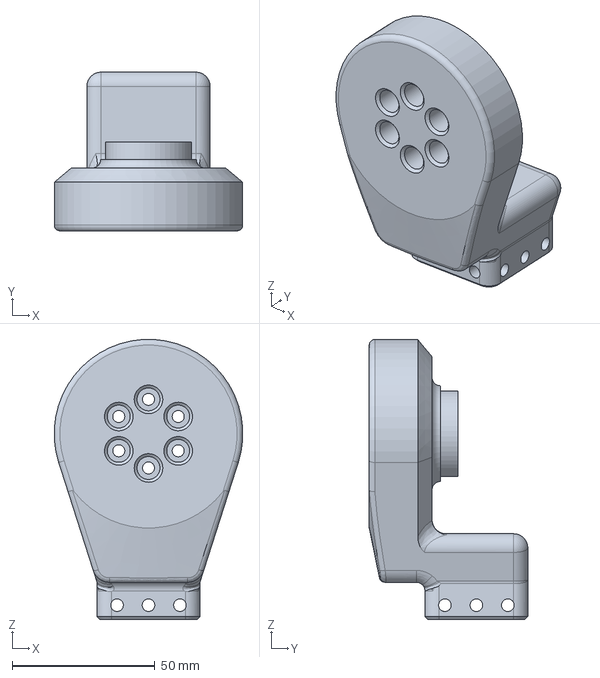
[picture p93: CAD file, 2026-09-19]
hardware-site/docs/files/step/3DP_arm15_end_effector_attachment_rev01.step
65.9 x 55.5 x 97.9 mm
