generalroboticslab/Duke_Humanoid_V2_OpenSource/hardware-site/docs/files/modules/shoulder-pitch-protection-2_rev01.step

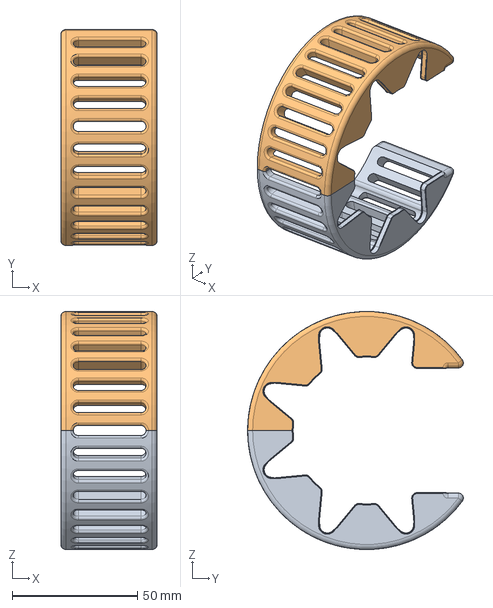
[picture p94: CAD file, 2026-09-19]
hardware-site/docs/files/modules/shoulder-pitch-protection-2_rev01.step
38.5 x 86.1 x 95.0 mm
