generalroboticslab/Duke_Humanoid_V2_OpenSource/hardware-site/docs/files/step/3DP_grip06_apriltag_tile_rev01.step

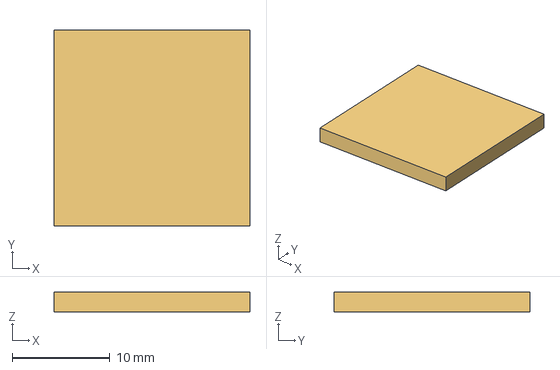
[picture p95: CAD file, 2026-09-19]
hardware-site/docs/files/step/3DP_grip06_apriltag_tile_rev01.step
20.0 x 20.0 x 2.00 mm
