generalroboticslab/Duke_Humanoid_V2_OpenSource/hardware-site/docs/files/modules/robstride04_rev01.step

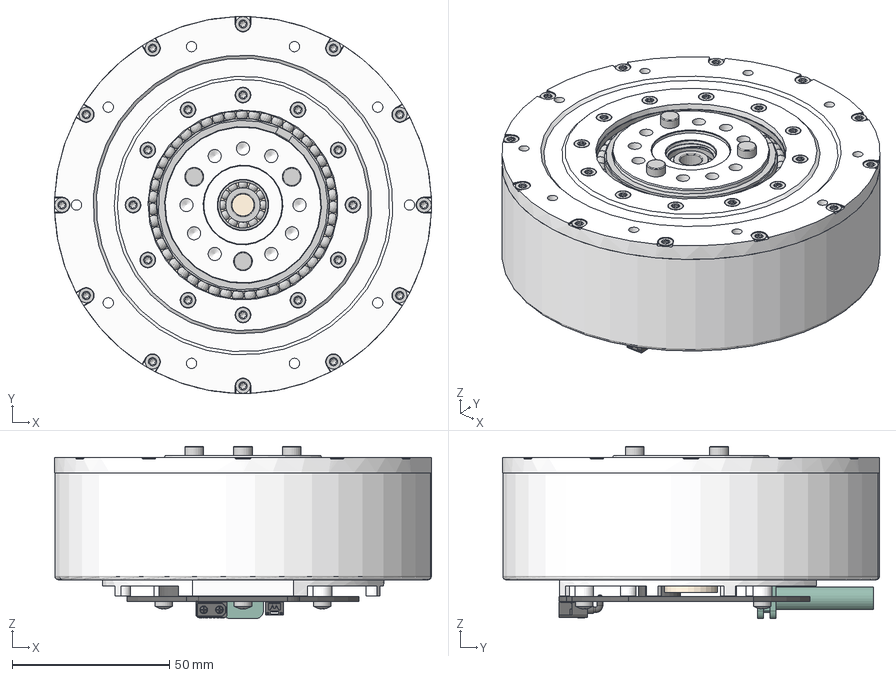
[picture p96: CAD file, 2026-09-19]
hardware-site/docs/files/modules/robstride04_rev01.step
120.0 x 120.0 x 54.9 mm
_PIS72-D6X_1_1_1 x 3
D19_1_1_1
_GYOS72-17_93_I__1_1_1
ZYDQHJ_1_1_1
1_1_02_EB1201-501_1_1_1
1_1_06_EB1203-503_1_1_1
1_1_31_EB1203-505_1_1_1
1_2_05_QT-104_1_1_1
DIANJIBAN-2_SW0001_1_1_2_1
SR_1__1
