generalroboticslab/Duke_Humanoid_V2_OpenSource/hardware-site/docs/files/step/CNC_leg14_ankle_pitch_back_rev01.step

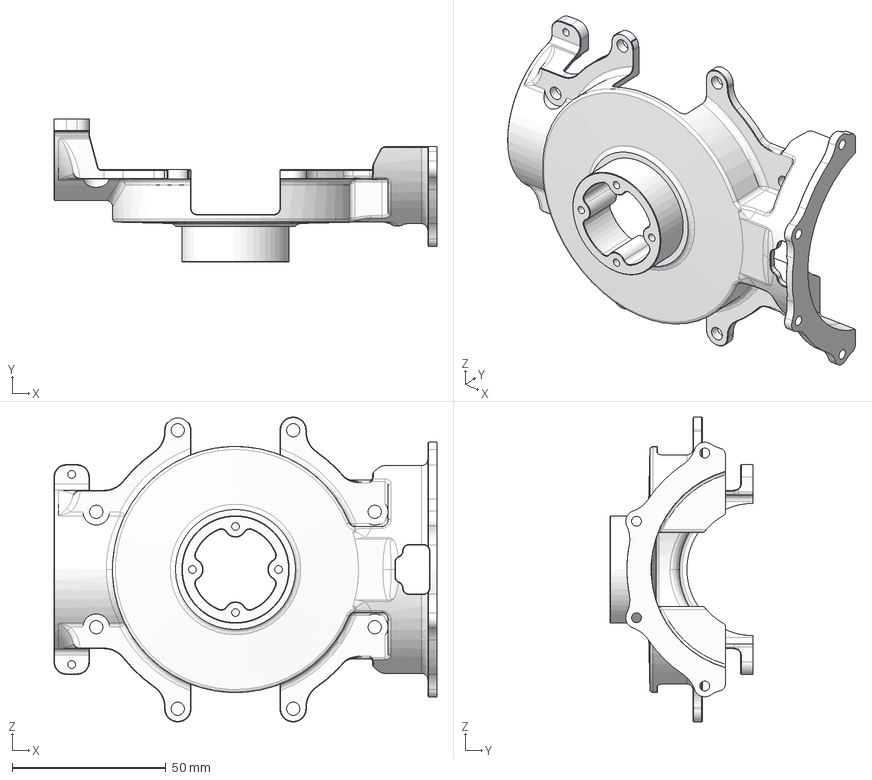
[picture p97: CAD file, 2026-09-19]
hardware-site/docs/files/step/CNC_leg14_ankle_pitch_back_rev01.step
124.5 x 46.5 x 99.1 mm
