generalroboticslab/Duke_Humanoid_V2_OpenSource/hardware-site/docs/files/step/3DP_leg19_sole_rev01.step

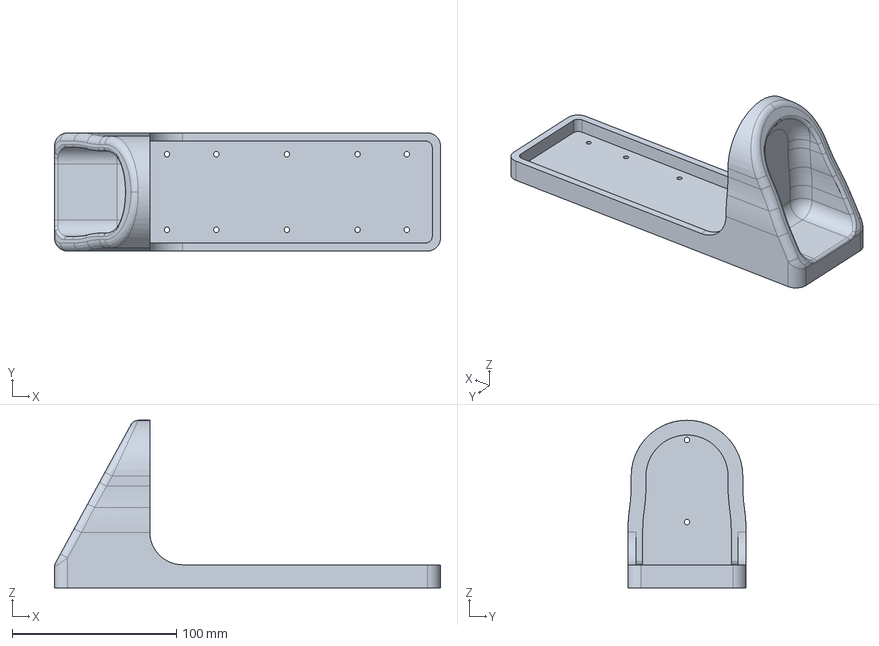
[picture p98: CAD file, 2026-09-19]
hardware-site/docs/files/step/3DP_leg19_sole_rev01.step
235.0 x 72.0 x 102.0 mm
