generalroboticslab/Duke_Humanoid_V2_OpenSource/hardware-site/docs/files/modules/3dp-arm06-x4-rs02-shaft-coupler_rev01.step

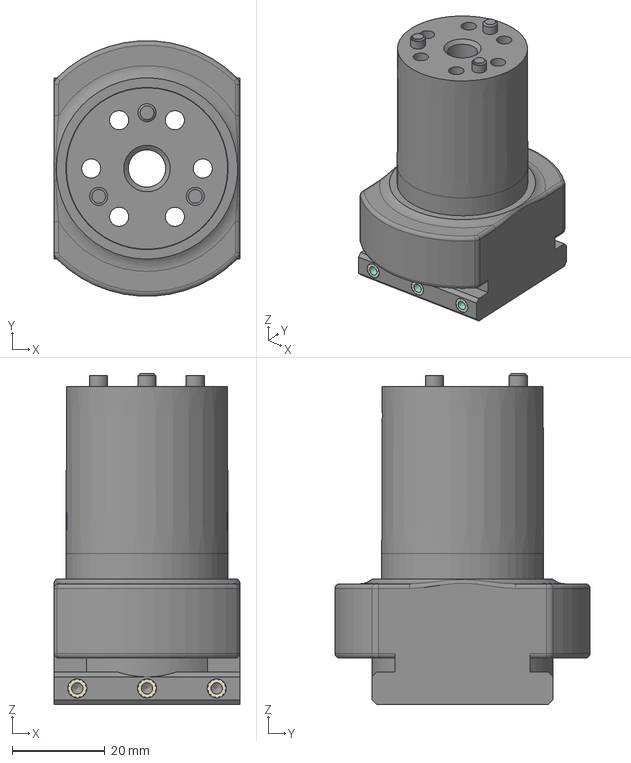
[picture p99: CAD file, 2026-09-19]
hardware-site/docs/files/modules/3dp-arm06-x4-rs02-shaft-coupler_rev01.step
40.0 x 54.9 x 71.2 mm
