generalroboticslab/Duke_Humanoid_V2_OpenSource/hardware-site/docs/files/modules/cnc-leg18-x2-foot-plate_rev01.step

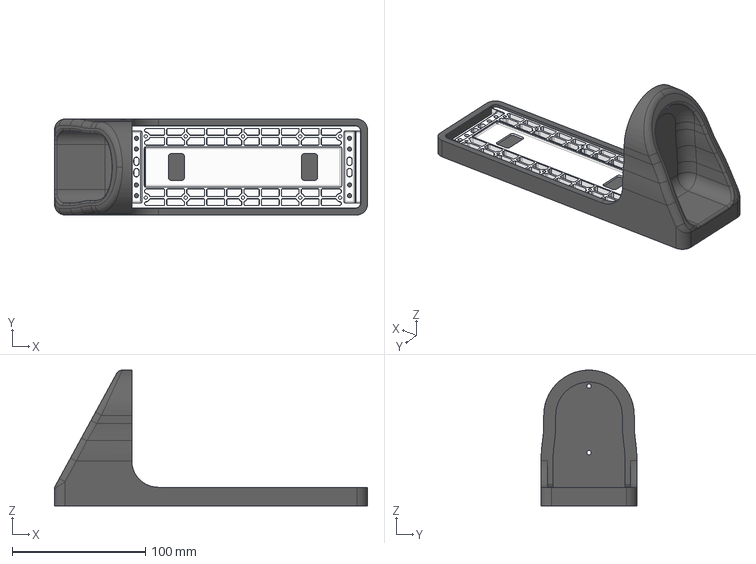
[picture p100: CAD file, 2026-09-19]
hardware-site/docs/files/modules/cnc-leg18-x2-foot-plate_rev01.step
235.0 x 72.0 x 102.0 mm
