generalroboticslab/Duke_Humanoid_V2_OpenSource/hardware-site/docs/files/modules/shoulder-yaw-elbow_rev01.step

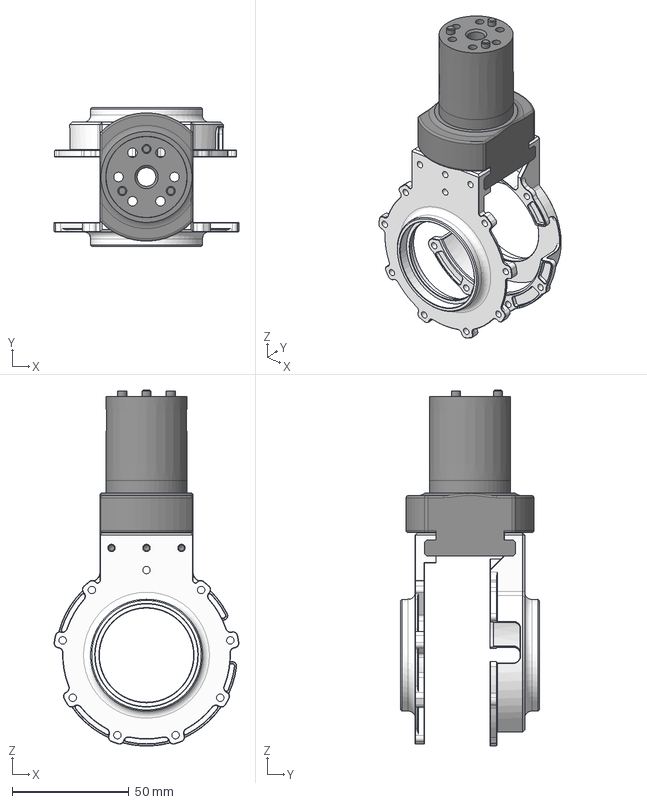
[picture p101: CAD file, 2026-09-19]
hardware-site/docs/files/modules/shoulder-yaw-elbow_rev01.step
79.3 x 59.5 x 152.7 mm
