generalroboticslab/Duke_Humanoid_V2_OpenSource/hardware-site/docs/files/step/CNC_leg16_ankle_roll_output_shaft_rev01.step

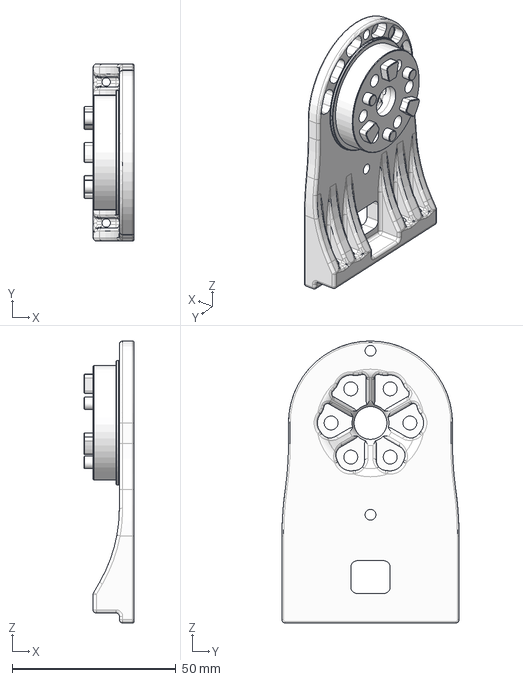
[picture p102: CAD file, 2026-09-19]
hardware-site/docs/files/step/CNC_leg16_ankle_roll_output_shaft_rev01.step
15.3 x 54.0 x 86.0 mm
