generalroboticslab/Duke_Humanoid_V2_OpenSource/hardware-site/docs/files/modules/vention-usb-hub_rev01.step

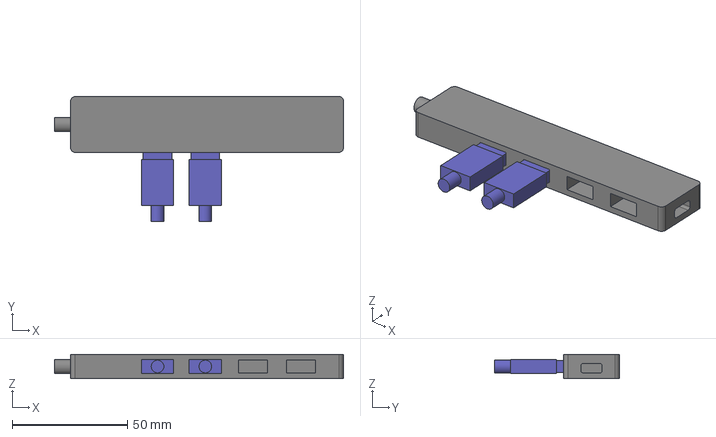
[picture p103: CAD file, 2026-09-19]
hardware-site/docs/files/modules/vention-usb-hub_rev01.step
125.5 x 54.2 x 10.6 mm
Hub
USB Straight x 2
