generalroboticslab/Duke_Humanoid_V2_OpenSource/hardware-site/docs/files/step/CNC_leg13_ankle_pitch_front_rev01.step

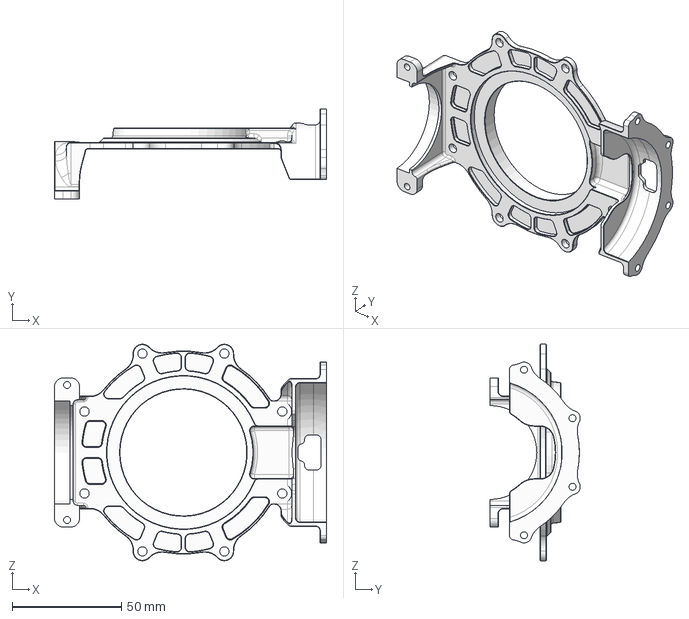
[picture p104: CAD file, 2026-09-19]
hardware-site/docs/files/step/CNC_leg13_ankle_pitch_front_rev01.step
124.5 x 41.4 x 99.1 mm
