generalroboticslab/Duke_Humanoid_V2_OpenSource/hardware-site/docs/files/modules/bearing-50x65x7-6810-6-1kn-52g_rev01.step

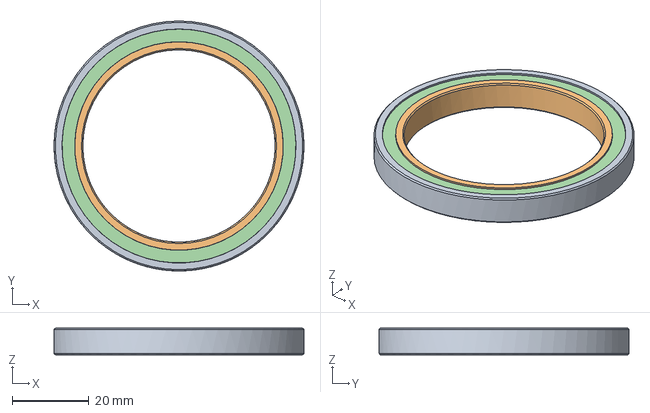
[picture p105: CAD file, 2026-09-19]
hardware-site/docs/files/modules/bearing-50x65x7-6810-6-1kn-52g_rev01.step
65.0 x 65.0 x 7.00 mm
