generalroboticslab/Duke_Humanoid_V2_OpenSource/hardware-site/docs/files/step/3DP_arm11_wrist_roll_rev01.step

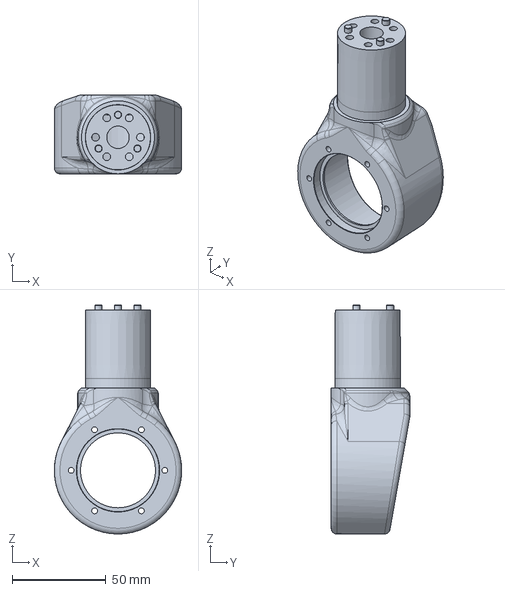
[picture p106: CAD file, 2026-09-19]
hardware-site/docs/files/step/3DP_arm11_wrist_roll_rev01.step
68.0 x 42.0 x 122.3 mm
