generalroboticslab/Duke_Humanoid_V2_OpenSource/hardware-site/docs/files/step/3DP_grip04_apriltag_holder_rev01.step

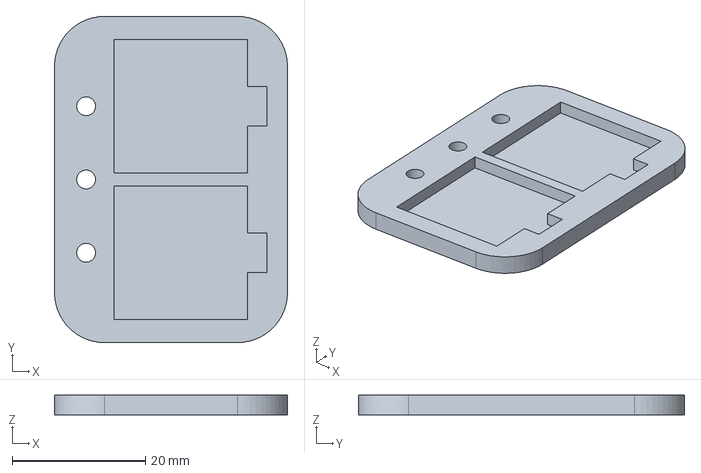
[picture p107: CAD file, 2026-09-19]
hardware-site/docs/files/step/3DP_grip04_apriltag_holder_rev01.step
35.0 x 49.0 x 3.00 mm
