generalroboticslab/Duke_Humanoid_V2_OpenSource/hardware-site/docs/files/modules/twincities-v2-nolock-1_rev01.step

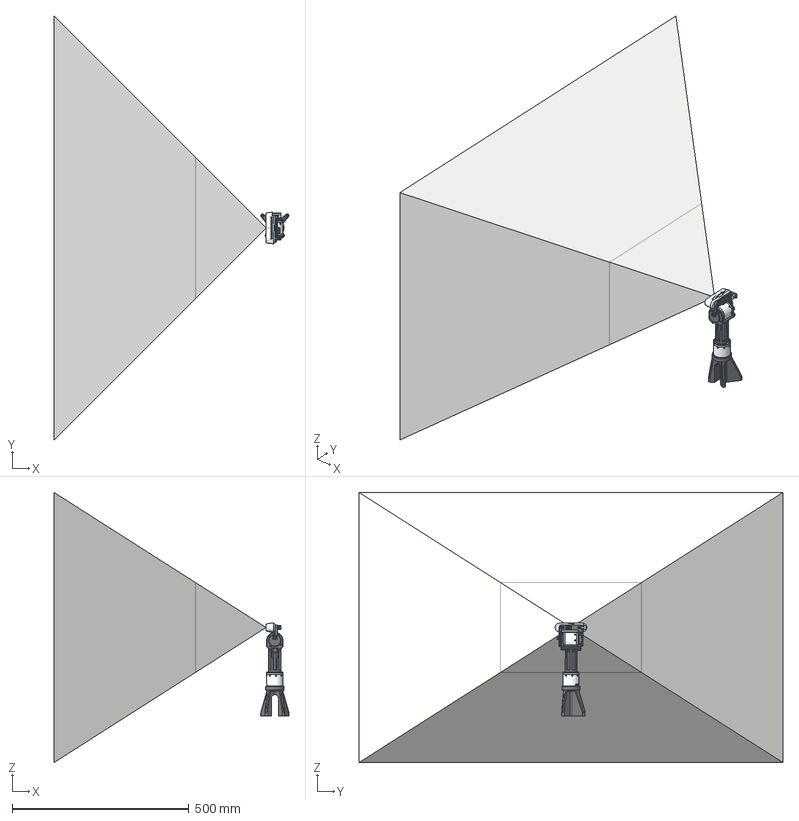
[picture p108: CAD file, 2026-09-19]
hardware-site/docs/files/modules/twincities-v2-nolock-1_rev01.step
665.0 x 1200.0 x 764.5 mm
