generalroboticslab/Duke_Humanoid_V2_OpenSource/hardware-site/docs/files/step/CNC_leg09_knee_motor_back_cover_rev01.step

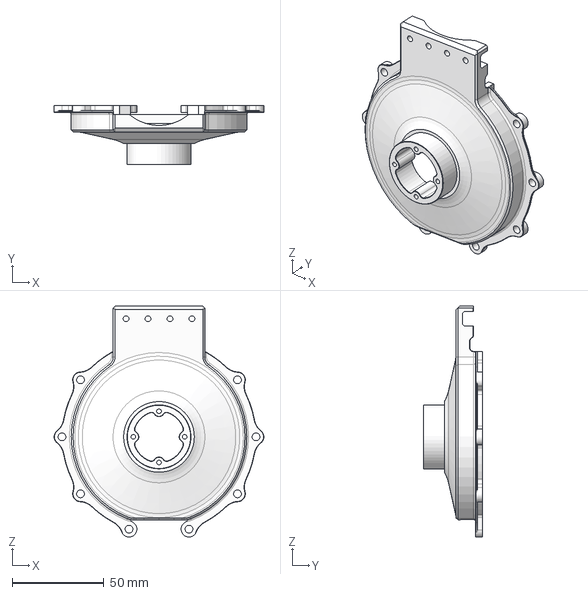
[picture p109: CAD file, 2026-09-19]
hardware-site/docs/files/step/CNC_leg09_knee_motor_back_cover_rev01.step
114.6 x 32.5 x 126.2 mm
