generalroboticslab/Duke_Humanoid_V2_OpenSource/hardware-site/docs/files/modules/bearing-35x44x5-6707-1-6kn-15g-2_rev01.step

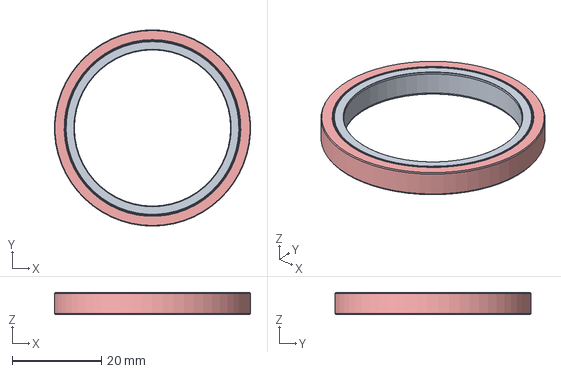
[picture p110: CAD file, 2026-09-19]
hardware-site/docs/files/modules/bearing-35x44x5-6707-1-6kn-15g-2_rev01.step
43.9 x 44.0 x 5.00 mm
