generalroboticslab/Duke_Humanoid_V2_OpenSource/hardware-site/docs/files/step/3DP_body08_back_plate_rev01.step

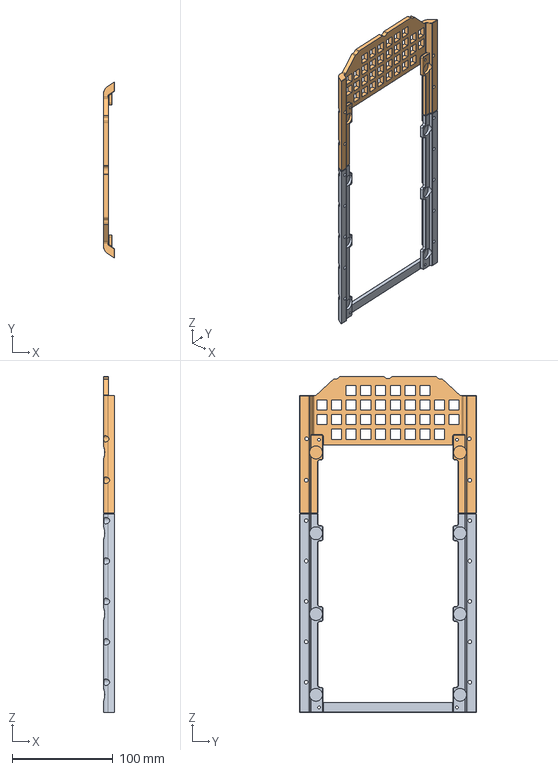
[picture p111: CAD file, 2026-09-19]
hardware-site/docs/files/step/3DP_body08_back_plate_rev01.step
11.3 x 174.8 x 332.7 mm
