generalroboticslab/Duke_Humanoid_V2_OpenSource/hardware-site/docs/files/step/3DP_arm14_wrist_block_rev01.step

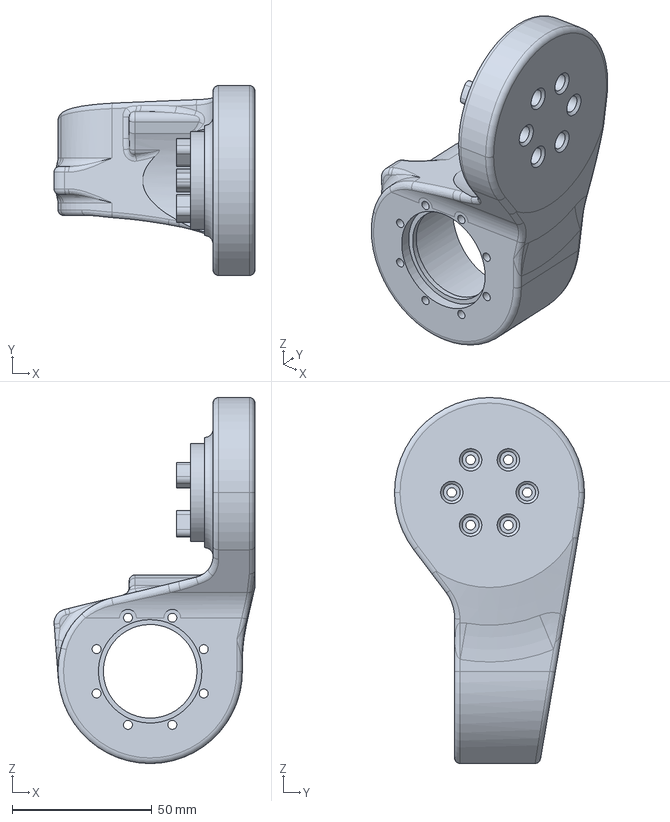
[picture p112: CAD file, 2026-09-19]
hardware-site/docs/files/step/3DP_arm14_wrist_block_rev01.step
71.9 x 68.0 x 131.0 mm
