generalroboticslab/Duke_Humanoid_V2_OpenSource/hardware-site/docs/files/modules/shanks_rev01.step

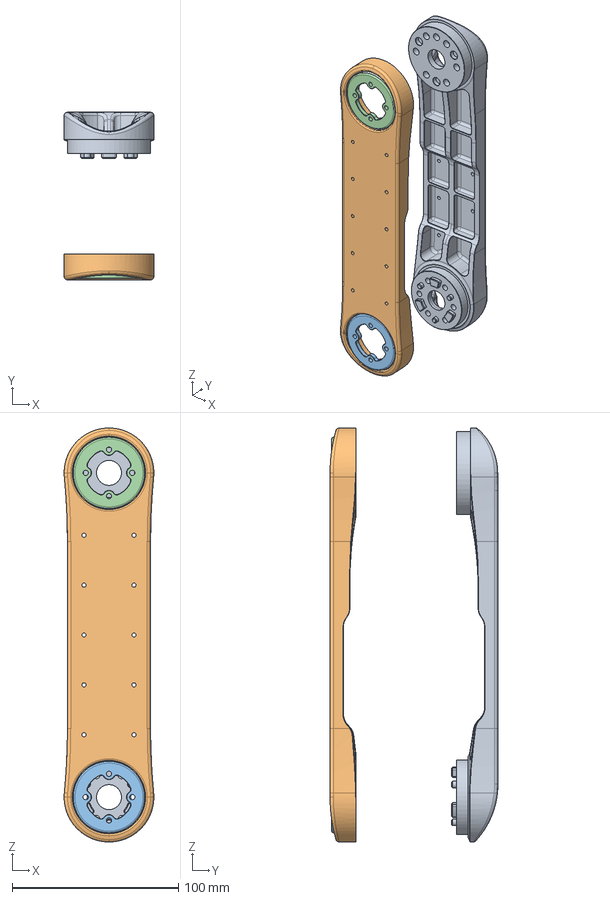
[picture p113: CAD file, 2026-09-19]
hardware-site/docs/files/modules/shanks_rev01.step
54.0 x 101.0 x 249.0 mm
