generalroboticslab/Duke_Humanoid_V2_OpenSource/hardware-site/docs/files/step/3DP_armP04_shoulder_cover_b_rev01.step

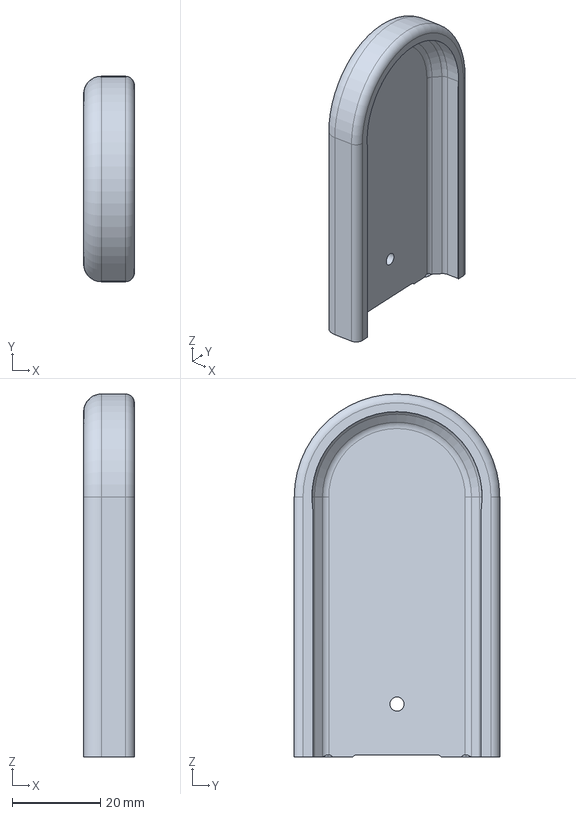
[picture p114: CAD file, 2026-09-19]
hardware-site/docs/files/step/3DP_armP04_shoulder_cover_b_rev01.step
11.5 x 46.6 x 82.3 mm
