generalroboticslab/Duke_Humanoid_V2_OpenSource/hardware-site/docs/files/step/CNC_leg12_lower_leg_bearing_rev01.step

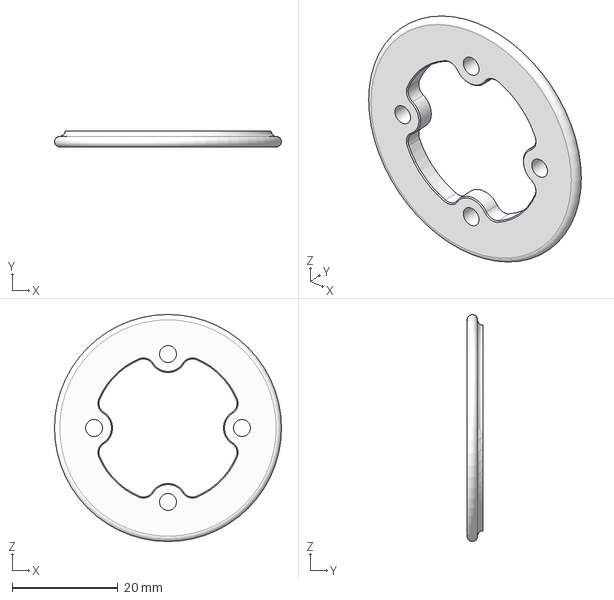
[picture p115: CAD file, 2026-09-19]
hardware-site/docs/files/step/CNC_leg12_lower_leg_bearing_rev01.step
43.0 x 3.00 x 43.0 mm
