generalroboticslab/Duke_Humanoid_V2_OpenSource/hardware-site/docs/files/modules/shoulder-roll-shoulder-yaw_rev01.step

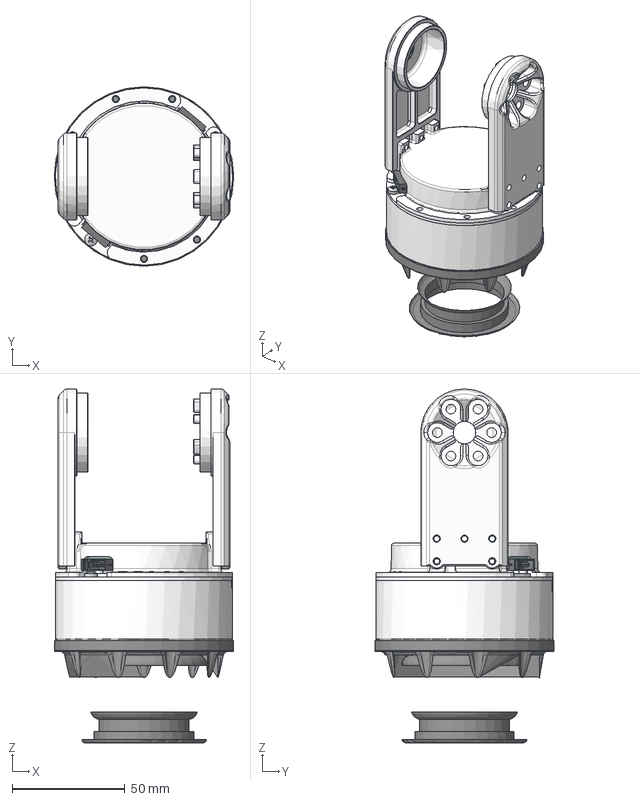
[picture p116: CAD file, 2026-09-19]
hardware-site/docs/files/modules/shoulder-roll-shoulder-yaw_rev01.step
79.5 x 79.5 x 156.8 mm
