generalroboticslab/Duke_Humanoid_V2_OpenSource/hardware-site/docs/files/modules/power-block-casing_rev01.step

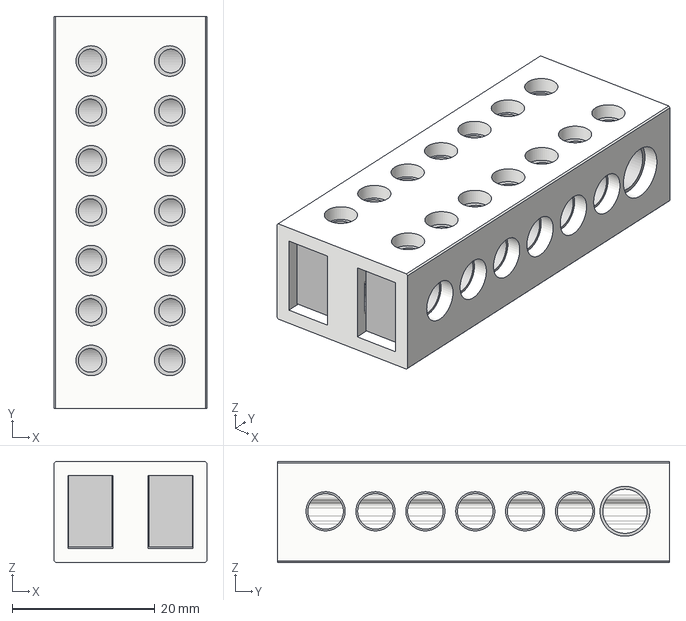
[picture p117: CAD file, 2026-09-19]
hardware-site/docs/files/modules/power-block-casing_rev01.step
21.4 x 55.0 x 14.2 mm
casing
block x 2
