generalroboticslab/Duke_Humanoid_V2_OpenSource/hardware-site/docs/files/step/CNC_leg15_RS06_shaft_bearing_retainer_rev01.step

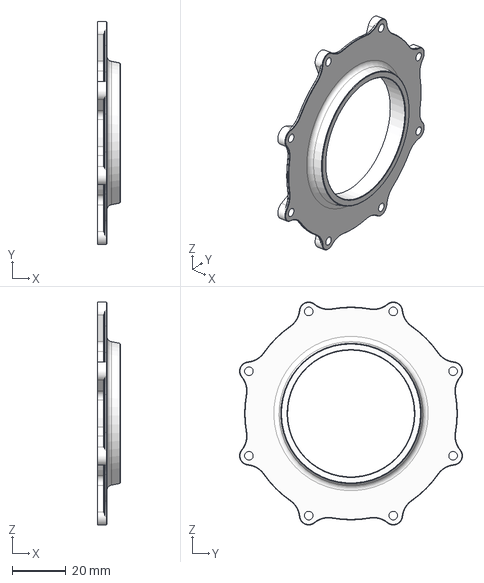
[picture p118: CAD file, 2026-09-19]
hardware-site/docs/files/step/CNC_leg15_RS06_shaft_bearing_retainer_rev01.step
8.50 x 82.8 x 82.8 mm
