generalroboticslab/Duke_Humanoid_V2_OpenSource/hardware-site/docs/files/step/3DP_cam04_gimbal_arm_link_rev01.step

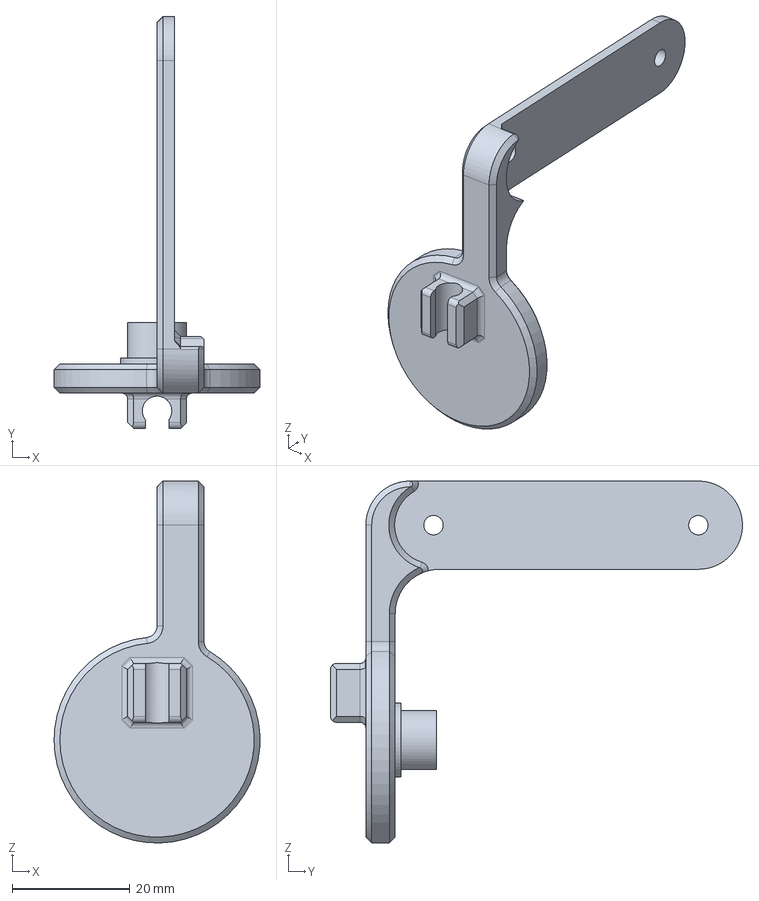
[picture p119: CAD file, 2026-09-19]
hardware-site/docs/files/step/3DP_cam04_gimbal_arm_link_rev01.step
35.0 x 70.0 x 61.5 mm
