generalroboticslab/Duke_Humanoid_V2_OpenSource/hardware-site/docs/files/modules/feetech-hl-3915-servo-motor_rev01.step

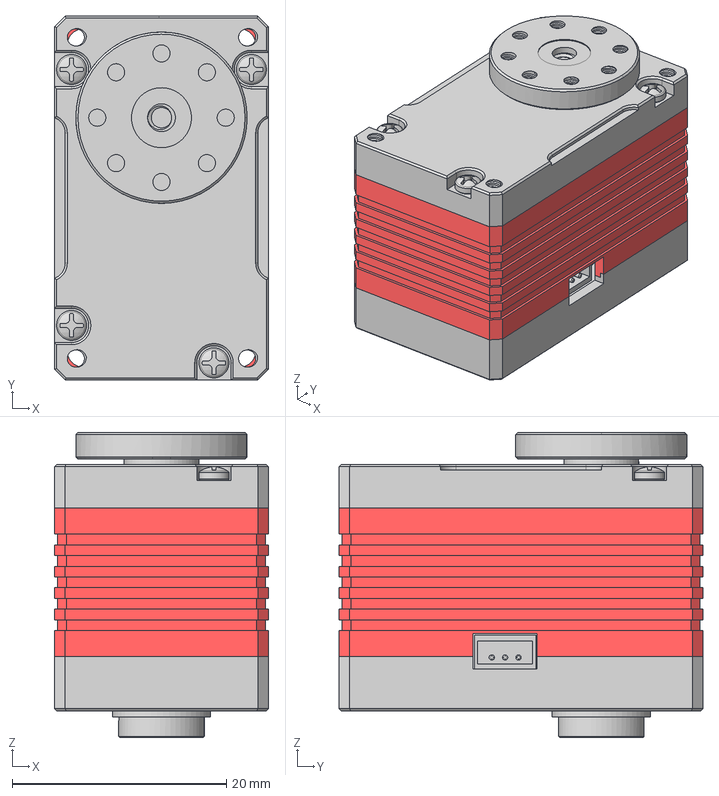
[picture p120: CAD file, 2026-09-19]
hardware-site/docs/files/modules/feetech-hl-3915-servo-motor_rev01.step
20.0 x 34.0 x 28.5 mm
WJ-WK00-0413-MIDDLECASE_80
WJ-WK00-0412-TOPCABINET_74
WJ-WK00-414-BOTTOMCASE_48
PHS_1_7X20_5_DC10_3_3 x 4
OUTPUTGEAR_40
MANIFOLD_SOLID_BREP_102855 x 2
MANIFOLD_SOLID_BREP_102995 x 2
MANIFOLD_SOLID_BREP_103135 x 2
MANIFOLD_SOLID_BREP_103275 x 2
PCBA_1
WJ-BB00-0235_HORN_22
M2-10-6_2 x 2
M2-4LOUSI_1 x 2
MF85ZZ_1
