generalroboticslab/Duke_Humanoid_V2_OpenSource/hardware-site/docs/files/step/CNC_leg17_ankle_roll_support_shaft_rev01.step

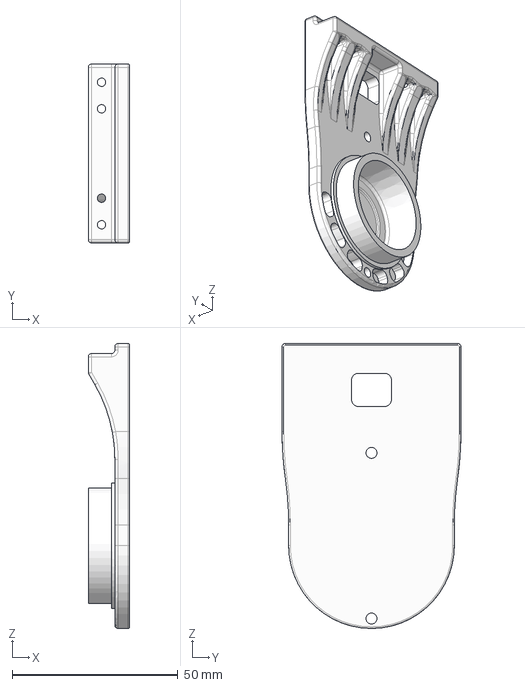
[picture p121: CAD file, 2026-09-19]
hardware-site/docs/files/step/CNC_leg17_ankle_roll_support_shaft_rev01.step
12.5 x 54.0 x 86.0 mm
