generalroboticslab/Duke_Humanoid_V2_OpenSource/hardware-site/docs/files/step/CNC_arm10_r03_back_cover_rev01.step

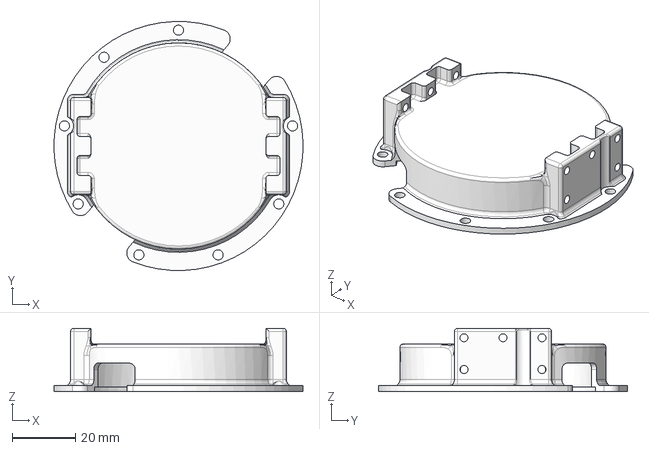
[picture p122: CAD file, 2026-09-19]
hardware-site/docs/files/step/CNC_arm10_r03_back_cover_rev01.step
78.5 x 78.4 x 20.0 mm
