generalroboticslab/Duke_Humanoid_V2_OpenSource/hardware-site/docs/files/modules/ankle-roll-motor-protection_rev01.step

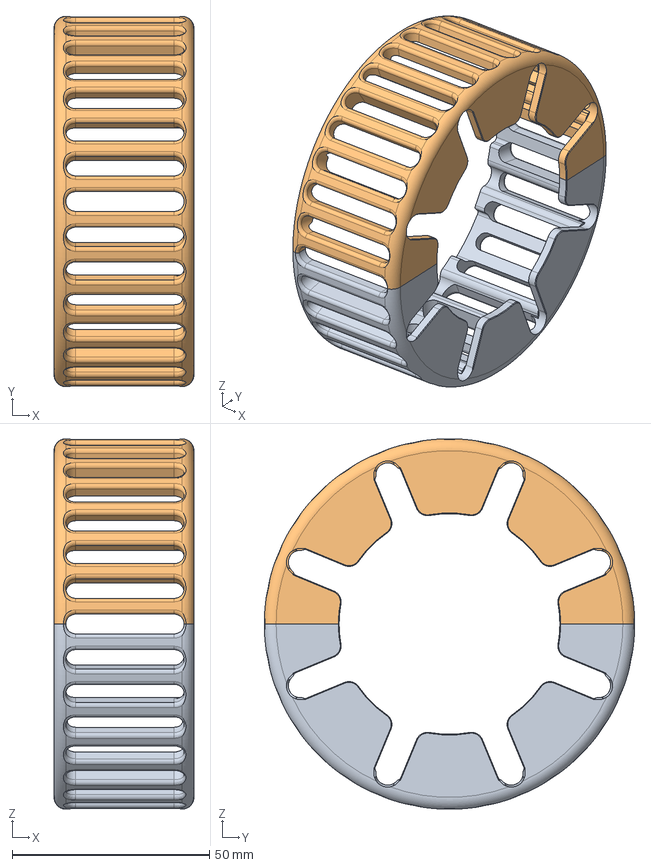
[picture p123: CAD file, 2026-09-19]
hardware-site/docs/files/modules/ankle-roll-motor-protection_rev01.step
35.5 x 93.9 x 93.9 mm
