generalroboticslab/Duke_Humanoid_V2_OpenSource/hardware-site/docs/files/step/CNC_arm09_elbow_output_shaft_rev01.step

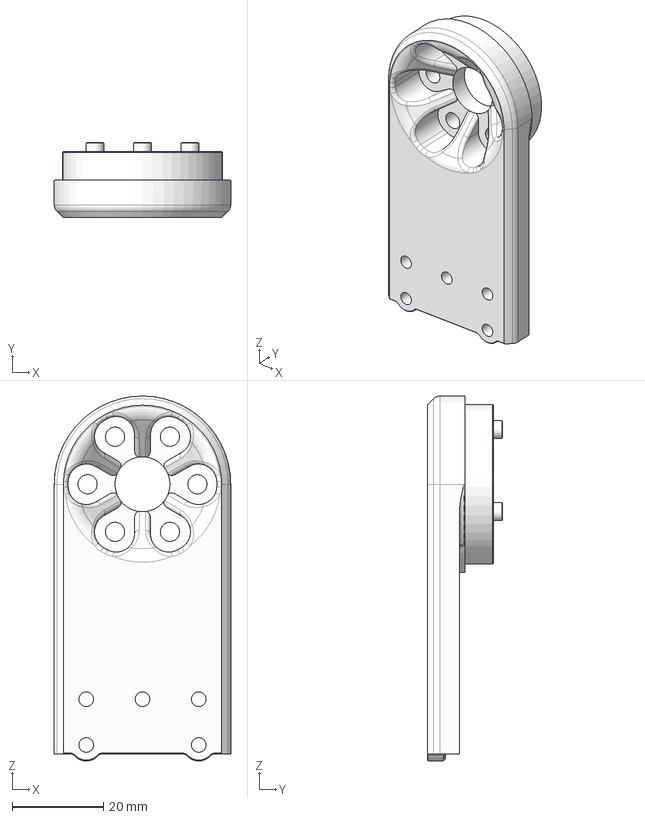
[picture p124: CAD file, 2026-09-19]
hardware-site/docs/files/step/CNC_arm09_elbow_output_shaft_rev01.step
38.6 x 16.5 x 79.8 mm
