generalroboticslab/Duke_Humanoid_V2_OpenSource/hardware-site/docs/files/modules/robstride00_rev01.step

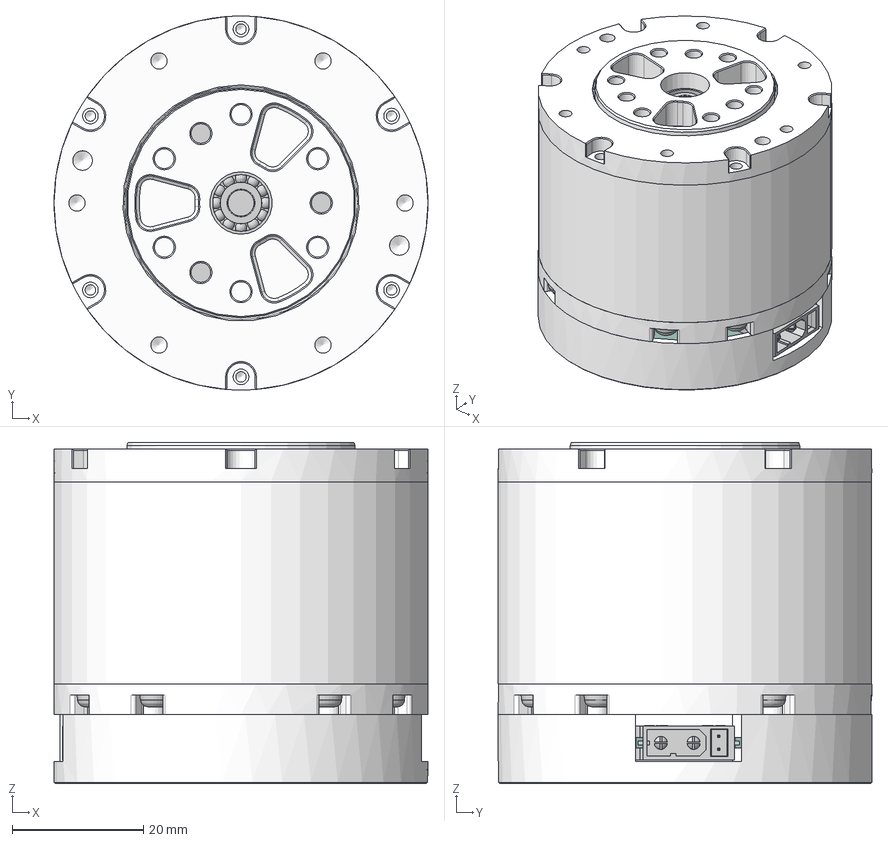
[picture p125: CAD file, 2026-09-19]
hardware-site/docs/files/modules/robstride00_rev01.step
57.0 x 57.0 x 52.0 mm
1_21_121000022__SGQZC619-4_4-.stp
SGQZC__35.stp
SOLID-17_CON_P4_11_438X3_2_HD_2.stp
SOLID-17_CON_P4_11_438X3_2_HD_3.stp
BOARD_3D_KMMV03_2024-10-21_2__2.stp
1_1_06_EB573-643.stp
1_1_04_EB572-5105.stp
1_2_04_000306.stp
1_1_02_EB571-960.stp
1_2_05_020068.stp x 7
1_1_14_PL574-570.stp
1_2_05_025121.stp x 4
1_2_05_000314.stp
1_1_06_EB573-642.stp
CORE
SCXXKL.stp
