generalroboticslab/Duke_Humanoid_V2_OpenSource/hardware-site/docs/files/step/3DP_legP05_hip2_cover_a_rev01.step

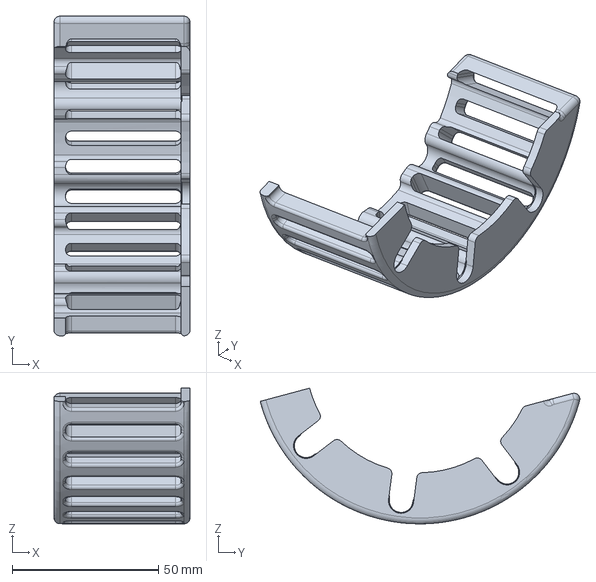
[picture p126: CAD file, 2026-09-19]
hardware-site/docs/files/step/3DP_legP05_hip2_cover_a_rev01.step
46.5 x 109.3 x 46.4 mm
