generalroboticslab/Duke_Humanoid_V2_OpenSource/hardware-site/docs/files/step/CNC_leg10_knee_output_shank_rev01.step

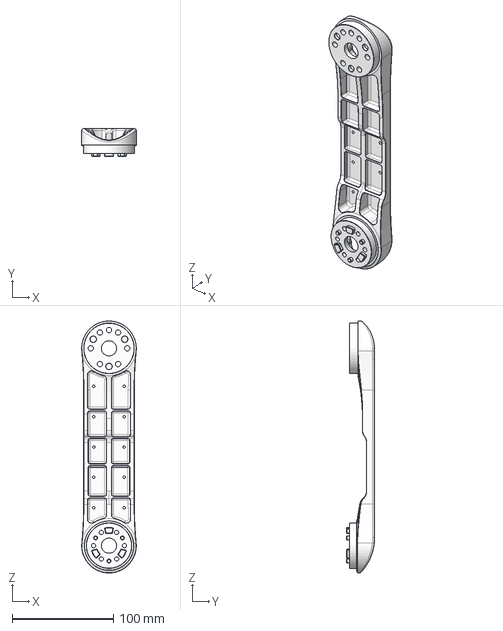
[picture p127: CAD file, 2026-09-19]
hardware-site/docs/files/step/CNC_leg10_knee_output_shank_rev01.step
54.0 x 27.8 x 249.0 mm
