generalroboticslab/Duke_Humanoid_V2_OpenSource/hardware-site/docs/files/step/CNC_arm02_shoulder_roll_back_bearing_rev01.step

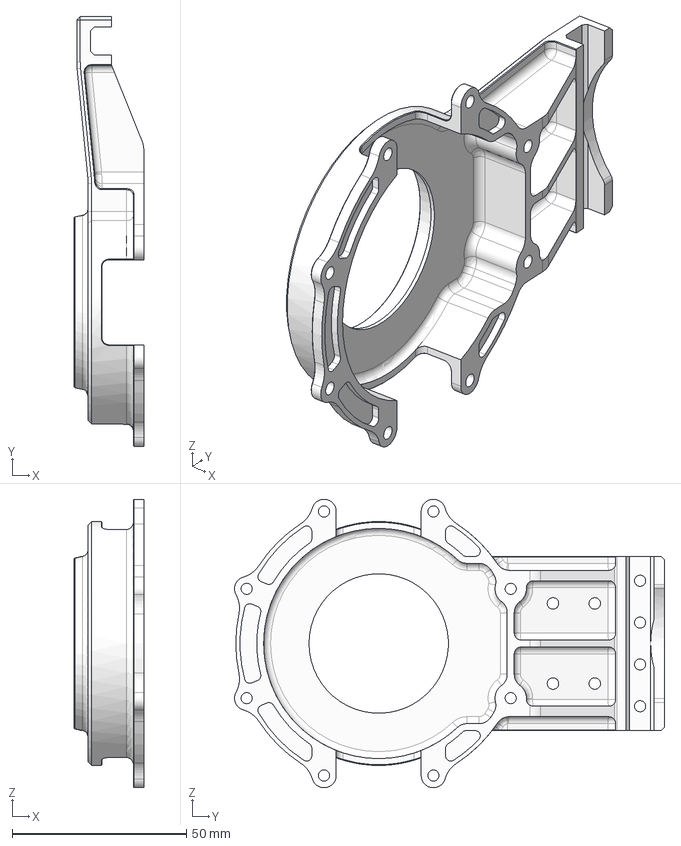
[picture p128: CAD file, 2026-09-19]
hardware-site/docs/files/step/CNC_arm02_shoulder_roll_back_bearing_rev01.step
20.0 x 123.4 x 82.8 mm
