generalroboticslab/Duke_Humanoid_V2_OpenSource/hardware-site/docs/files/step/3DP_cam02_gimbal_neck_rev01.step

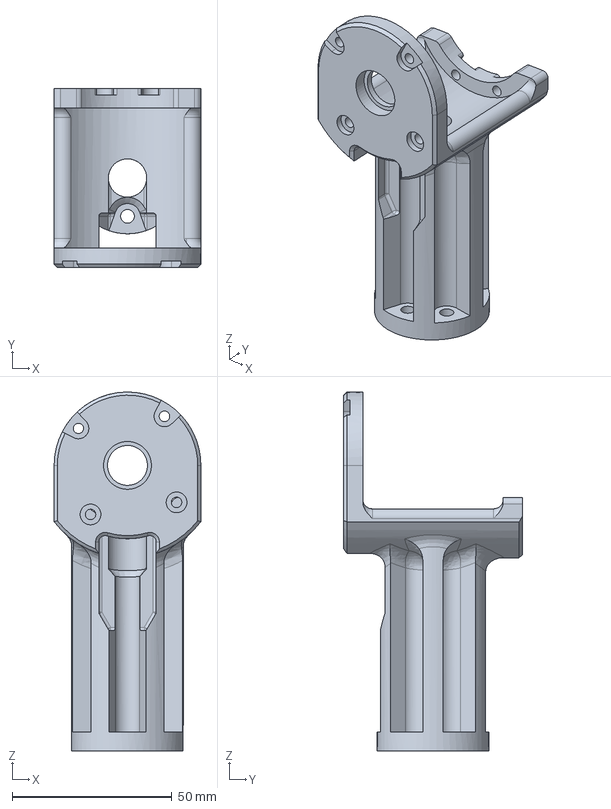
[picture p130: CAD file, 2026-09-19]
hardware-site/docs/files/step/3DP_cam02_gimbal_neck_rev01.step
46.0 x 56.0 x 112.5 mm
