generalroboticslab/Duke_Humanoid_V2_OpenSource/hardware-site/docs/files/step/CNC_body04_front_plate_rev01.step

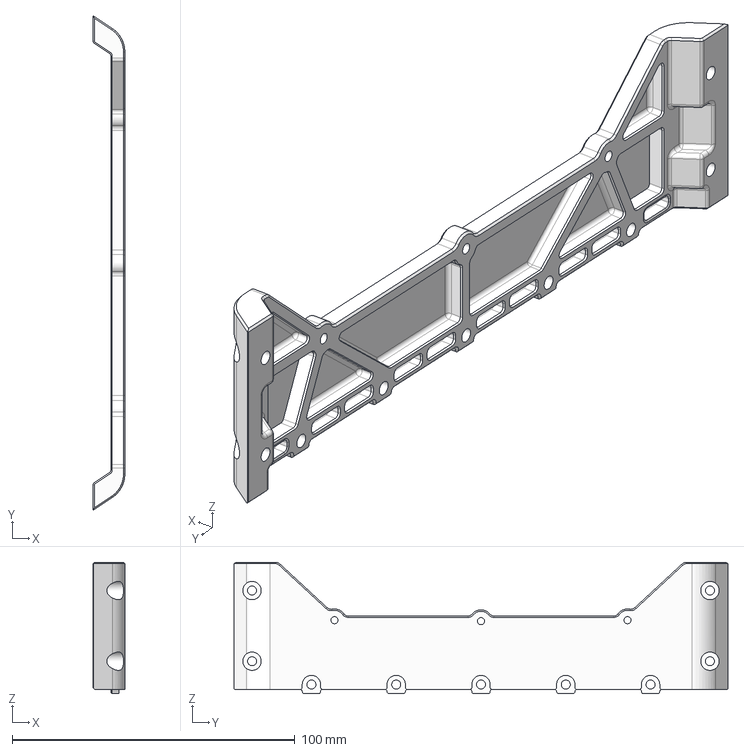
[picture p131: CAD file, 2026-09-19]
hardware-site/docs/files/step/CNC_body04_front_plate_rev01.step
11.3 x 174.8 x 46.5 mm
