generalroboticslab/Duke_Humanoid_V2_OpenSource/hardware-site/docs/files/step/CNC_arm07_elbow_front_bearing_rev01.step

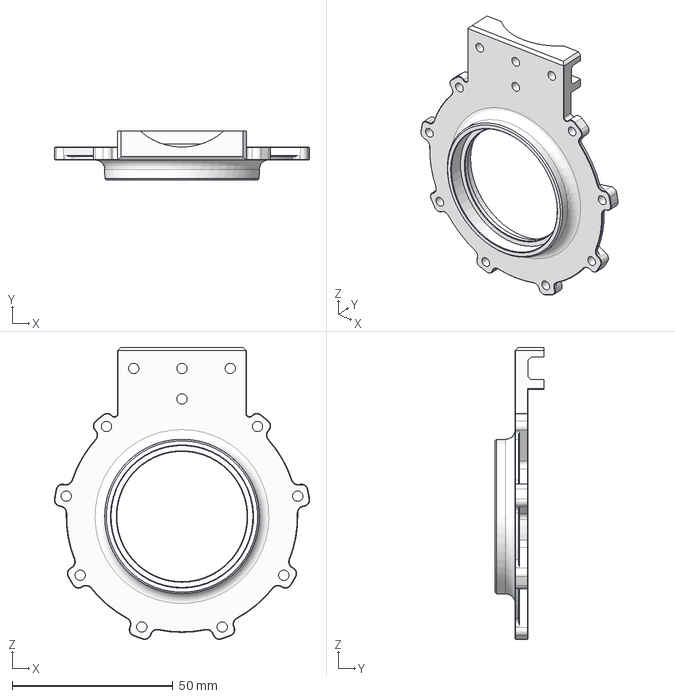
[picture p132: CAD file, 2026-09-19]
hardware-site/docs/files/step/CNC_arm07_elbow_front_bearing_rev01.step
79.3 x 15.3 x 90.7 mm
