generalroboticslab/Duke_Humanoid_V2_OpenSource/(list of files, cad)

Other CAD files:
hardware-site/docs/files/modules/double-helix-rack-30teeth-6mm_rev01.step
hardware-site/docs/files/step/3DP_legP03_hip3_cover_c_rev01.step
hardware-site/docs/files/step/3DP_legP01_hip3_cover_a_rev01.step
hardware-site/docs/files/modules/shoulder-pitch-shoulder-roll-2_rev01.step
hardware-site/docs/files/modules/3dp-body-09-x1-back-plate-removable_rev01.step
hardware-site/docs/files/modules/robstride05-v16-1-1_rev01.step
hardware-site/docs/files/modules/3dp-body-07-x1-front-plate-removable_rev01.step
hardware-site/docs/files/modules/intelrealsense-d435-multibody_rev01.step
hardware-site/docs/files/step/3DP_legP08_knee_cover_b_rev01.step
hardware-site/docs/files/modules/robstride-02-no-back-cover_rev01.step
hardware-site/docs/files/modules/elbow-motor-protection-2_rev01.step
hardware-site/docs/files/step/3DP_grip01_base_rev01.step
hardware-site/docs/files/step/3DP_legP04_hip3_cover_d_rev01.step
hardware-site/docs/files/step/3DP_cam03_gimbal_arm_rev01.step
hardware-site/docs/files/modules/shoulder-yaw-elbow-2_rev01.step
hardware-site/docs/files/step/CNC_leg18_foot_plate_rev01.step
hardware-site/docs/files/modules/hip-roll-hip-yaw-r_rev01.step
hardware-site/docs/files/modules/robstride05-v16-2-1_rev01.step
hardware-site/docs/files/step/3DP_armP02_elbow_cover_b_rev01.step
hardware-site/docs/files/modules/hip-pitch-motor-mirror_rev01.step
hardware-site/docs/files/modules/ankle-roll-structural-part-protection_rev01.step
hardware-site/docs/files/modules/shoulder-yaw-protection-2_rev01.step
hardware-site/docs/files/step/3DP_armP03_shoulder_cover_a_rev01.step
hardware-site/docs/files/modules/shoulder-roll-shoulder-yaw-2_rev01.step
hardware-site/docs/files/step/3DP_legP09_shank_cover_a_rev01.step
hardware-site/docs/files/step/3DP_armP06_shoulder_cover_d_rev01.step
hardware-site/docs/files/modules/twincities-v2-nolock_rev01.step
hardware-site/docs/files/step/3DP_grip05_pinion_rev01.step
hardware-site/docs/files/modules/3dp-arm06-x4-rs02-shaft-coupler-2_rev01.step
hardware-site/docs/files/step/3DP_legP12_ankle_cover_b_rev01.step
hardware-site/docs/files/modules/elbow-wrist-roll_rev01.step
hardware-site/docs/files/step/3DP_body05_interior_plate_rev01.step
hardware-site/docs/files/modules/shoulder-yaw-protection_rev01.step
hardware-site/docs/files/modules/shoulder-roll-shaft-2_rev01.step
hardware-site/docs/files/modules/001-left-wrist-long-latest_rev01.step
hardware-site/docs/files/step/3DP_armP07_shoulder_cover_e_rev01.step
hardware-site/docs/files/modules/hip-pitch-hip-roll-r_rev01.step
hardware-site/docs/files/modules/robstride05-v16-2_rev01.step
hardware-site/docs/files/modules/shoulder-pitch-protection_rev01.step
hardware-site/docs/files/step/3DP_armP10_shoulder_yaw_cover_b_rev01.step
hardware-site/docs/files/modules/gimbal-arm-1_rev01.step
hardware-site/docs/files/modules/elbow-shaft_rev01.step
hardware-site/docs/files/modules/elbow-shaft-2_rev01.step
hardware-site/docs/files/step/3DP_arm06_RS02_shaft_coupler_rev01.step
hardware-site/docs/files/print/3DP_arm05_RS02_shaft_bearing_retainer_rev01.stl
hardware-site/docs/files/print/3DP_arm06_RS02_shaft_coupler_rev01.stl
hardware-site/docs/files/print/3DP_arm11_wrist_roll_rev01.stl
hardware-site/docs/files/print/3DP_arm14_wrist_block_rev01.stl
hardware-site/docs/files/print/3DP_arm15_end_effector_attachment_rev01.stl
hardware-site/docs/files/print/3DP_armP01_elbow_cover_a_rev01.stl
hardware-site/docs/files/print/3DP_armP02_elbow_cover_b_rev01.stl
hardware-site/docs/files/print/3DP_armP03_shoulder_cover_a_rev01.stl
hardware-site/docs/files/print/3DP_armP04_shoulder_cover_b_rev01.stl
hardware-site/docs/files/print/3DP_armP05_shoulder_cover_c_rev01.stl
hardware-site/docs/files/print/3DP_armP06_shoulder_cover_d_rev01.stl
hardware-site/docs/files/print/3DP_armP07_shoulder_cover_e_rev01.stl
hardware-site/docs/files/print/3DP_armP08_shoulder_cover_f_rev01.stl
hardware-site/docs/files/print/3DP_armP09_shoulder_yaw_cover_a_rev01.stl
hardware-site/docs/files/print/3DP_armP10_shoulder_yaw_cover_b_rev01.stl
hardware-site/docs/files/print/3DP_armP11_shoulder_yaw_cover_c_rev01.stl
hardware-site/docs/files/print/3DP_body05_interior_plate_rev01.stl
hardware-site/docs/files/print/3DP_body06_front_plate_rev01.stl
hardware-site/docs/files/print/3DP_body07_front_plate_removable_rev01.stl
hardware-site/docs/files/print/3DP_body08_back_plate_rev01.stl
hardware-site/docs/files/print/3DP_body09_back_plate_removable_rev01.stl
hardware-site/docs/files/print/3DP_cam01_gimbal_mount_rev01.stl
hardware-site/docs/files/print/3DP_cam02_gimbal_neck_rev01.stl
hardware-site/docs/files/print/3DP_cam03_gimbal_arm_rev01.stl
hardware-site/docs/files/print/3DP_cam04_gimbal_arm_link_rev01.stl
hardware-site/docs/files/print/3DP_grip01_base_rev01.stl
hardware-site/docs/files/print/3DP_grip02_finger_rev01.stl
hardware-site/docs/files/print/3DP_grip03_rail_rev01.stl
hardware-site/docs/files/print/3DP_grip04_apriltag_holder_rev01.stl
hardware-site/docs/files/print/3DP_grip05_pinion_rev01.stl
hardware-site/docs/files/print/3DP_grip06_apriltag_tile_rev01.stl
hardware-site/docs/files/print/3DP_leg19_sole_rev01.stl
hardware-site/docs/files/print/3DP_leg20_foot_front_rev01.stl
hardware-site/docs/files/print/3DP_legP01_hip3_cover_a_rev01.stl
hardware-site/docs/files/print/3DP_legP02_hip3_cover_b_rev01.stl
hardware-site/docs/files/print/3DP_legP03_hip3_cover_c_rev01.stl
hardware-site/docs/files/print/3DP_legP04_hip3_cover_d_rev01.stl
hardware-site/docs/files/print/3DP_legP05_hip2_cover_a_rev01.stl
hardware-site/docs/files/print/3DP_legP06_hip2_cover_b_rev01.stl
hardware-site/docs/files/print/3DP_legP07_knee_cover_a_rev01.stl
hardware-site/docs/files/print/3DP_legP08_knee_cover_b_rev01.stl
hardware-site/docs/files/print/3DP_legP09_shank_cover_a_rev01.stl
hardware-site/docs/files/print/3DP_legP10_shank_cover_b_rev01.stl
hardware-site/docs/files/print/3DP_legP11_ankle_cover_a_rev01.stl
hardware-site/docs/files/print/3DP_legP12_ankle_cover_b_rev01.stl
