generalroboticslab/Duke_Humanoid_V2_OpenSource/hardware-site/docs/fabrication/printing-guide.md

# Printing guide

| Process | Parts | Material |
| --- | --- | --- |
| FDM | 40 covers, mounts, plates and pads | PLA; TPU for the pads and covers |
| SLS | The drivetrain parts below — each transmits actuator torque or carries a bearing | Nylon 12 |

| SLS part | Qty |
| --- | ---: |
| `3DP_arm05_RS02_shaft_bearing_retainer` | 4 |
| `3DP_arm06_RS02_shaft_coupler` | 2 |
| `3DP_arm11_wrist_roll` | 2 |
| `3DP_arm14_wrist_block` | 2 |
| `3DP_arm15_end_effector_attachment` | 2 |
| `3DP_grip05_pinion` | 2 |

Process and material per part: [Printed parts](../bom/index.md#printed-parts). Files: [CAD downloads](#cad-downloads).

FDM holes print undersize: ream them to size. Set heat-set inserts with a soldering iron.
