generalroboticslab/Duke_Humanoid_V2_OpenSource/hardware-site/docs/fabrication/cnc-guide.md

# CNC guide

Order the machined parts from the STEP files; there are no per-part drawings.

| | |
| --- | --- |
| Material | Aluminium 6061 |
| Tolerance | 0.03 mm on radius and length, 0.06 mm on diameter |
