generalroboticslab/Duke_Humanoid_V2_OpenSource/hardware-site/docs/fabrication/index.md

# Fabrication

Turn the CAD into parts: download the files, order the machined parts, print the rest.

| | |
| --- | --- |
| Machining | {{ bom_count("cnc-parts.csv") }} parts in aluminium 6061, ordered from the STEP files |
| Printing | FDM in PLA and TPU; six SLS nylon 12 drivetrain parts from a print service |

{% include "fabrication/cad-downloads.md" %}

{% include "fabrication/cnc-guide.md" %}

{% include "fabrication/printing-guide.md" %}
