generalroboticslab/Duke_Humanoid_V2_OpenSource/hardware-site/docs/assets/exploded/hip-assembly-poster.webp

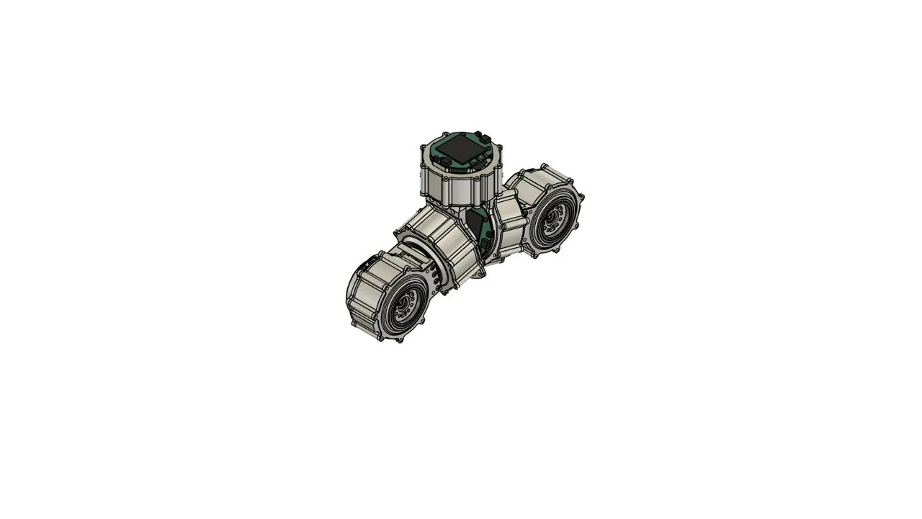
hardware-site/docs/assets/exploded/hip-assembly-poster.webp
