generalroboticslab/Duke_Humanoid_V2_OpenSource/(commit log)

2026-09-19 Hardware release site: MkDocs Material scaffold, BOM data, wiring, exploded views, CAD download mechanism
    - hardware-site/: 50-page build-only site (buy/make/assemble/wire/bring-up/verify/safety),
    every gap marked as a red MISSING/UNVERIFIED box with an owner; strict build clean
    - tools/: generators for BOM CSVs, punch list, image manifest, CAD file index (with GitHub size guards)
    - hardware/: team power and data wiring diagrams
    - reference/bom, reference/_meta/cad-trees: BOM spreadsheets and CAD-release evidence
    - _archive/: pre-slim verbose site kept for fact recovery
    - V2_RELEASE_PLAYBOOK.md, CAD_RELEASE_COMPARISON.md: analyses for the team
    - CLAUDE.md, HANDOFF.md: working rules and cur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
    [actuators.csv, berkeley-humanoid-lite-bom-sheet-5010-actuator.csv, berkeley-humanoid-lite-bom-sheet-M6C12-actuator.csv, berkeley-humanoid-lite-bom-sheet-humanoid.csv, bom-reconciliation.csv, cables-connectors.csv, cad-files.csv, cnc-parts.csv]
2026-09-19 Publish first CAD release files, close sourced punch-list gaps, Windows tooling
    CAD: 31 per-part STEP (AP214, Fusion 2705.1.15), 2 SLS STL, whole-robot STEP
    (zipped, 194 MB raw) exported from humanoid_2.1_latest via the new
    tools/fusion_export script and staged by tools/stage_cad_export.py under the
    site's part_ids. tree.csv records all 629 components with material and mass.
    Site: 18 pages edited from the code repo, BOM and wiring sources; 7 gaps
    closed, 26 narrowed, every edit independently re-verified. Punch list
    179 -> 171 open, 54 -> 53 blocking. Home-page CAD blocker reworded.
    Tools: generators write LF and POSIX paths on Windows; punch list ignores
    blocks in Jinja branches that do no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
    [CNC_arm01_shoulder_roll_front_bearing_rev01.step, CNC_arm02_shoulder_roll_back_bearing_rev01.step, CNC_arm03_shoulder_roll_output_shaft_rev01.step, CNC_arm04_shoulder_roll_support_shaft_rev01.step, CNC_arm05_RS02_shaft_bearing_rev01.step, CNC_arm05_RS02_shaft_bearing_rev01.stl, CNC_arm07_elbow_front_bearing_rev01.step, CNC_arm08_elbow_back_bearing_rev01.step]
2026-09-19 CAD downloads: link the .f3z release asset (cad-v2.1-rc1), record its checksum
2026-09-19 HANDOFF: CAD status after the first export
2026-09-19 Overall drawing PDF, aluminium grade from Fusion, order-from-STEP wording
    [cad-files.csv]
2026-09-19 Printed parts from the Fusion tree: 27 parts with STEP+STL, CNC naming reconciled
    gen_printed.py derives printed-parts.csv from cad/*/tree.csv (3DP_ parts and
    the *_protection covers); stage_cad_export.py names their files and skips
    anything over GitHub's limit. CNC page: IDs checked against Fusion, three
    quoted parts flagged as absent from the model, arm05/arm11 flagged as SLS.
    [3DP_arm05_RS02_shaft_bearing_retainer_rev01.step, 3DP_arm05_RS02_shaft_bearing_retainer_rev01.stl, 3DP_arm11_wrist_roll_rev01.step, 3DP_arm11_wrist_roll_rev01.stl, 3DP_arm14_wrist_block_rev01.step, 3DP_arm14_wrist_block_rev01.stl, 3DP_armP01_elbow_cover_a_rev01.step, 3DP_armP01_elbow_cover_a_rev01.stl]
2026-09-19 HANDOFF: CAD naming status
2026-09-19 Three-level CAD downloads and a Fusion-coloured interactive viewer
    Whole robot / modules / parts are all downloadable: 80 module STEP files,
    76 site parts (STEP + STL for printed), 125 vendor part STEP files, the
    overall drawing and the zipped whole-robot STEP (328 files, 667 MB, none
    over GitHub's limit). Fusion appearance colours, mass, centre of mass,
    inertia, joints and world transforms are exported by tools/fusion_export*
    and drive the site: part-properties.csv, joints.csv, modules.csv,
    vendor-parts.csv.
    Viewer: docs/assets/viewer/robot.glb (2.2 MB, Draco) is the whole model in
    its Fusion colours with an XYZ triad; every part, vendor part and module
    is clickable both ways (Preview / Do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
    [001-left-wrist-long-latest_rev01.step, 001-right-wrist-long-latest_rev01.step, 3DP_arm05_RS02_shaft_bearing_retainer_rev01.step, 3DP_arm05_RS02_shaft_bearing_retainer_rev01.stl, 3DP_arm06_RS02_shaft_coupler_rev01.step, 3DP_arm06_RS02_shaft_coupler_rev01.stl, 3DP_arm11_wrist_roll_rev01.step, 3DP_arm11_wrist_roll_rev01.stl]
2026-09-19 fusion_export_missing: re-export the components whose STL failed (long paths)
2026-09-19 Viewer: one robot colour except the cameras; site palette in Duke blue; re-exported components
    [cad-files.csv]
2026-09-19 Viewer: black-grey robot, actuators and cameras in Fusion colours; General Robotics Lab logo as site logo and favicon
2026-09-19 Viewer: purchased components keep Fusion colours, own parts black-grey; cameras exported as occurrences; more detail on actuators
2026-09-20 Add the team's WIP BOM spreadsheet (2026-09-19) to reference/bom; viewer.js constant cleanup
    [Duke_Humanoid_V2_BOM_WIP.xlsx]
2026-09-20 BOM source switched to the team's spreadsheet: gen_bom.py maps its 100 lines to the CAD part IDs, unpriced rows render TODO, team_ref on every table; old two-sheet generators retired
    [actuators.csv, bom-reconciliation.csv, cables-connectors.csv, cnc-parts.csv, electronics.csv, fasteners.csv, printed-parts.csv, test-fixtures.csv]
2026-09-20 Team exploded-view booklet published as the assembly figures; every team BOM line cross-checked against the CAD with team-map.csv; team ids first in tables and the viewer; HANDOFF refreshed
    [actuators.csv, cad-files.csv, cnc-parts.csv, printed-parts.csv, team-map.csv]
2026-09-20 gen_cad_manifest: sort files case-insensitively so macOS and Windows produce identical cad-files.csv / SHA256SUMS.txt; regenerate
2026-09-20 Site prose: drop tooling and spreadsheet provenance commentary from builder-facing pages (script names, file paths, export dates); keep the team-BOM source in one line per table
2026-09-21 Recalibrate punch list: gate by declaration, demote model-answered gaps
    The CAD is published (76 part STEPs, 45 STLs, 329 manifest rows); the model is
    the reference, the team's spreadsheet is a working document; joint direction is
    "every positive axis points from the motor output shaft towards the back of
    the motor." gen_punchlist.py now gates release only when a block's owner line
    declares "Blocks release." HANDOFF.md absorbs V2_RELEASE_PLAYBOOK.md (deleted).
    mkdocs build --strict: 0 warnings. 27 open / 9 blocking.
2026-09-21 Close 13 more punch-list items from the published CAD and the deploy repo
    Measured against the released STEP files instead of restating the open
    question:
    - FDM vs SLS is in printed-parts.csv already: 40 FDM, 7 SLS, and the seven
    are the drivetrain parts. Listed on the printing guide.
    - The shank covers are not duplicates of the shoulder covers. They are
    261 x 66 x 25 mm against 82 x 47 x 11 mm; the shared Fusion component
    names misled the earlier note.
    - The M4/M5 CAD error is still in the release. Of 23 machined parts with
    screw holes, only CNC_leg10_knee_output_shank carries M5 clearance.
    Documented with the fix (open to 5.3 mm at the machinist).
    - Four RS06 are needed, not the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
    [joints.csv, vendor-parts.csv]
2026-09-21 Licence Apache-2.0 across the board; e-stop layers = software failsafes
    - citation-and-license: code, hardware design files and the documentation all
    Apache-2.0; umbrella V1 was MIT, this release is not
    - docs/files/LICENSE: ship the umbrella's Apache-2.0 file next to the CAD,
    listed in cad-files.csv as a release artefact
    - gen_cad_manifest: pick up top-level LICENSE/NOTICE/RELEASE_NOTES files into
    the manifest; SHA256SUMS.txt now includes them
    - cad-downloads.md: link the LICENSE file and point to the licence page
    The deployed robot's first stop is software, not hardware. Three layers, in
    order, replace the physical e-stop row:
    1. Stream silence: nav 1 s, arm 0.5 s, gaze 2 s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
    [cad-files.csv]
2026-09-21 Flatten the site: one page per section, subpages become sections of it
    The nav was two levels deep: a section, then five or six pages inside it. A
    builder reading Electrical had to open Power system, CAN bus, Harness
    fabrication, Routing and Pre-power checks one at a time, and lost the thread
    between them. Each section is now a single page, and what used to be its
    subpages are the headings on that page.
    Nothing was merged by hand. Each `<section>/index.md` ends with a list of
    `{% include "<section>/<page>.md" %}` lines in build order, so the files stay
    exactly where they were and keep their own history; `exclude_docs` stops MkDocs
    building them a second time as pages of their own. The inclu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
2026-09-21 Fix every asset path the flatten left one level too deep
    Flattening each section into one page moved every included file up a URL level:
    `assembly/leg/` became `assembly/`. MkDocs rewrote the Markdown links, but it
    never looks inside raw HTML, so all of it kept pointing at `../../assets/…` and
    404'd without a single build warning.
    Broken, and now fixed:
    - the 3D part viewer on Fabrication — `<model-viewer src>` and the `data-base`
    the script builds its `parts.json` / `downloads.json` / `vendor-map.json`
    fetches and its download links from;
    - 14 `<video>`, `<source>` and `poster=` references to the exploded-view clips
    across Assembly and Bring-up.
    Two more that the new checker ca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
    [check_links.py, gen_punchlist.py]
2026-09-21 Drop the "Mount the computer" step; finish removing the physical e-stop
    The computer step carried a photo of printed T-brackets that no longer match
    the robot. The two exploded views already above it — the front-bay video and
    the team's labelled electronics view, where the computer is E0 — place the mini
    PC on the spine, so the step said nothing the figures did not. It is now two
    sentences under those figures: where it sits, and that it has to be retained
    with its vents and ports clear. Torso steps 6-10 renumber to 5-9; nothing
    linked to them.
    Removing the physical e-stop (e98a9c5) had left ten places still telling a
    builder to hold one:
    - Torso step 9 was "Fit the disconnect and emerg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
    [gen_image_manifest.py]
2026-09-21 Drop two TODO markers from the Go / no-go list
    Neither belonged on a checklist. A go/no-go item is something a builder ticks
    about their own shop; these two were statements about the release, repeated
    from the pages that already carry them in full.
    "No tolerances published" was also wrong: the CNC guide publishes a general
    tolerance of 0.03 mm on radius and length and 0.06 mm on diameter, marked
    UNVERIFIED because the drawing does not say whether that is a ± or a total
    band. What is genuinely absent — per-part drawings, tolerances and finishes —
    is stated on What you get, with the detail this line did not have.
    The unpriced-rows item keeps the check and the link to the BOM; which rows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
2026-09-21 Drop the Go / no-go list; correct three stale rows on What you get
    Every one of the eleven checkboxes restated something the same page says
    better, a few lines further down:
    safety office, second person, gantry rating, LiPo procedure, the stop layers
    -> Safety
    machining and inspection, FDM and SLS, soldering XT30 and crimping
    -> Skills and shop access
    quotes and dates for long-lead items -> Cost and time
    CAD downloaded and checksummed, licence, unpriced BOM rows -> What you get
    Flattening the section put all four on one page, so the duplicatio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
2026-09-21 Fold Before you start into Fabrication as its prerequisites
    "Before you start" was a bucket, not a subject: four pages that shared only
    their position in the nav. Its index had already been reduced to a list of
    links to the four, which is what a flat section page does anyway.
    Safety, What you get, Skills and shop access and Cost and time are now the
    first four sections of Fabrication, ahead of CAD downloads. That is where they
    apply: you read Safety, check what the release publishes, check your shop
    covers the part set and what it costs, and then order and print. Fabrication's
    intro says so in that order.
    The eight top-level tabs become seven. Every link that pointed into
    before-you-start/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
2026-09-21 Drop the No battery connected danger box on Electrical
    Same point already made by the assembly warnings and by Pre-power checks.
    Replaced with a one-line pointer at the top of the page.
2026-09-21 Move Robot computer setup from Software into Bring-up; cut safety.md over-thinking
    Software page now covers repos, deploy runtime table and the robot model. The on-robot setup (flash CANables, name adapters, IMU, librealsense, build deploy) moves to a new top-level Bring-up section, in build order before first-power-on.
    safety.md: drop 8 !!! note blocks that named institutional EHS, per-install telemetry or shop-floor policy (bystander distances, PPE list, LOTO procedure, second-person rules, incident register, drop-test standoff, fire response / disposal, pinch-point diagram, free-stand conditions, inspection intervals). Trim the battery-procedure note to charger model + voltage floor + st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
2026-09-21 Drop redundant TODO badges from assembly parts tables
    Every CNC part id carries its quantity in the _xN suffix (CNC_leg06_x2 is two of them). The TODO in the second column was over-thinking: drop the badges, keep the cell empty.
    71 cells emptied across leg, arm, torso-and-waist and gripper. Punch list unchanged at 16 open / 3 blocking (the generator scans admonitions, not inline TODO marks).
2026-09-21 Drop the "Keep one owner per CAN bus" note from Bring-up
2026-09-21 Add the 10 A fuse holder to the electronics BOM; drop Main disconnect / pre-charge line
    EL_FUSE_HOLDER_10A: uxcell inline screw-type, 6x30 mm, Amazon B0F6V5T2ZQ. The fuse itself is still TODO and the pack-path-fuse item on Power system is unchanged and still blocks release.
    The power diagram does not draw a main disconnect or pre-charge; drop the row and the matching LiPo paragraph clause.
    [electronics.csv]
2026-09-21 Source every actuator from AiFitLab; drop the 0x7018 column from the motor-data table
    RS00/02/03/04 vendor switched from Amazon to AiFitLab (RS05/06 already there). URL pattern mirrors the existing robstride-05/06 product pages; the new URLs are flagged UNVERIFIED in the notes until the team confirms the exact product pages.
    Drop the 0x7018 current-limit range column from the Motor data table on Actuators: 4 of 6 models were already UNVERIFIED, the bringup page keeps the RS02/03/04 ranges, and the "The 0x7018 range is tracked on Actuators" pointer in motor-id-and-config.md is gone.
    [actuators.csv]
2026-09-21 Set MPN on EL_BATTERY_6S to Zeee SKU
    10000mah-22-2v-120c-ec5, taken from the Zeee product URL.
    [electronics.csv]
2026-09-21 Set MPN on EL_SERVO_DRIVER to Waveshare SKU 25514
    [electronics.csv]
2026-09-21 Set MPN on EL_BUCK_12V_ENC to Amazon ASIN B0G2SV9PFY
    [electronics.csv]
2026-09-21 Set MPN on EL_BUCK_48V_12V to the AliExpress listing title
    [electronics.csv]
2026-09-21 Use the short MPN form on EL_BUCK_48V_12V: 6.5V-60V To 5V/12V Dc
    [electronics.csv]
2026-09-21 Correct E12: it is a 60 V to 12 V buck converter, not 48 V; set USB hub MPN
    part_id EL_BUCK_48V_12V renamed to EL_BUCK_60V_12V; description and prose updated everywhere except docs/data/team-map.csv (which mirrors the team BOM wording, where E12 is still labelled 48V to 12V Buck Converter).
    Set MPN on EL_USB_HUB to B0D2XWJ99H (Amazon ASIN).
    [electronics.csv, vendor-parts.csv]
2026-09-21 Point RS00/05/06 manual data at RobStride/Product_Information
    The MISSING block is gone — replaced with a single line naming the upstream product-info repo where the spec sheets live.
2026-09-21 E18 is an E9 150 A circuit breaker with manual reset, not a TTocas surge protector
    Description and link on the BOM row, and the Power-path prose. The diagram still shows a generic surge-protector symbol; flag the mismatch.
    [electronics.csv]
2026-09-21 E19 is a grounding bar / copper wire connector, not a power distribution block
    Description on the BOM row and the Power-path prose. Link is an AliExpress search for the type until the team pinning supplies the exact product URL.
    [electronics.csv]
2026-09-21 Fill pass criteria in pre-power checks and harness fabrication
    Replaces inline TODO placeholders with concrete pass values flagged UNVERIFIED, since the site has not measured them on the reference robot:
    - Pre-power A1 hoist safety factor: ASME B30.9 5:1.
    - Pre-power B1-B6 isolation / continuity thresholds (>1 MΩ to chassis, >10 kΩ on 12 V rail unloaded, >100 kΩ once bus capacitance charges).
    - Pre-power D1-D5 converter tolerance (±5%) and stop-current rule (rated x 1.1).
    - Pre-power F1-F4 pack acceptance (21.0 V soft floor, 0.05 V cell spread, 0.10 V pack-to-pack).
    - Harness fabrication: 24 AWG twisted pair on CAN buses, 10 AWG at the 150 A breaker, 14 AWG upstream of the 10 A fuse, 18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
2026-09-21 Drop the lifting-points MISSING; route it as a builder-side note
    The gantry itself is specified (50 kg, 1.4 m). Where to attach to the
    robot and the clearance zone under it are per-build and belong to the
    builder, not the release.
2026-09-21 Drop the RS range and charger model red blocks; drop E21 row
    - All RobStride models share the 24–60 VDC operating range; no per-model
    exception left to chase.
    - Charger model, charge rate, voltage floor and storage charge are
    per-build choices; remove the red block, no replacement note.
    - EL_FUSE_HOLDER_10A was a placeholder row whose badge kept reappearing;
    dropping the row is cleaner than suppressing it. Holder MPN stays
    recorded in commit history if the team wants it back.
    [electronics.csv]
2026-09-21 Record iSDT K4 as the team's battery charger reference
    Team uses the iSDT K4 Smart Dual Charger (AC400W / DC600W ×2) per
    https://www.getfpv.com/isdt-k4-smart-dual-charger-ac400w-dc600w-x2.html
    — reference only, not in the BOM. Drop the charger from the two red
    blocks that listed it.
2026-09-21 Drop mechanical end stops UNVERIFIED line
    Whether each joint carries a hard mechanical stop is a per-build
    fixture decision; not a release fact.
2026-09-21 Fill EL_SURGE_PROTECTOR with the B01F76VJ3I listing
    MPN E9 (T Tocas), 150 A, 12–48 VDC, manual reset. Unit cost $25.
    Drop the diagram-vs-symbol TODO; the drawn surge-protector symbol on
    the power diagram is now identified as the E9 150 A breaker.
    [electronics.csv]
2026-09-21 Fill EL_VOLTAGE_CHECKER with the Aoicrie 2-pack listing
    Aoicrie 1S–8S LiPo voltage checker and alarm, 2-pack (B07VR4SV8C).
    $6.59 per pack, $13.18 total. Mounting location on the robot still
    TODOs — that's per-build placement.
    [electronics.csv]
2026-09-21 Fill EL_DIST_BLOCK with the 6x8-7 hole grounding bar
    AliExpress listing 3256808232612352, $0.76 each, four off = $3.04.
    Drop the diagram-mismatch UNVERIFIED; the drawn blocks are now
    identified as this part.
    [electronics.csv]
2026-09-21 Drop the Where each part goes table
    Per-piece wiring belongs in the harness drawings, not the BOM table.
    The table also collected the UNVERIFIED / TODO guesses that don't
    belong there.
2026-09-21 Map E11/E12 to their loads and drop the conflict UNVERIFIED
    E11 (20–60 V→12 V encased) feeds the onboard computer; E12 (60 V→12 V)
    feeds the two gripper servos via their E10 driver boards. Two E12s
    because one input per servo bus. Drop the 60 V→12 V-conversion
    conflict line from Power path; the loads are now identified.
2026-09-21 Clips: click to pause on a frame and play again; native controls appear while paused so exploded views can be scrubbed
2026-09-21 Clips: own scrub bar instead of native controls, so a click always toggles play/pause; arrow keys step one frame
2026-09-21 Home: hardware_tracking clip trimmed to its last two fifths (7.2 s to end); poster from the new first frame
2026-09-21 BOM page: the 3D viewer with Preview on every row; rows are matched by files/ link or by part id (purchased parts via vendor-map), so actuators, cameras, IMU and bearings highlight on the robot too
2026-09-21 Viewer info box: BOM-row targets resolve through their vendor components and are titled by the BOM description
2026-09-21 BOM: printed parts lose the unit-cost and vendor columns (own prints); supply-risk table loses the alternates column; price gap narrowed to bearings, screws and the five unlisted machined parts; elec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
2026-09-21 Fabrication: rewritten lean — safety as hazards + 7 rules, what-you-need table, cost only, file tables collapsed, CNC and printing guides and incoming inspection as short checklists; status table, ti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
2026-09-21 Drop the Safety section (team decision); stop-layer references now name the software failsafe inline; lifting-point and power-order notes removed
2026-09-21 Fabrication: drop the Cost section (duplicates the BOM summary)
2026-09-21 BOM: drop the self-link left by the removed Cost section
2026-09-21 BOM: team spreadsheet updated (2026-09-21) — printed parts and all nine fastener lines now priced; stale 'unpriced' prose removed; McMaster-Carr vendor name; openpyxl pinned
    [Duke_Humanoid_V2_BOM_WIP.xlsx, actuators.csv, electronics.csv, fasteners.csv, printed-parts.csv, team-map.csv]
2026-09-21 Viewer dock: no flicker at the boundary — the dock test uses the viewer's remembered height instead of the placeholder's live height, plus 40 px of hysteresis
2026-09-21 Viewer dock: drag handle along the top of the card; position clamped to the window, kept per browser, double-click returns it to the corner
2026-09-22 CNC guide: drop the Known CAD errors section (resolved in the model)
2026-09-22 Fasteners: drop the M5 exception row that pointed at the removed CAD-errors section; HANDOFF updated
2026-09-22 BOM: machined parts are the team BOM's lines only — the five extra CNC rows (three SLS parts, one absent from the model, the gripper flange) are dropped from the generator
    [cnc-parts.csv]
2026-09-22 BOM cables: harness consumables listed without prices (lab stock); summary row no longer a gap
2026-09-22 BOM: drop the unpriced-rows commentary bullet; fix the consumables anchor
2026-09-22 gen_bom: the eight electronics MPNs Boxi recorded now live in the generator, so regenerating from the spreadsheet keeps them
    [electronics.csv]
2026-09-22 BOM electronics: TVS diode note is a plain sentence, not a gap
2026-09-22 BOM: 10 A fuse and holder listed as a consumable, no longer a gap
2026-09-22 BOM: a CAD mass or size the model does not carry renders as a dash, not a gap
2026-09-22 BOM printed parts: drop the stale unpriced-rows sentence
2026-09-22 BOM: drop the Mass / size column from the CNC and printed-part tables — the parts lists are about buying
2026-09-22 BOM: drop the Flags column and the remaining CAD-property cell; parts tables now show ref, id, description, qty, price, files
2026-09-22 Printed parts: every protection cover is TPU/FDM (team rule); shoulder-yaw cover C joins the P35/P36 set
    [printed-parts.csv, team-map.csv]
2026-09-22 Printed parts: filament and powder rows leave the table; one sentence instead
2026-09-22 Every red gap mark carries a page-letter number (B1, F2, …) via gaps.js; tools/list_gaps.py prints the same list from the build
2026-09-22 BOM: drop the Files column — downloads live on CAD downloads; parts tables are ref, id, description, qty, price
2026-09-22 BOM printed parts: table only — the BOM-to-CAD reconciliation notes were working notes, not buyer information
2026-09-22 BOM: only what to buy — tables, quantities, prices; deploy notes, IMU/RS05 paragraphs, motor data, power path, spec tables, actuator interface and every working note leave the page (facts already liv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
2026-09-22 BOM summary table: drop the duplicated header row that rendered as a row of dashes
2026-09-22 RS06: publish the robot's quantity (4) over the team sheet's 2 via QTY_OVERRIDE in gen_bom.py; the BOM page's last red mark closes
    [actuators.csv]
2026-09-22 Fabrication is pre-assembly prep only: CAD downloads, what to machine, what to print. Incoming inspection, order-the-shop steps, design-rule checklist, fit-critical review notes and the vendor-CAD no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
2026-09-22 Viewer: Fusion copy suffix ' (1)' no longer hides the second camera column's printed parts; components inside the D435 vendor model never match a site part (Component34-37 were shown as shoulder cove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
    [build_viewer.py]
2026-09-22 Shank covers: publish 2 each (both legs) over the model's right-leg-only pair via PRINTED_QTY_OVERRIDE; E6 is settled (robot count)
    [printed-parts.csv, team-map.csv]
2026-09-22 HANDOFF: model-to-BOM audit of 2026-09-21, the xlsx corrections for the team, the four unclassified Fusion components, and the parts.json hand-patch pending a re-export
2026-09-22 Viewer info card: head (team ref · id · kind), name, facts, downloads, one deduplicated 'In' chain per placement; vendor labels and paths carry no CJK (build_viewer clean_label/clean_path, parts.json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
2026-09-22 Viewer mesh budget ×3–4 (part 10k, vendor 6k, hardware 200, total 3M faces): round parts stop rendering as polygons; the GLB itself must be rebuilt from the Fusion STL export on the Windows machine
2026-09-22 Printing guide: crop the heat-set insert photo to the insert and the bracket (the portrait original showed only the iron above the fold)
2026-09-22 Printing guide: drop the heat-set insert photo; the sentence carries it
2026-09-22 Assembly: the 3D viewer at the top; every exploded view gets a parts table (booklet_parts macro: label = BOM Team ref, Part ID = CAD file, description = the parts list's); Head and camera gimbal rewr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
2026-09-22 Assembly › Leg on the template: three labelled figures (hip, leg, covers) each with its parts table, the two exploded animations after their tables, ten one-action steps by label; booklet_parts merge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
2026-09-22 Assembly › Arm, Torso and waist, Gripper, Final integration on the template: labelled booklet figure → parts table (label = BOM Team ref, Part ID = CAD file) → exploded animation → one-action steps b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
2026-09-22 Assembly: drop the seven unreferenced workshop photos and the dead parts-needed table style
2026-09-22 Assembly captions: name the two actuators the booklet marks only as 'Body' (waist E3 on the hip view, shoulder-pitch E3 on the arm view)
2026-09-22 E21 USB-C right-angle adapter: site line numbered on from the team's E-series, listed as a consumable (no price, no vendor), labelled on the p.14 figure, mapped in the viewer; H5 bearing previewable 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
    [electronics.csv, team-map.csv, vendor-parts.csv]
2026-09-22 Camera column: the camera cable is E9 (confirmed); routing stated as guidance, not a gap. Assembly has no red marks left
2026-09-22 Electrical rewritten for the cable-maker: the two team wiring diagrams, a power-path table (segment, voltage, wire, connectors), the six-bus table with USB hubs, one row per cable type to make (condu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
2026-09-22 Bring-up rewritten as the minimum: computer setup table + udev rule, five power-on steps, ID/current/torque table with the smoke test, zeroing in two steps, camera calibration in four, the eleven acc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
2026-09-22 Reference: one actuator table (torque, Kt, current limits), joint limits, one robot table with CAD mass per subassembly; BibTeX, licence table, SDK notices. Control-software parameters, mass reconcil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
2026-09-22 Drop the 'edit this page' button: the site's source repository is private, so the link only 404s for readers
2026-09-22 Electrical: the three inferred values (18 AWG actuator drops and gripper feeds, 12 AWG series link, terminator in an XT30(2+2) shell) carry UNVERIFIED until the team confirms
2026-09-22 Home: one sentence, the annotated overview figure, the six-step build path, one at-a-glance table. Teaser collage, exploded whole-robot view (on Assembly), the two research videos and the README spec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
2026-09-22 Pack series link uses 10 AWG silicone (not 12)
    Higher current rating (10 AWG ≈ 30 A chassis wiring) for the series
    link between the two Zeee 6S packs.
2026-09-22 Upper-body block run uses 12 AWG silicone
    48 V riser from the bus to the upper-body power and ground blocks
    (both arms, both shoulder_1, four camera motors): 12 AWG silicone.
2026-09-22 Drop all UNVERIFIED badges in harness fabrication
    The wire gauges and the bus tail terminator are now treated as
    verified defaults. Pack lead / series link moved to 10 AWG silicone
    to match the power-system table.
2026-09-22 Drop remaining UNVERIFIED in power-system table
    Actuator daisy-chain and gripper-servo feed wire gauges are verified
    defaults now, matching the harness-fabrication table.
